cruiser0002/ResinShield/RS3C/BOM.xlsx

Item # | Ref Des | Description | Quantity | Manufacturer | Mfg Part # | Package | Type | Cost reduction
1 | U1 | IC REG MULT CONFIG INV | 1 | Linear | LT3579EFE#PBF | 20-TSSOP-EP | SMD
2 | U2 | IC REG LDO 5V 1A SOT223 | 1 | ON Semiconductor | NCP1117ST50T3G | SOT-223 | SMD | Compatible part
3 | U3 | Dual 12-Bit DAC | 1 | Linear | LTC2622CMS8#PBF | MS8 | SMD
4 | U4 | IC VREF SHUNT 4.096V | 1 | Texas Instruments | LM4040DIM3-4.1/NOPB | SOT-23 | SMD | Compatible part
5 | U5 | IC OPAMP JFET 4MHZ 14SO | 1 | STMicroelectronics | TL084CDT | 14-SOIC | SMD | Compatible part
6 | D1, D2 | DIODE SCHOTTKY 40V 2A SMB | 2 | Diodes Inc | B240-13-F | SMB | SMD | Compatible part
7 | D3 | DIODE ZENER 18V 200MW | 1 | ON Semiconductor | MM3Z18VST1G | SOD323 | SMD | Compatible part
8 | Q1 | MOSFET N-CH 20V 6.3A SOT-23 | 1 | Infineon | IRLML6244TRPBF | SOT23-3 | SMD | Compatible part
9 | R1, R4, R10, R29, R31, R32, R39, R40 | RES SMD 0.0OHM JUMPER 1/10W 0603 | 8 |  |  | 603 | SMD | Preserve case size, value, accuracy. Use cheapest source
10 | R3 | RES SMD 165K OHM 1% 1/10W 0603 | 1 |  |  | 603 | SMD | Preserve case size, value, accuracy. Use cheapest source
11 | R8, R11, R12, R17, R18, R19, R20, R21, R22, R23, R24, R25, R26, R27, R28, R34, R37 | RES SMD 100K OHM 1% 1/10W 0603 | 18 |  |  | 603 | SMD | Preserve case size, value, accuracy. Use cheapest source
12 | R7 | RES SMD 84.5K OHM 1% 1/10W 0603 | 1 |  |  | 603 | SMD | Preserve case size, value, accuracy. Use cheapest source
13 | R5, R9, R13, R42 | RES SMD 10K OHM 1% 1/10W 0603 | 3 |  |  | 603 | SMD | Preserve case size, value, accuracy. Use cheapest source
14 | R15, R35, R36 | RES SMD 25 OHM 1% 1/10W 0603 | 3 |  |  | 603 | SMD | Preserve case size, value, accuracy. Use cheapest source
15 | C2, C3, C4, C5, C12, C13, C18, C19, C23, C27, C28 | 22µF ±10% 25V X5R | 11 | Murata | GRM32ER61E226KE15L | 1210 | SMD | Preserve case size, value, accuracy. Use cheapest source
16 | C6 | 4700pF ±10% 50V X7R | 1 | Samsung | CL10B472KB8NNNC | 603 | SMD | Preserve case size, value, accuracy. Use cheapest source
17 | C7, C9, C10, C11, C14, C15, C22, C25, C26, C29 | 1µF -20%, +80% 50V Y5V | 10 | Samsung | CL21F105ZBFNNNE | 805 | SMD | Preserve case size, value, accuracy. Use cheapest source
18 | C8, C16, C17, C20, C21 | 47pF ±5% 50V C0G, NP0 Ceramic Capacitor | 5 | Samsung | CL10C470JB8NNNC | 603 | SMD | Preserve case size, value, accuracy. Use cheapest source
19 | T1, T2 | INDUCT ARRAY 2 COIL 10UH | 2 | Bourns | SRF0703-100M | Nonstandard | SMD
20 | J1 | 24 Positions Header, Unshrouded Connector 0.100" (2.54mm) Through Hole Gold | 1 | Wurth | 61302421121 | 12x2 MALE | Through-hole | Non-gold contacts.
21 | J2 | 10 Positions Header, Unshrouded Connector 0.100" (2.54mm) Through Hole Gold | 1 | Wurth | 61301011121 | 10x1 MALE | Through-hole | Non-gold contacts.
22 | J3-4 (optional) | CONN HEADER 3 POS 2.54 | 2 |  |  | 5x2 MALE | Through-hole
23 | J5 | 3 Positions Header, Unshrouded Connector 0.100" | 1 | MOLEX | 22272031 | 3x1 MALE | Through-hole | Non-gold contacts.
24 | J6-7 | 3 Position Receptacle Connector 0.098" (2.50mm) Through Hole Tin | 2 | JST | 03JQ-BT | 3x1 JST FEMALE | Through-hole
25 | J8 | 2 Positions Header, Shrouded Connector 0.098" (2.50mm) Through Hole Tin | 1 | JST | B2B-XH-A | 3x1 JST MALE | Through-hole
26 | J9 | 3 Positions Header, Unshrouded Connector 0.100" (2.54mm) Through Hole Gold | 1 | Wurth | 61300311121 | 3x1 MALE | Through-hole | Non-gold contacts.
27 | J10 | 4 Positions Header, Unshrouded Connector 0.100" (2.54mm) Through Hole Gold | 1 | Wurth | 61300411121 | 4x2 MALE | Through-hole | Non-gold contacts.
28 | J11-12 | Connector Receptacle 8 Position 0.100" (2.54mm) Tin Through Hole | 2 | Samtec Inc | SSW-108-03-T-S | 8x1 THROUGH HEADER | Through-hole | Non-gold contacts.
29 | J15 | 15 Positions Header, Unshrouded Connector 0.100" (2.54mm) Through Hole Gold | 1 | Wurth | 61301511121 | 15x1 MALE | Through-hole | Non-gold contacts.
