cruiser0002/ResinShield/documentation/BOM.xlsx

 |  |  |  |  |  |  |  |  | 11.02
Resin Shield
Item # | Ref Des | Description | Quantity | Manufacturer | Mfg Part # | Package | Type | Cost Reduction Method |  | Second source
1 | U1 | IC REG BOOST ADJ 2A 8MSOP | 1 | Semtech | SC4501MSETRT | 8-MSOP-EP | SMD | Cost Reduce | 1.73
2 | U2 | IC REG MULT CONFIG INV ADJ 8MSOP | 1 | Linear | LT3580EMS8E#TRPBF | 8-MSOP-EP | SMD | Cost Reduce | 4.22
3 | U3 | IC REG LDO ADJ 1A SOT223 | 1 | ON Semi | NCP1117STAT3G | SOT-223 | SMD | Part Substitution | 0.49
4 | U4 | IC DAC 12BIT DUAL R-R VOUT 8MSOP | 1 | Linear | LTC2622CMS8#PBF | 8-MSOP | SMD | Cost Reduce | 3.34
5 | U5 | IC VREF SHUNT 5V SOT23-3 | 1 | Texas Instruments | LM4040D50IDBZR | SOT-23-3 | SMD | Part Substitution | 0.72 | LM4040DYM3-5.0 TR
6 | U6 | IC OPAMP JFET 1MHZ 14SOIC | 1 | Texas Instruments | TL064CDR | SOT-23-3 | SMD | Part Substitution | 0.52
7 | D1, D2 | DIODE SCHOTTKY 40V 1A SMB | 1 | Diodes Inc | B140B-13-F | SMB | SMD | Part Substitution
8 | Q1 | MOSFET N-CH 20V 6.3A SOT-23 | 1 | International Rectifier | IRLML6244TRPBF | SOT23-3 | SMD | Part Substitution
 |  | MOSFET P-CH 20V 3.7A SOT-23 | 1 | International Rectifier | IRLML6402TRPBF | SOT23-3 | SMD | Part Substitution
 | R1, 4, 20, 24 | RES SMD 8.87K OHM 1% 1/10W 0603 | 4 | Yageo | RC0805FR-078K87L | 0603 | SMD | Part Substitution
 | R2, 5-19, 21-23, 25-27 | RES SMD 100K OHM 1% 1/10W 0603 | 22 | Yageo | RC0805FR-07100KL | 0603 | SMD | Part Substitution
 | R3 | RES SMD 182K OHM 1% 1/8W 0805 | 1 | Yageo | RC0805FR-07182KL | 0603 | SMD | Part Substitution
 | C26-29, 31 | CAP CER 47PF 50V 5% NPO 0805 | 5 | Yageo | CC0805JRNPO9BN470 | 0603 | SMD | Part Substitution
 | C3, 9, 10 | CAP CER 4700PF 50V 10% X7R 0805 | 3 | Yageo | CC0805KRX7R9BB472 | 0603 | SMD | Part Substitution
 | C5 | CAP CER 1UF 50V Y5V 0805 | 1 | Taiyo Yuden | UMK212F105ZG-T | 0805 | SMD | Part Substitution
 | C1, 2, 4, 7, 8, 11, 13, 20, 22 | CAP CER 10UF 50V 20% X5R 1210 | 9 | Taiyo Yuden | UMK325BJ106MM-T | 1210 | SMD | Part Substitution
 | L1 | FIXED IND 5.6UH 3.6A 48 MOHM SMD | 1 | Wurth | 74437346056 | 7.30mm x 6.60mm | SMD | Part Substitution
 | L2 | FIXED IND 10UH 3A 85 MOHM SMD | 1 | Wurth | 74437346100 | 7.30mm x 6.60mm | SMD | Part Substitution
 | L3 | FIXED IND 22UH 1.9A 190 MOHM SMD | 1 | Wurth | 74437346220 | 7.30mm x 6.60mm | SMD | Part Substitution
 | JP3-9, 13 | CONN HEADER 3 POS 2.54 | 8 | Wurth | 61300311121 | 3x1 HEADER | Through-hole | Part Substitution
 | JP1 | CONN HEADER VERT DUAL 6POS 2.54 | 1 | Wurth | 61300621121 | 3x2 HEADER | Through-hole | Part Substitution
 | JP2, 10, 14 | CONN HEADER 4 POS 2.54 | 3 | Wurth | 61300411121 | 4x1 HEADER | Through-hole | Part Substitution
 | Arduino Mega | CONN HEADER 6 POS 2.54 | 1 | Wurth | 61300611121 | 6x1 HEADER | Through-hole | Part Substitution
 | Arduino Mega | CONN HEADER 8 POS 2.54 | 4 | Wurth | 61300811121 | 8x1 HEADER | Through-hole | Part Substitution
 | A4988 Carrier | Connector Header 8 Position 0.100" (2.54mm) Tin Through Hole | 2 | Sullins Connector Solutions | PPTC081LFBN-RC | 8x1 HEADER | Through-hole | Part Substitution
 | LCD HEADERS |  |  |  |  | 10x2 HEADER
 | Arduino Mega | CONN HEADER VERT DUAL 36POS 2.54 | 1 | Wurth | 61303621121 | 18x2 HEADER | Through-hole | Part Substitution
 | JP1 | JUMPER W/TEST PNT 1X2PINS 2.54MM | 3 | Wurth | 60900213421 | 1x2 JUMPER |  | Part Substitution
 | Plugs into headers | A4988 Stepper Motor Driver | 1 | SainSmart | 20-011-964 | Complete board |  | Part Substitution
 | Plugs into headers | Arduino Mega 2560 | 1 | SainSmart | 20-011-910 | Complete board |  | Part Substitution
