cruiser0002/ResinShield/RevF/BOM.xlsx

 | RefDes | Name | Value | Description | Quantity | Pattern | Manufacturer | MPN
Fitted | C101, C102, C104, C108, C110, C113, C117, C118, C208, C209 | CAP_0805 | 10u | CAP CER 10UF 25V X5R 0805 | 10 | CAP_0805 |  | GRM21BR61E106KA73K | 99
Fitted | C103, C105, C112, C114, C115, C116, C202, C206, C207, C210, C301, C401 | CAP_0805 | 1u | CAP CER 1UF 35V X5R 0805 | 12 | CAP_0805 |  | GRM219R7YA105MA12D | 18
Fitted | C106, C109, C201, C203, C204, C205, C403 | CAP_0603 | 100p | CAP CER 100PF 50V C0G/NP0 0603 | 7 | CAP_0603 |  | C0805C101J5GACTU
Fitted | C107, C111 | CAP_0603 | 6.8n | CAP CER 6800PF 50V C0G/NP0 0603 | 2 | CAP_0603 |  | CL21B682KBANNNC
Fitted | C302, C303 | CAP_1210 | 22u | CAP CER 22UF 16V X5R 1210 | 2 | CAP_1210 |  | CL32A226MOJNNNE
Not-fitted | C402, C502 | CAP_0805 | opt |  | 2 | CAP_0805
Not-fitted | C501 | CAP_1210 | opt |  | 1 | CAP_1210
Fitted | D101, D104 | PMEG4020ETP |  |  | 2 | SOD-128 | Nexperia | PMEG4020ETP,115
Fitted | D102, D103, D401 | APL3015SRCPRV-F01 |  |  | 3 | APL3015 | Kingbright | APL3015SRCPRV-F01
Not-fitted | D501, D502 | PMEG4020ETP | opt |  | 2 | SOD-128
Fitted | FB101, FB102, FB201, FB301 | BLM18KG221SN1D | 220 @ 100MHz |  | 4 | RES_0603 | Murata | BLM18KG221SN1D
Not-fitted | FD1, FD2, FD3 | Fiducial |  |  | 3 | Fiducial
Fitted | J1, J2, J4, J5, J7, J8 | 644456-8 |  |  | 6 | HDR-1x8T/2.54/20x2 | TE Connectivity | 3-644456-8
Fitted | J3 | 90131-0138 |  |  | 1 | HDR-2x18T/2.54x2.54/46x5 | Molex | 90131-0138
Not-fitted | J6, J9 | 90131-0125 | opt |  | 2 | HDR-2x5T/2.54x2.54/13x5 | Molex | 90131-0125
Not-fitted | J10, J203 | 644456-4 | opt |  | 2 | HDR-1x4T/2.54/10x2 | TE Connectivity | 61300411121
Fitted | J11, J12, J13, J301 | 644456-4 |  |  | 4 | HDR-1x4T/2.54/10x2
Fitted | J101 | 22272031 |  |  | 1 | Molex 3pin | Molex | 0022272031
Fitted | J201, J202 | B3B-XH-A |  |  | 2 | JST B3B-XH-A | JST | B3B-XH-A(LF)(SN)
Fitted | J302, J303 | PPTC081LFBN-RC |  |  | 2 | HDR-1x8T/2.54/20x2 | Sullins | PPTC081LFBN-RC
Fitted | J401, J402 | B2B-XH-A |  |  | 2 | JST B2B-XH-A | JST | B2B-XH-A(LF)(SN)
Not-fitted | J501 | OSTVN04A150 | opt |  | 1 | TB-1x4/2.54/11x7/Sc_H | On Shore | OSTVN04A150
Not-fitted | J502 | 644456-2 | opt |  | 1 | HDR-1x2T/2.54/5x2 | TE Connectivity | 3-644456-2
Fitted | Q401, Q402, Q403 | 2N7002 |  |  | 3 | SOT23 | Diodes | 2N7002-7-F
Not-fitted | Q501, Q502 | IRLZ44N | opt |  | 2 | TO-220 | Infineon | IRLZ44NPBF
Not-fitted | R1, R302, R304, R305, R306, R307, R406, R501, R502, R503, R504, R505 | RES_0603 | opt |  | 12 | RES_0603
Fitted | R101, R115 | RES_1210 | 0 | RES SMD 0 OHM JUMPER 1/2W 1210 | 2 | RES_1210 |  | CRCW12100000Z0EA
Fitted | R102, R103, R108, R205, R210 | RES_0603 | 49k9 | RES SMD 49.9K OHM 1% 1/10W 0603 | 5 | RES_0603 |  | ERJ-3EKF4992V
Fitted | R104, R106, R112, R113, R202, R203, R204, R206, R207, R208, R209, R211, R401, R403, R404 | RES_0603 | 100k | RES SMD 100K OHM 1% 1/10W 0603 | 15 | RES_0603 |  | AT0603FRE07100KL
Fitted | R105, R114 | RES_0603 | 464k | RES SMD 464K OHM 1% 1/10W 0603 | 2 | RES_0603 |  | RC0603FR-07464KL
Fitted | R107, R111, R402 | RES_0603 | 24k9 | RES SMD 24.9K OHM 1% 1/10W 0603 | 3 | RES_0603 |  | ERJ-3EKF2492V
Fitted | R109, R405 | RES_0603 | 6k04 | RES SMD 6.04K OHM 1% 1/10W 0603 | 2 | RES_0603 |  | ERJ-3EKF6041V
Fitted | R110 | RES_0603 | 53k6 | RES SMD 53.6K OHM 1% 1/10W 0603 | 1 | RES_0603 |  | RC0603FR-0753K6L
Fitted | R201 | RES_0603 | 1k | RES SMD 1K OHM 1% 1/10W 0603 | 1 | RES_0603 |  | ERJ-3EKF1001V
Fitted | R212, R213 | RES_0603 | 24r9 | RES SMD 24.9 OHM 1% 1/10W 0603 | 2 | RES_0603 |  | ERJ-3EKF24R9V
Fitted | R301, R303 | RES_0603 | 0 | RES SMD 0 OHM JUMPER 1/10W 0603 | 2 | RES_0603 |  | ERJ-3GEY0R00V
Fitted | R407 | RES_0603 | 18r2 | RES SMD 18.2 OHM 1% 1/10W 0603 | 1 | RES_0603 |  | ERJ-3EKF18R2V
Fitted | T101, T102 | SRF1260-150M | 15uH |  | 2 | SRF1260 | Bourns | SRF1260-150M
Not-fitted | TP101, TP102, TP103, TP201, TP202, TP203, TP204, TP205, TP206, TP207, TP208, TP501, TP502, TP503 | TESTPOINT |  |  | 14 | Round
Fitted | U101 | LT8582 |  |  | 1 | 4x7DFN | Linear Technology | LT8582EDKD#PBF
Fitted | U102 | NCP1117ST50T3G |  |  | 1 | SOT223-4 | ON Semi | NCP1117ST50T3G
Fitted | U201 | LM4040DIM3-4.1 |  |  | 1 | SOT23 | Texas Instruments | LM4040DIM3-4.1/NOPB
Fitted | U202 | TL084D |  |  | 1 | SOIC-14/150mil | Texas Instruments | TL084CDR
Fitted | U203 | LTC2602CMS8 |  |  | 1 | MSOP-8 | Linear Technology | LTC2622CMS8#PBF
Fitted | U401 | LM321MF |  |  | 1 | SOT23-5 | Texas Instruments | LM321MF/NOPB
Not-fitted | X1 | Arduino Mega |  |  | 1
Not-fitted | X301 | A4988 Carrier |  |  | 1
