cruiser0002/ResinShield/fab notes/Projection symbols.dxf

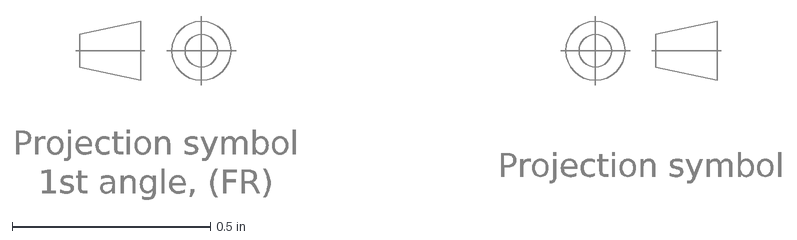
[picture p1: CAD file, 2016-10-16]
fab notes/Projection symbols.dxf
Projection symbol 1st angle, (FR)
Projection symbol\p3rd angle, (US)
