cruiser0002/ResinShield/RS3C/fabnotes.dxf

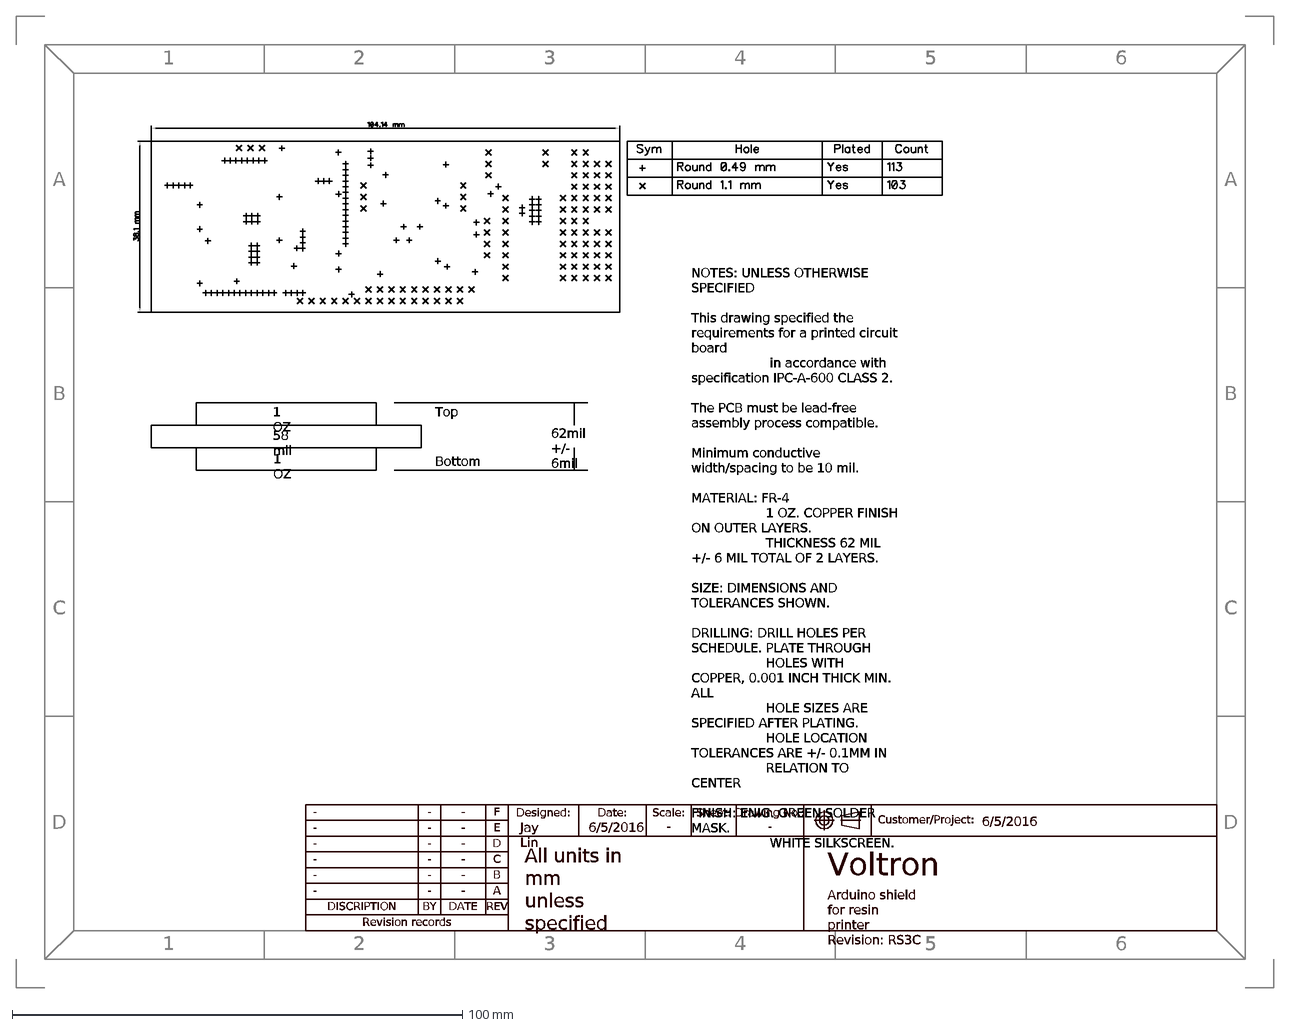
[picture p2: CAD file, 2016-10-16]
RS3C/fabnotes.dxf
1
A
2
3
4
5
6
B
C
D
-
Revision records
DISCRIPTION
BY
DATE
REV
E
F
Customer/Project:
Drawing No.:
Designed:
Date:
Scale:
Sheet:
All units in mm unless specified
Voltron Arduino shield for resin printer Revision: RS3C
6/5/2016
Jay Lin
Bottom
58 mil
62mil +/- 6mil
Top
1 OZ
NOTES: UNLESS OTHERWISE SPECIFIED This drawing specified the requirements for a printed circuit board in accordance with specification IPC-A-600 CLASS 2. The PC
