cruiser0002/ResinShield/fab notes/ANSI A Landscape.dxf

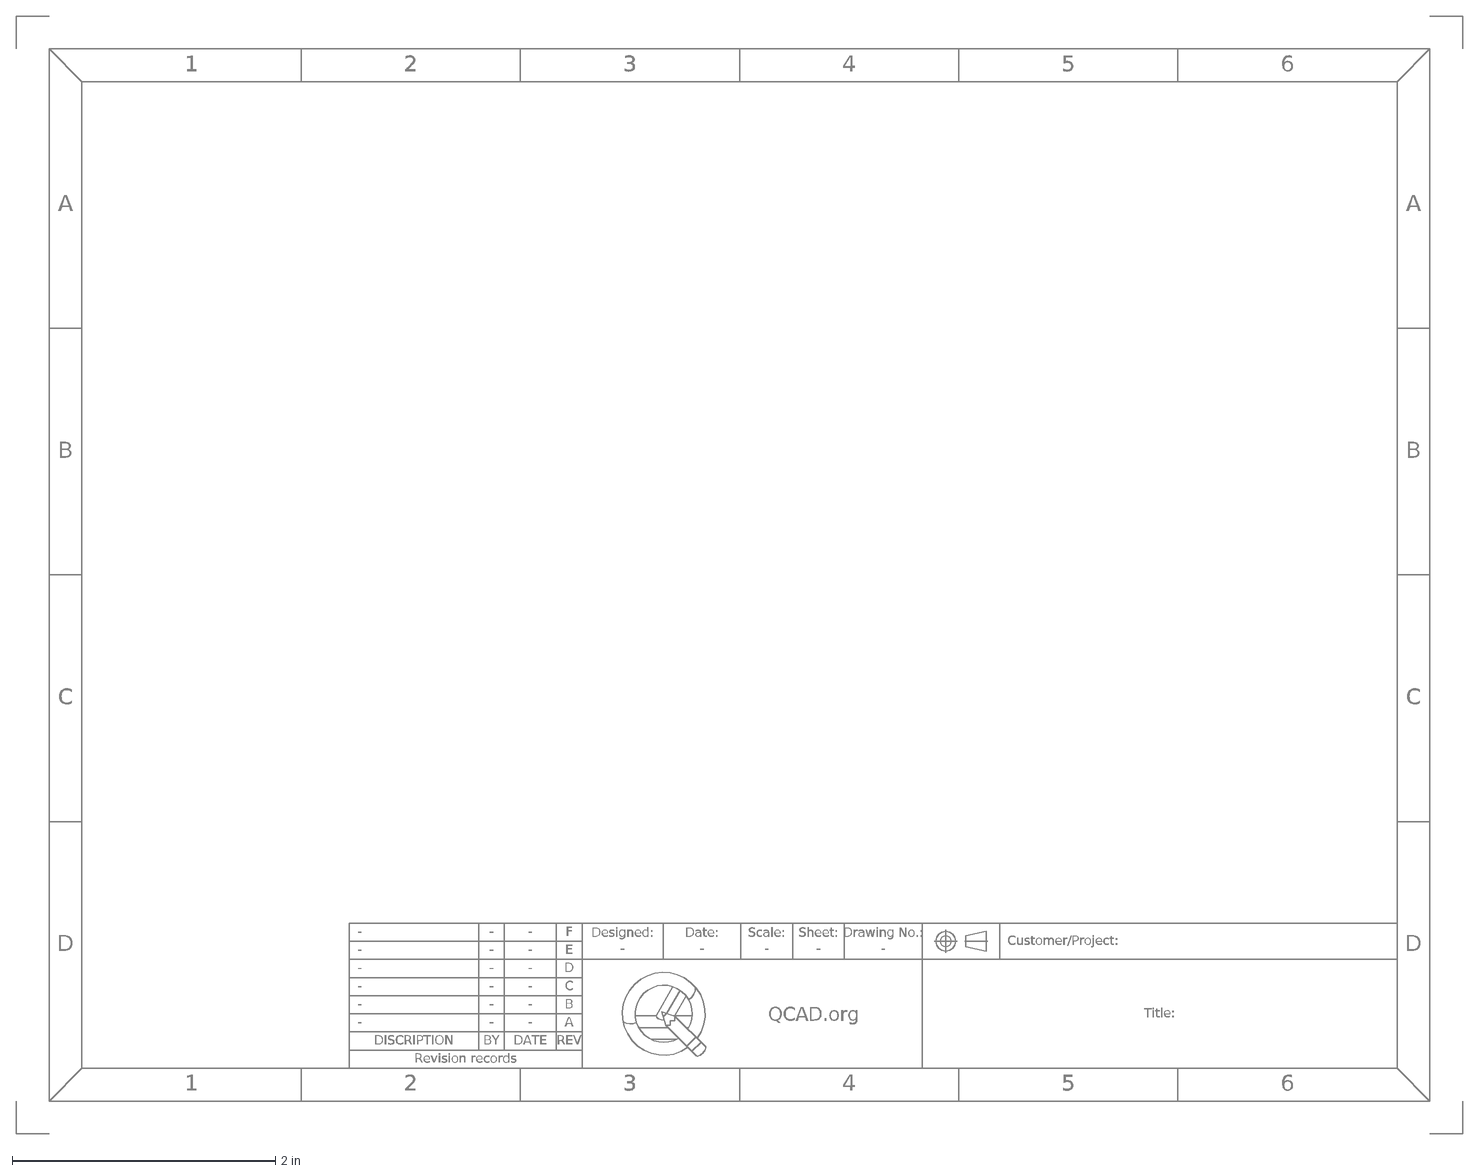
[picture p3: CAD file, 2016-10-16]
fab notes/ANSI A Landscape.dxf
1
A
2
3
4
5
6
B
C
D
-
Revision records
DISCRIPTION
BY
DATE
REV
E
F
Title:
Customer/Project:
Drawing No.:
Designed:
Date:
Scale:
Sheet:
QCAD.org\pOpen source CAD
