cruiser0002/ResinShield/fab notes/ANSI B Landscape.dxf

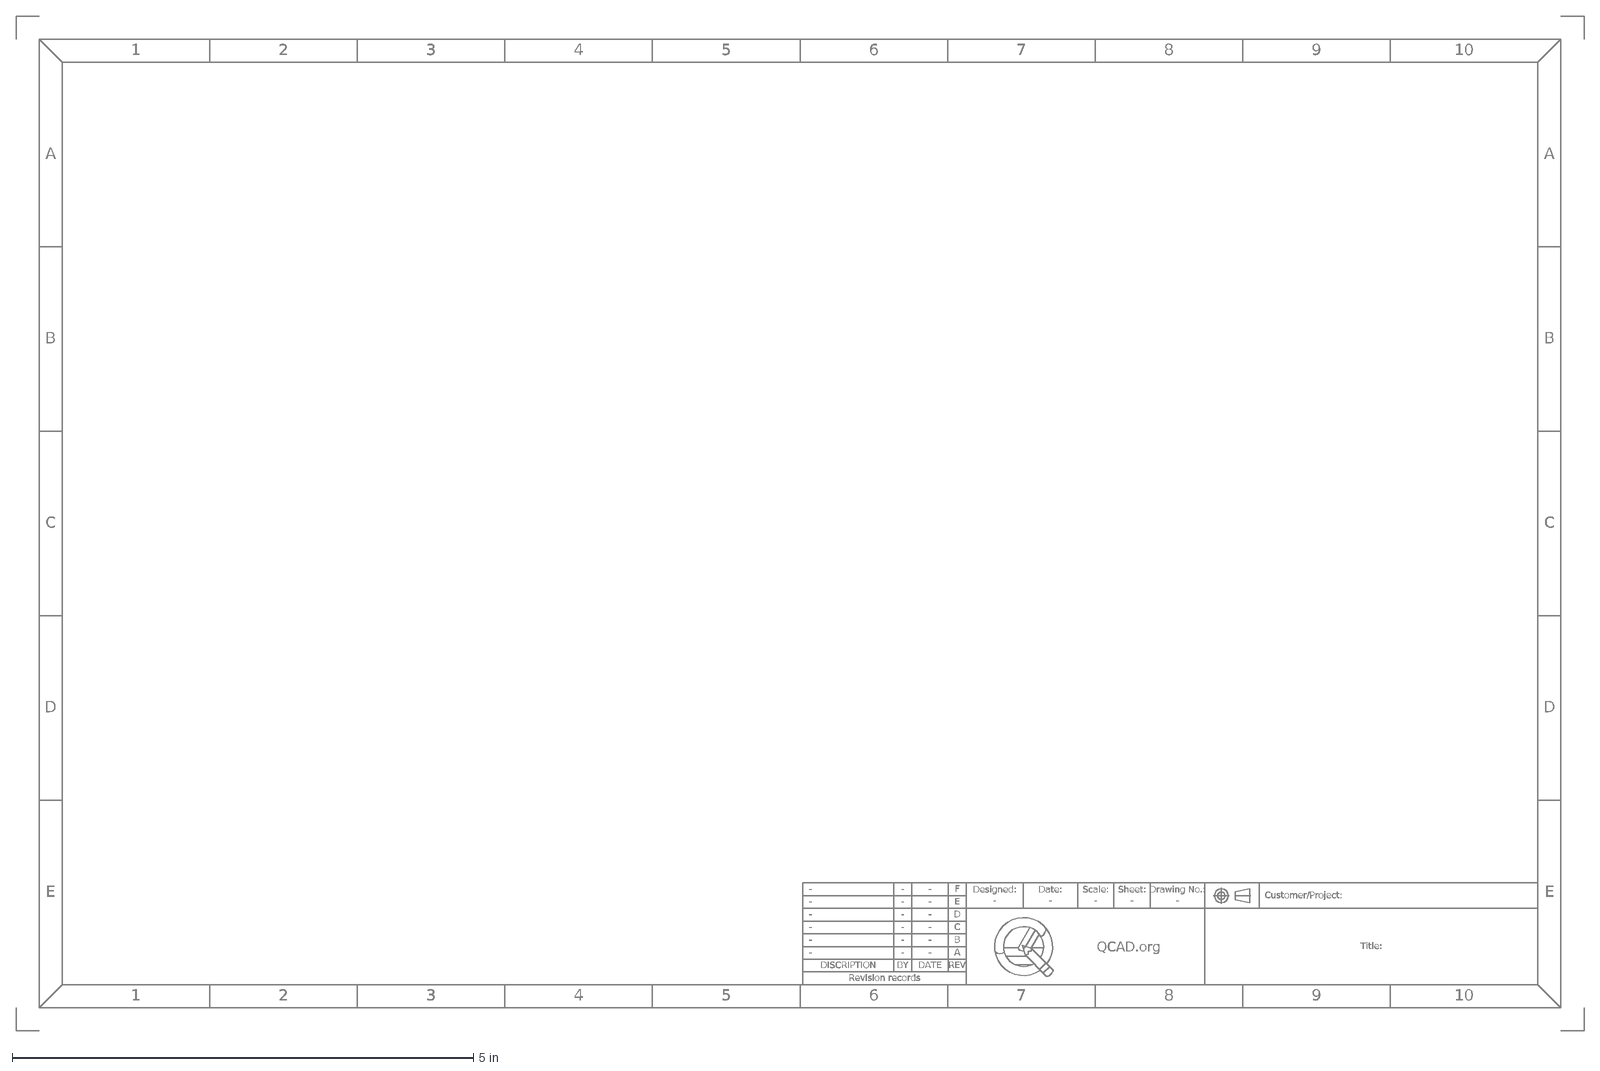
[picture p4: CAD file, 2016-10-16]
fab notes/ANSI B Landscape.dxf
E
1
D
C
B
A
2
3
4
5
6
7
8
9
10
-
Revision records
DISCRIPTION
BY
DATE
REV
F
Title:
Customer/Project:
Drawing No.:
Designed:
Date:
Scale:
Sheet:
QCAD.org\pOpen source CAD
