cruiser0002/ResinShield/fab notes/ANSI A Portrait.dxf

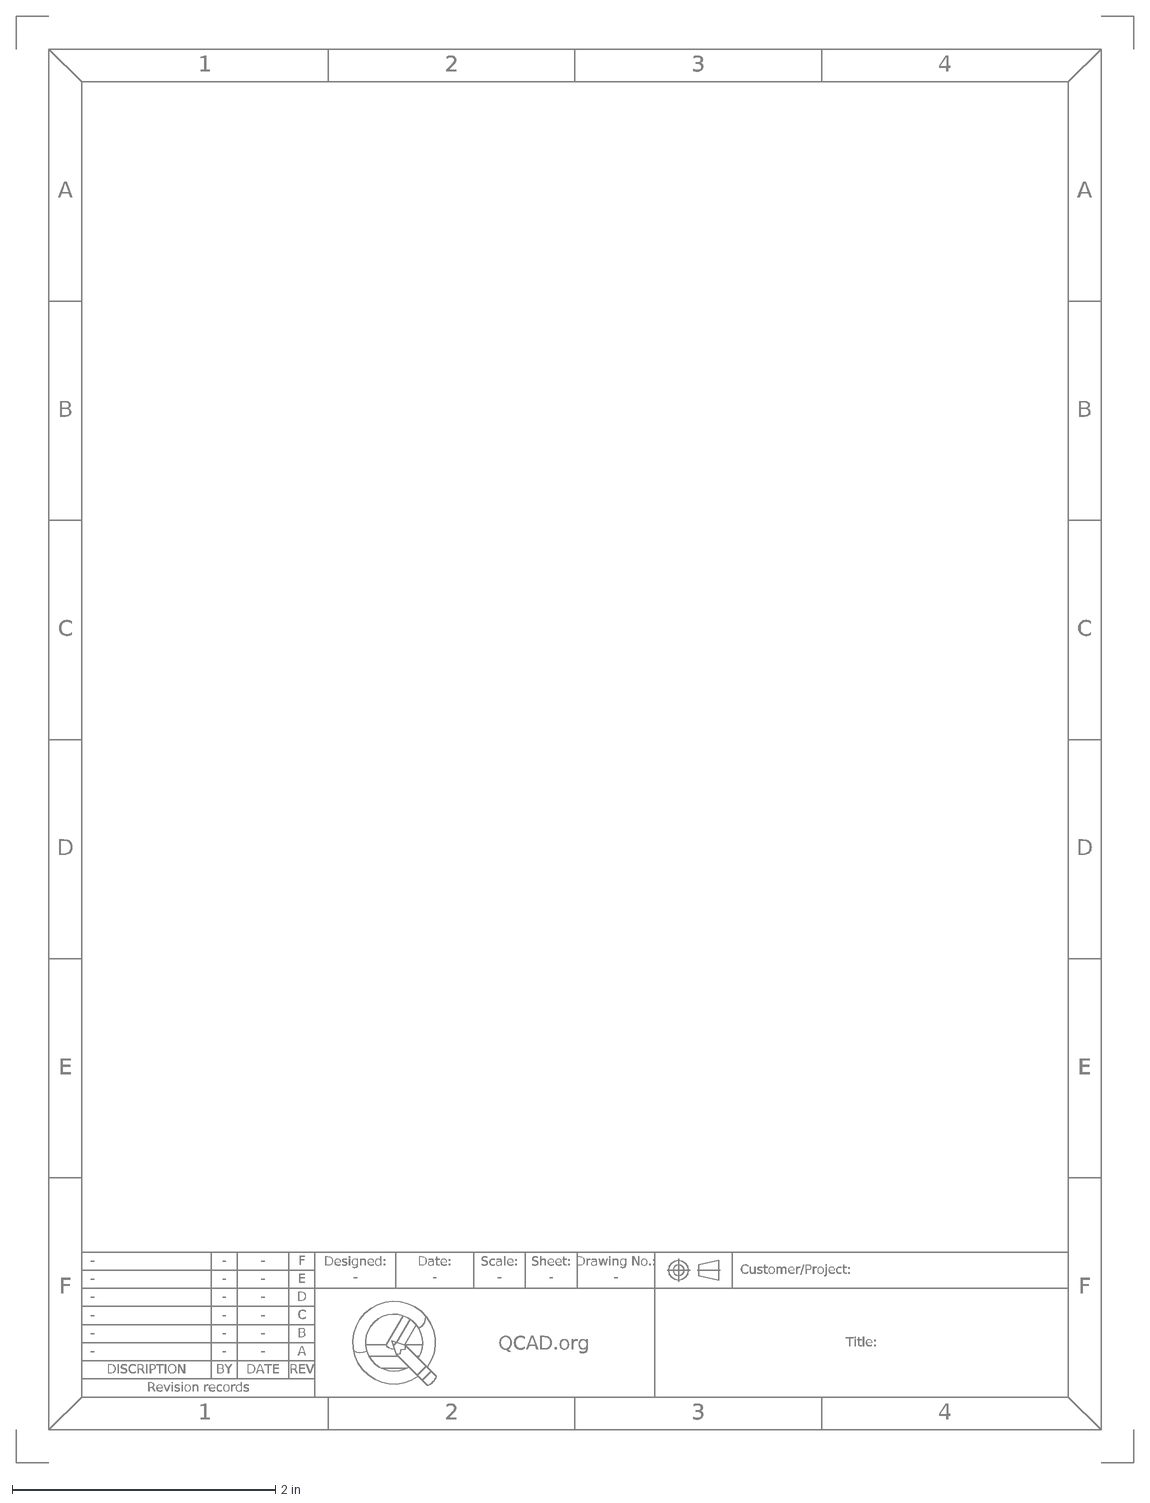
[picture p5: CAD file, 2016-10-16]
fab notes/ANSI A Portrait.dxf
A
1
2
3
4
B
C
D
E
F
-
Revision records
DISCRIPTION
BY
DATE
REV
Title:
Customer/Project:
Drawing No.:
Designed:
Date:
Scale:
Sheet:
QCAD.org\pOpen source CAD
