cruiser0002/ResinShield/(list of files, cad)

Other CAD files:
documentation/dimensioni Mega.dxf
fab notes/ANSI C Landscape.dxf
fab notes/ANSI E Landscape.dxf
fab notes/ANSI D Landscape.dxf
