cruiser0002/ResinShield/documentation/RRD_FULL_GRAPHIC_SMART_CONTROLER_SCHEMATIC.pdf

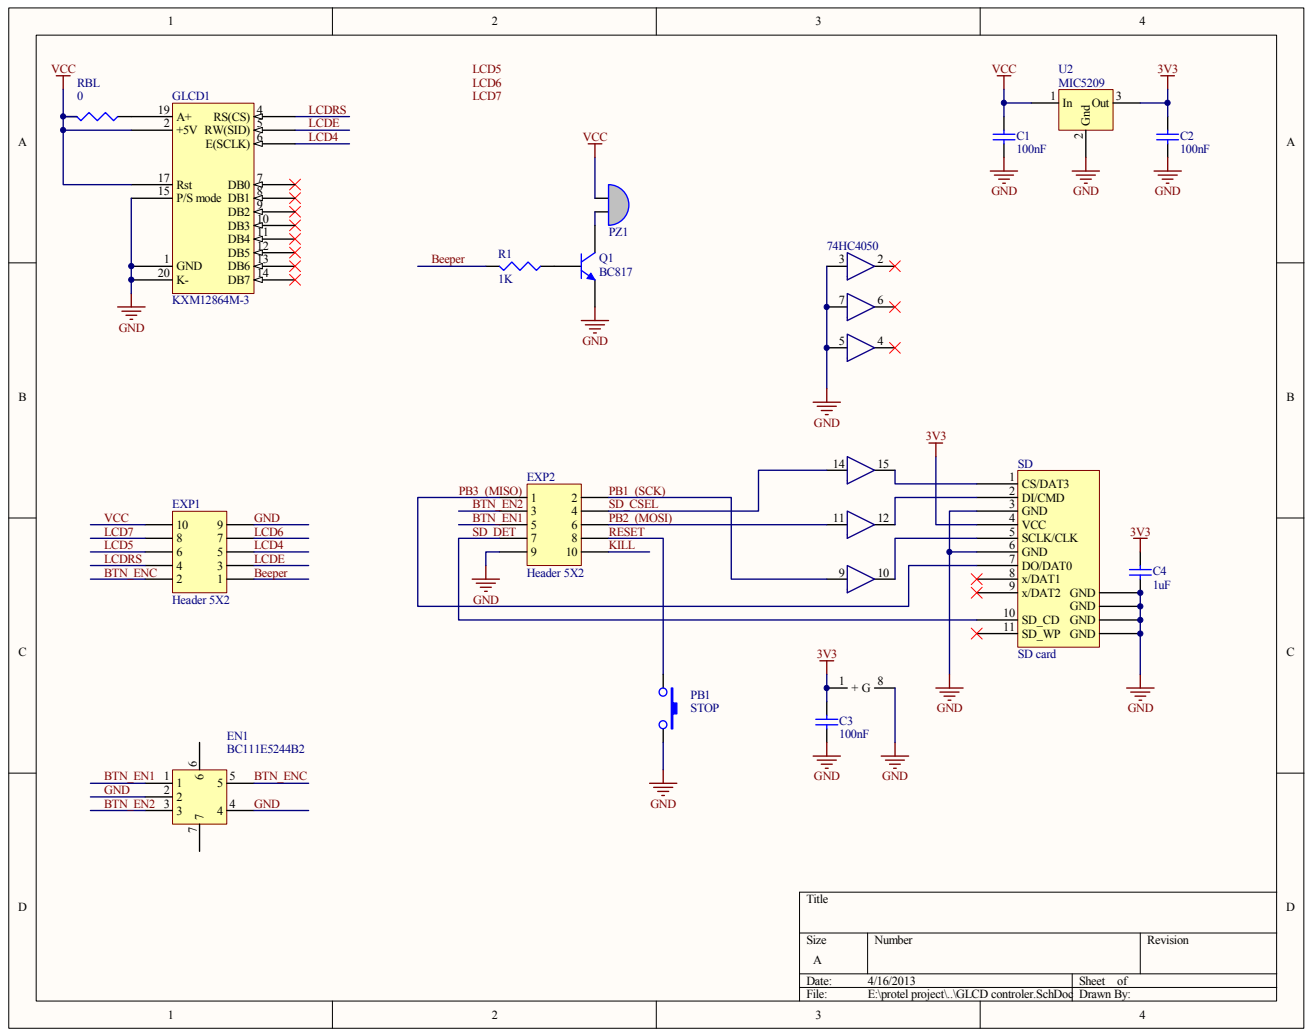
[picture p6: page 1]
Title; Size; Number; Revision; Date:; Sheet of; File:; E:\protel project\..\GLCD controler.SchDoc; Drawn By:; EXP1; Header 5X2; VCC LCD7 LCD5 LCDRS; GND LCD6 LCD4 LCDE Beeper; LCD4; LCD5 LCD6 LCD7; LCDE; LCDRS; GND; VCC; BTN_ENC; EXP2; BTN_EN2 BTN_EN1 SD_DET; SD_CSEL; PB3_(MISO); PB1_(SCK); PB2_(MOSI) RESET KILL; CS/DAT3 1 DI/CMD 2 GND 3 VCC 4 SCLK/CLK 5 GND 6 DO/DAT0 7 x/DAT1 8 x/DAT2 9; GND GND GND GND; SD card; Gnd; Out 3; U2 MIC5209; PB1 STOP; BTN_EN1; BTN_EN2; RS(CS) 4 RW(SID) 5 E(SCLK) 6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
