cruiser0002/ResinShield/RevF/DipTrace Schematic - resinshield.pdf

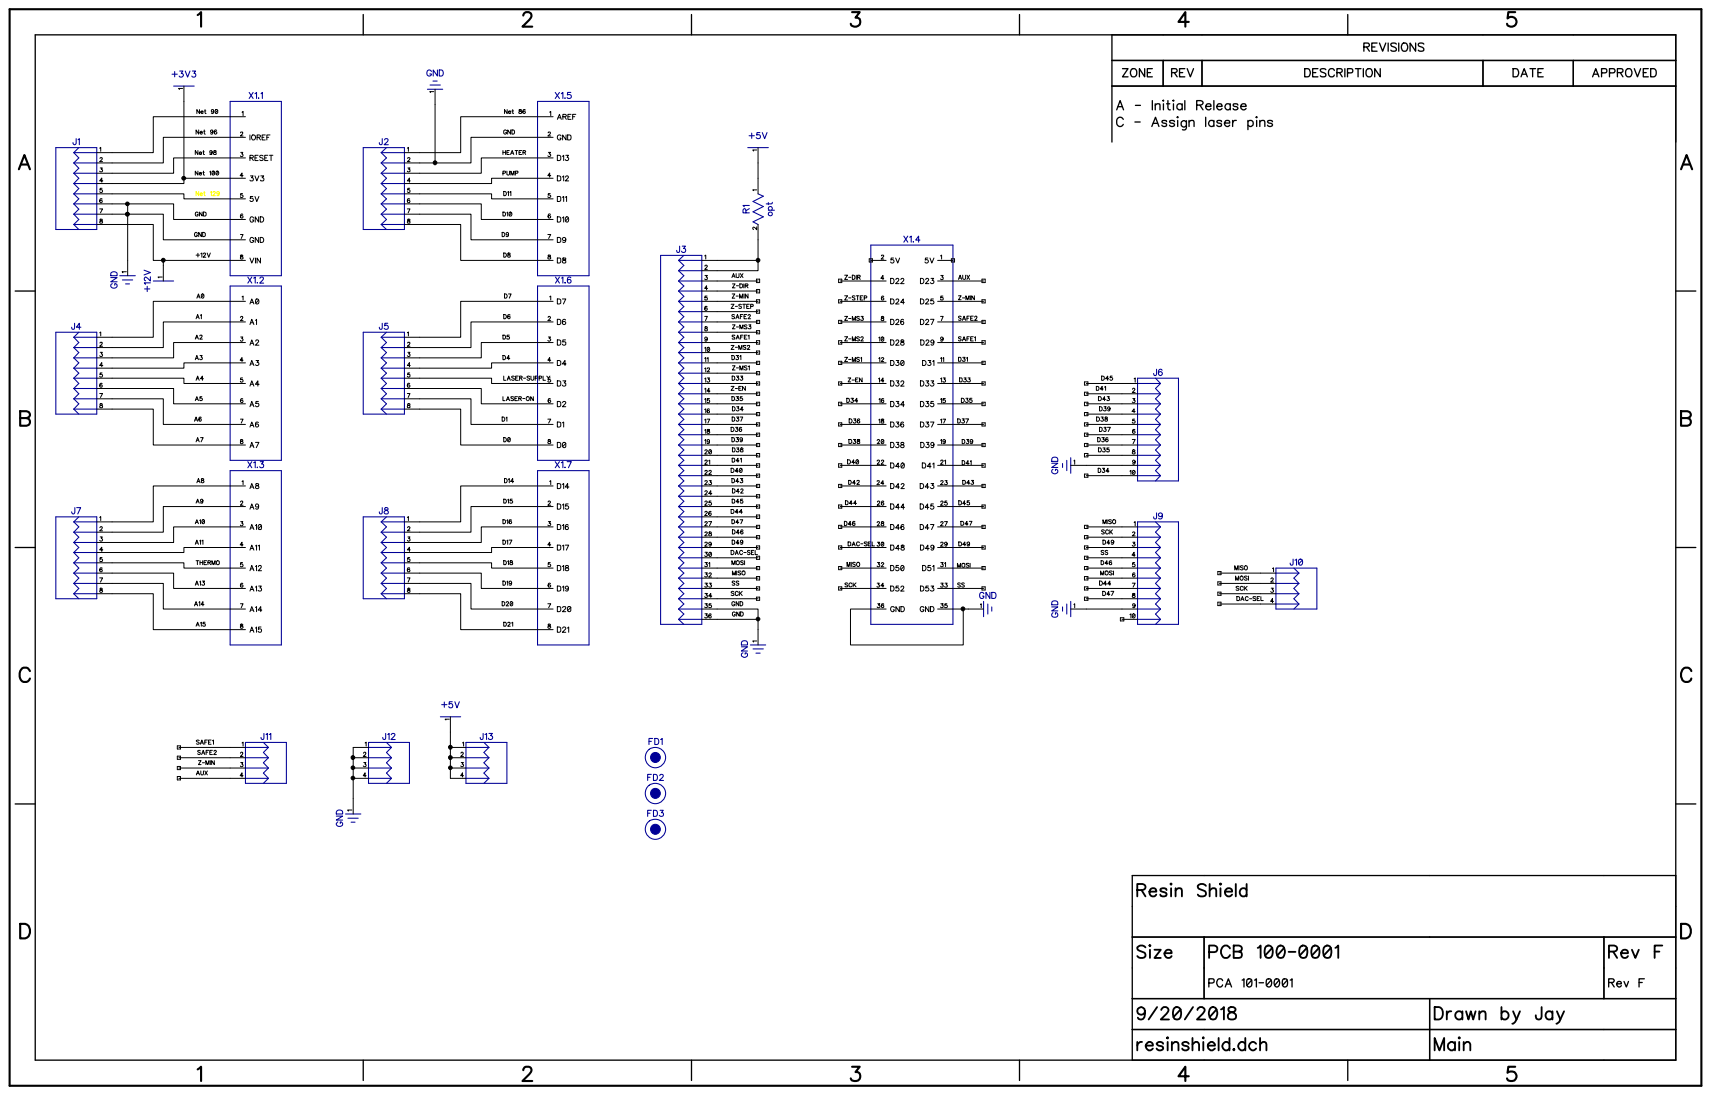
[picture p8: page 1]

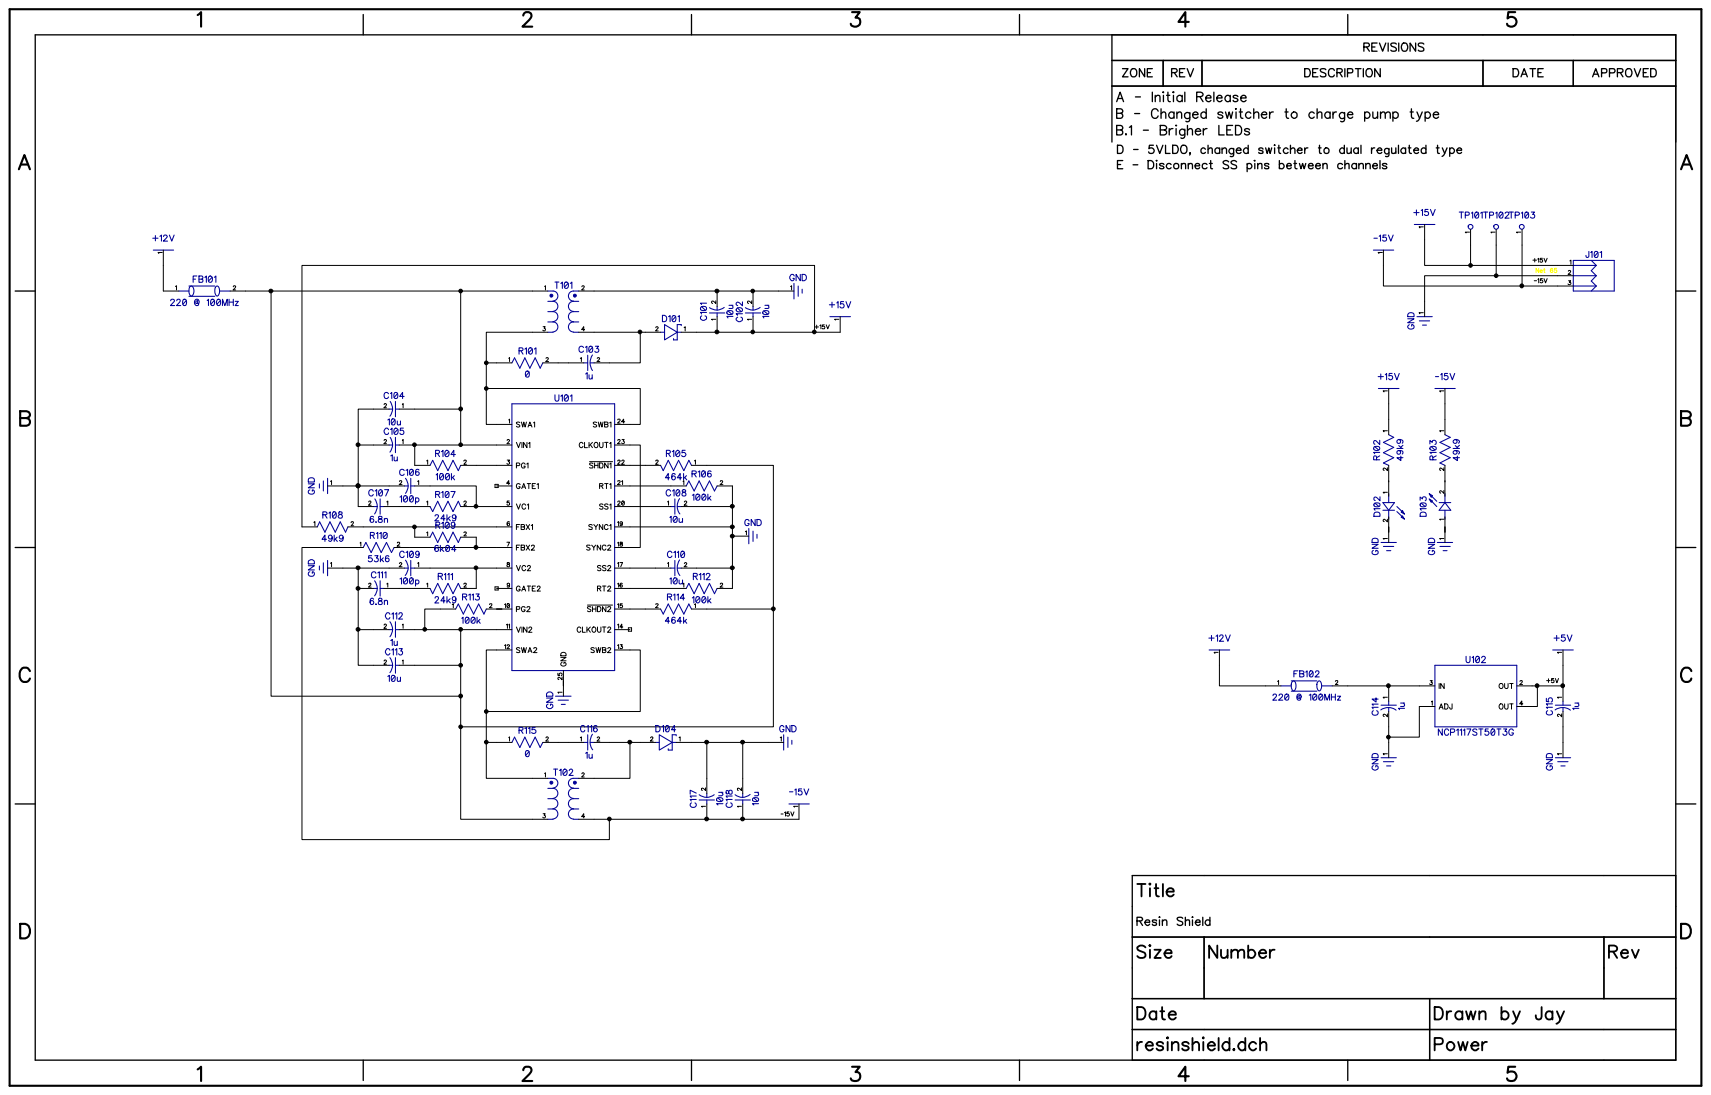
[picture p9: page 2]

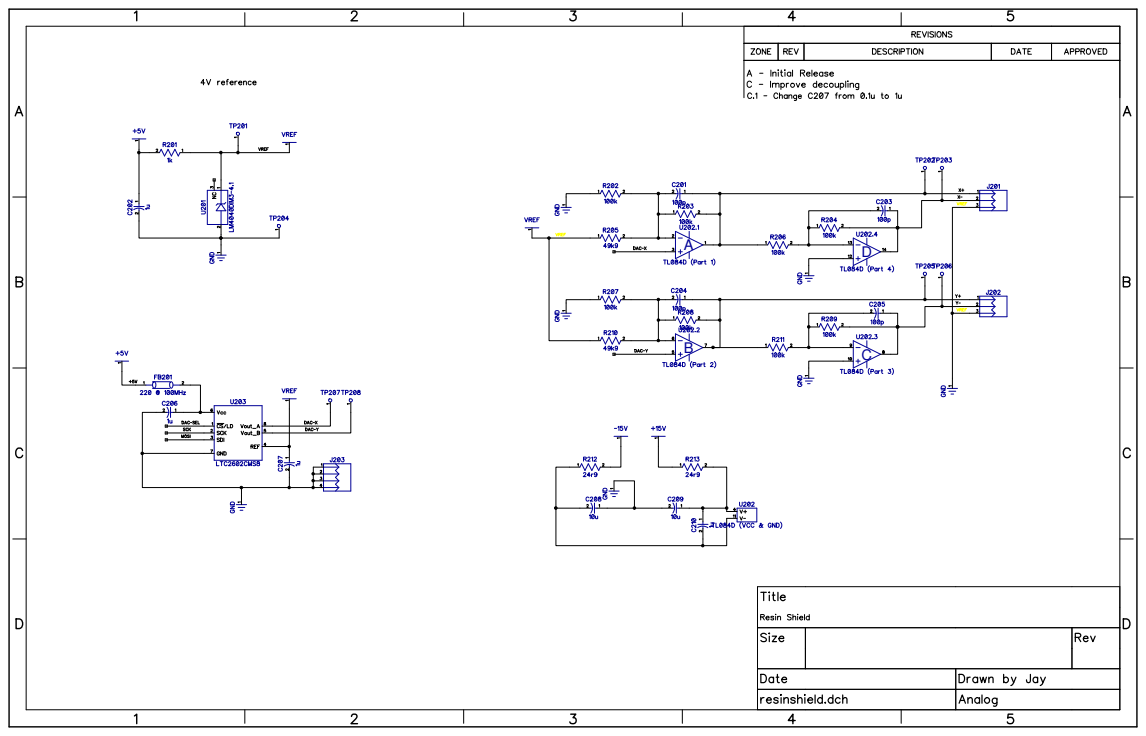
[picture p10: page 3]

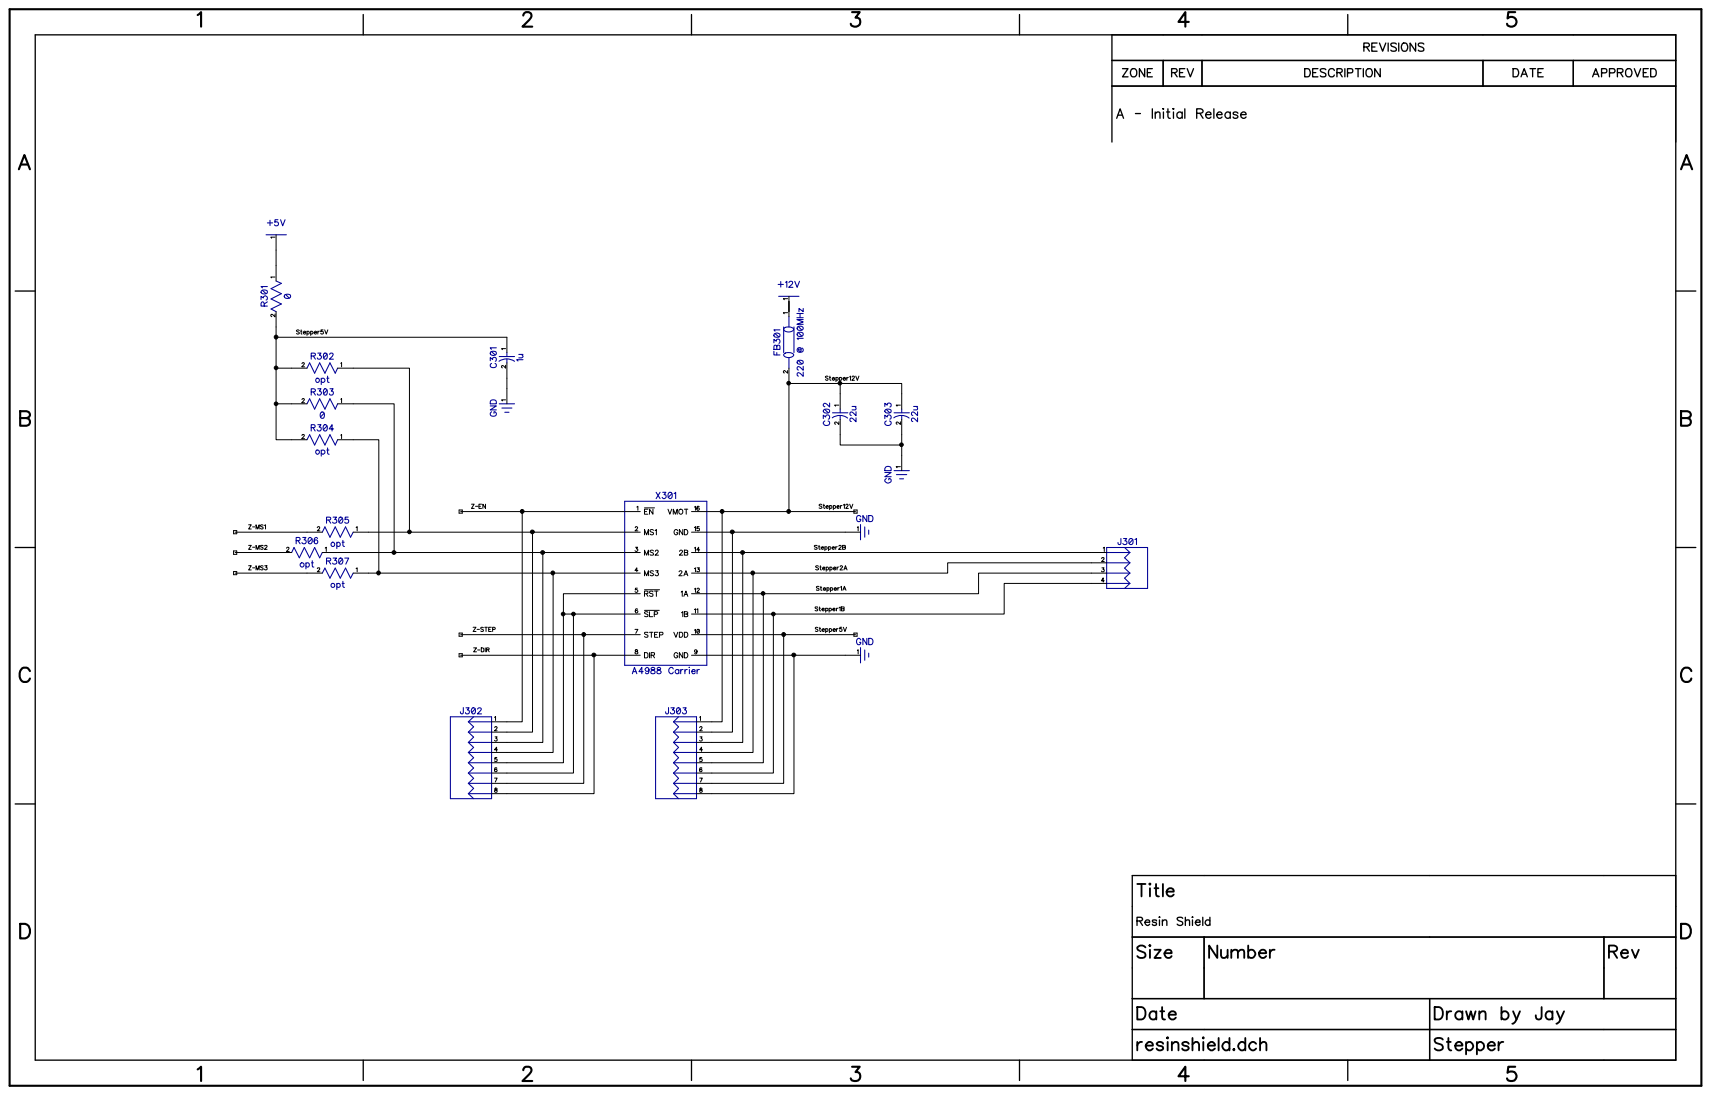
[picture p11: page 4]

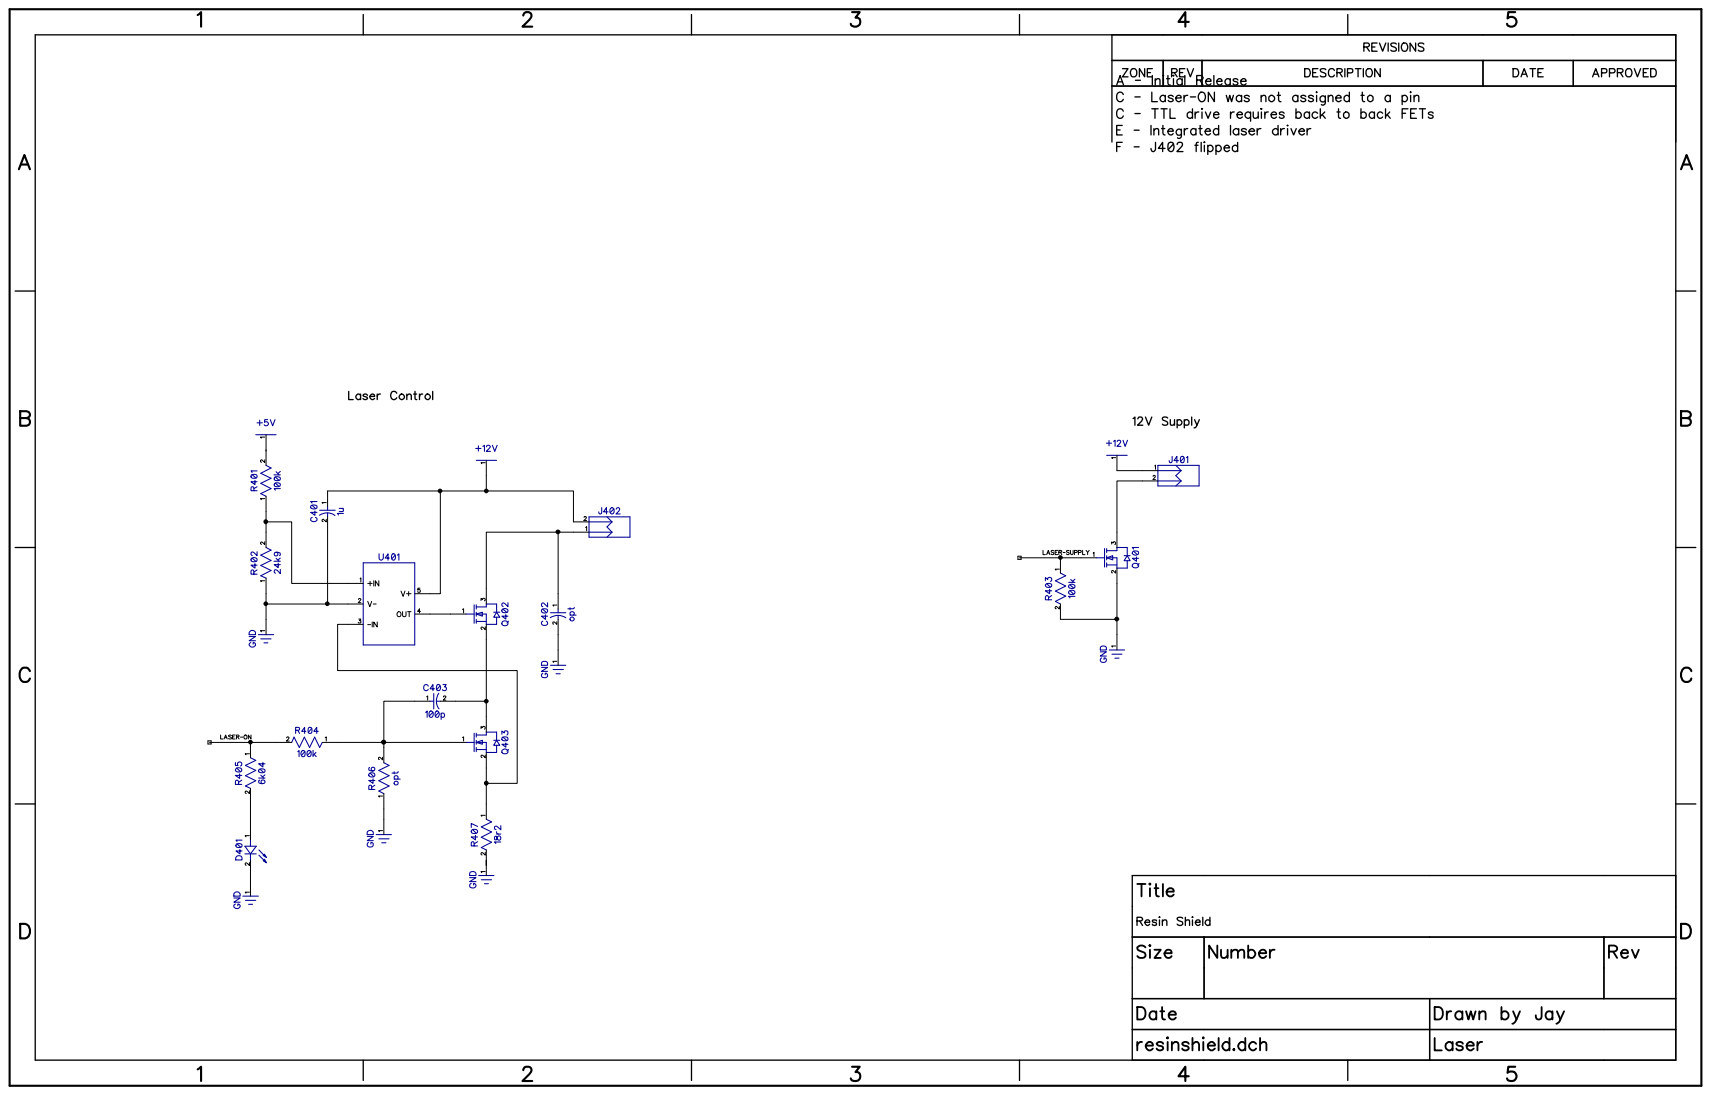
[picture p12: page 5]

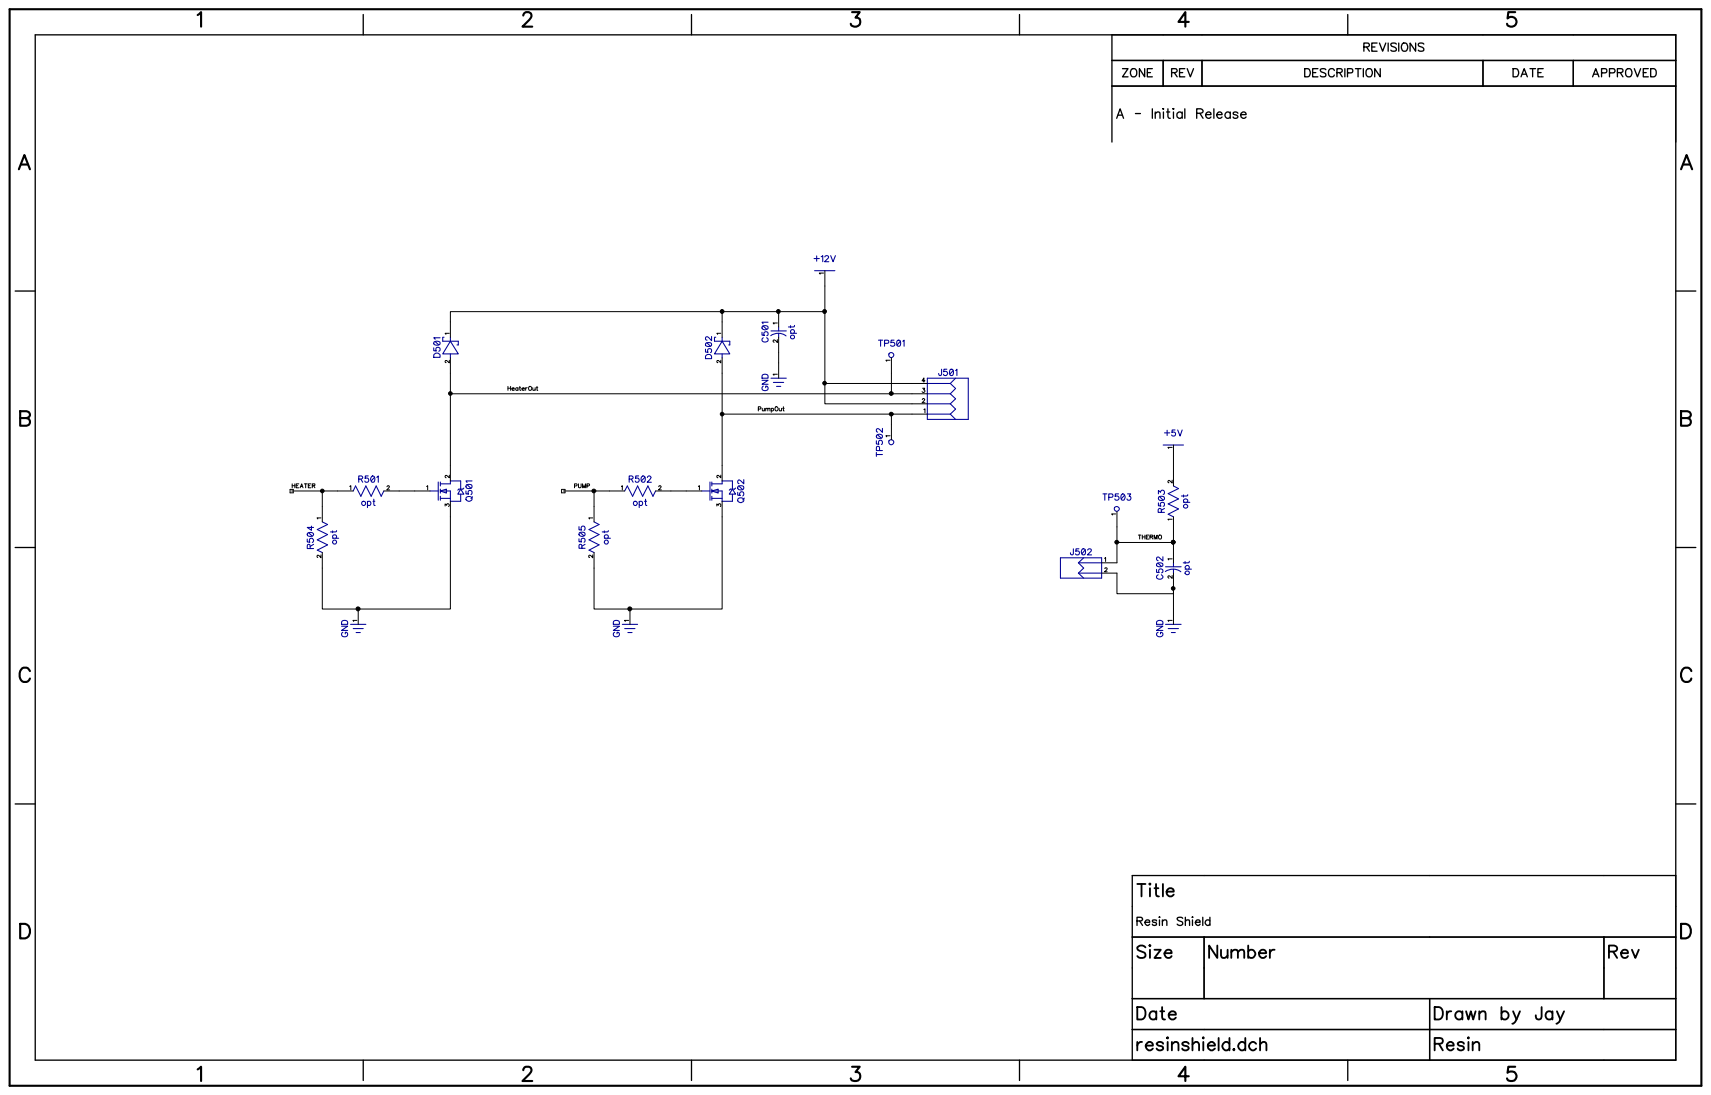
[picture p13: page 6]

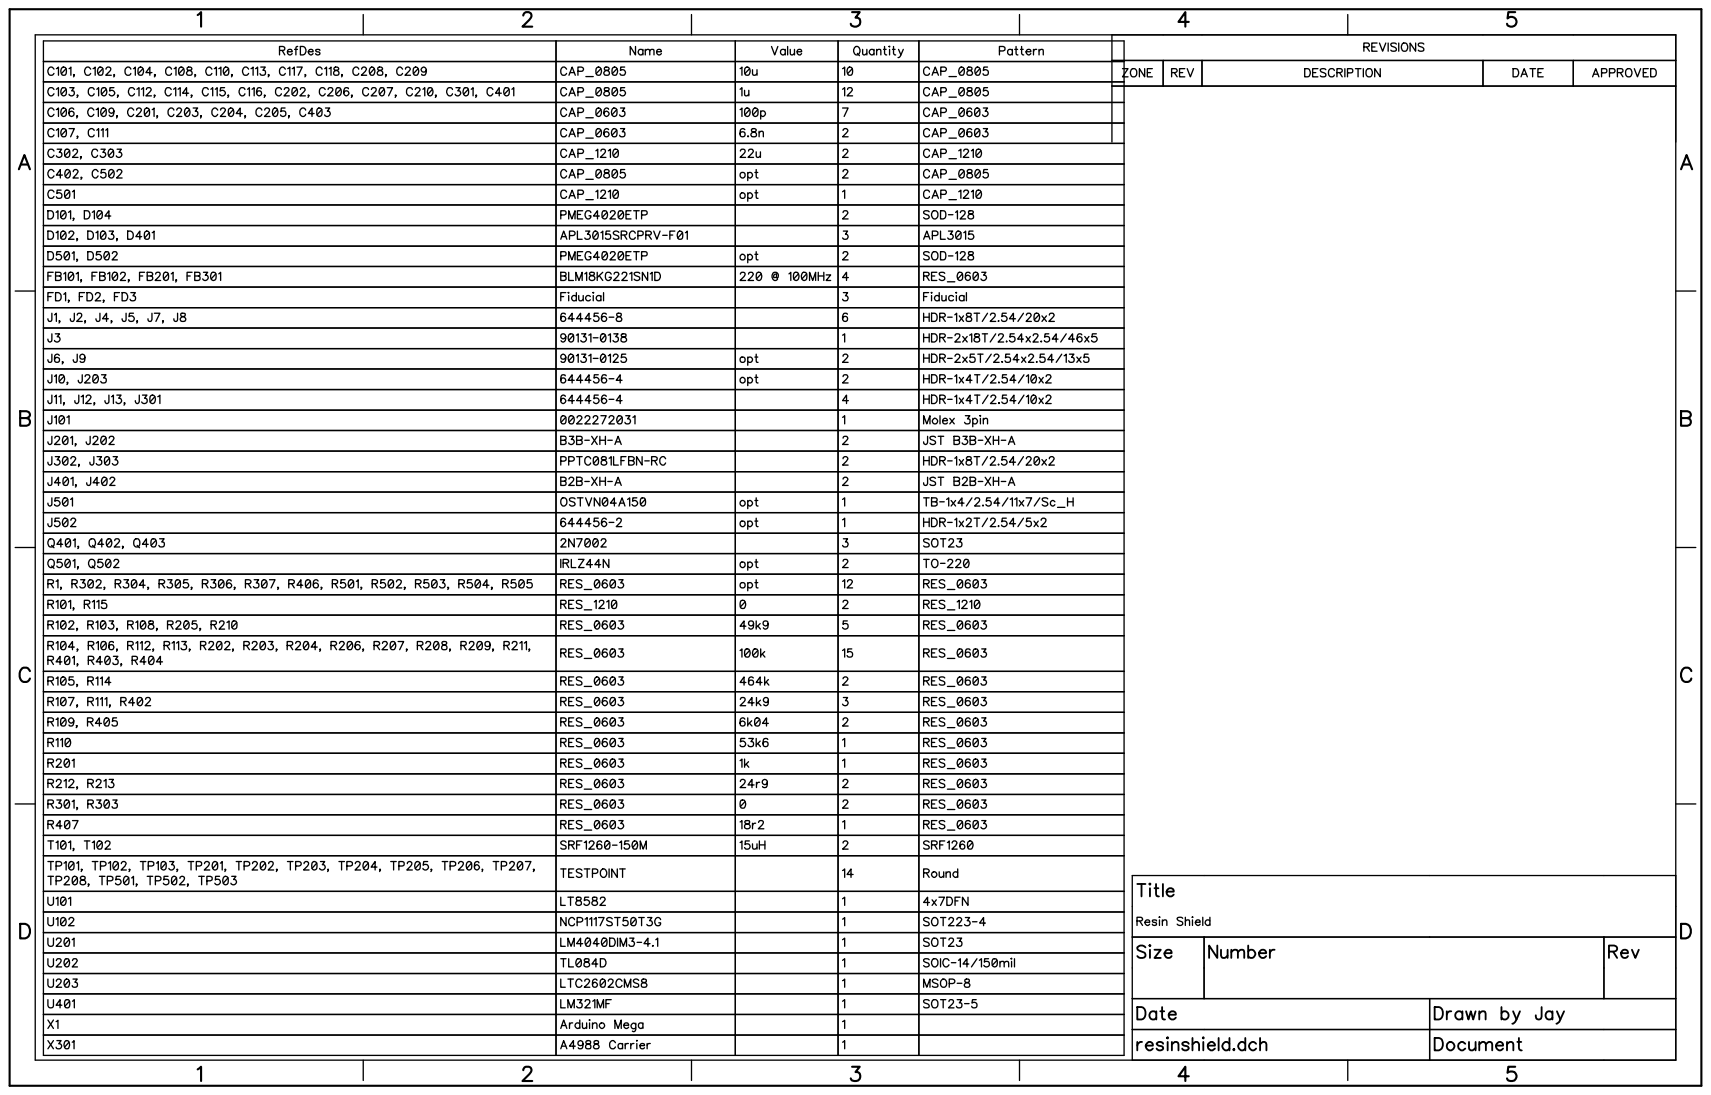
[picture p14: page 7]
