cruiser0002/ResinShield/RS3C/schematic.pdf

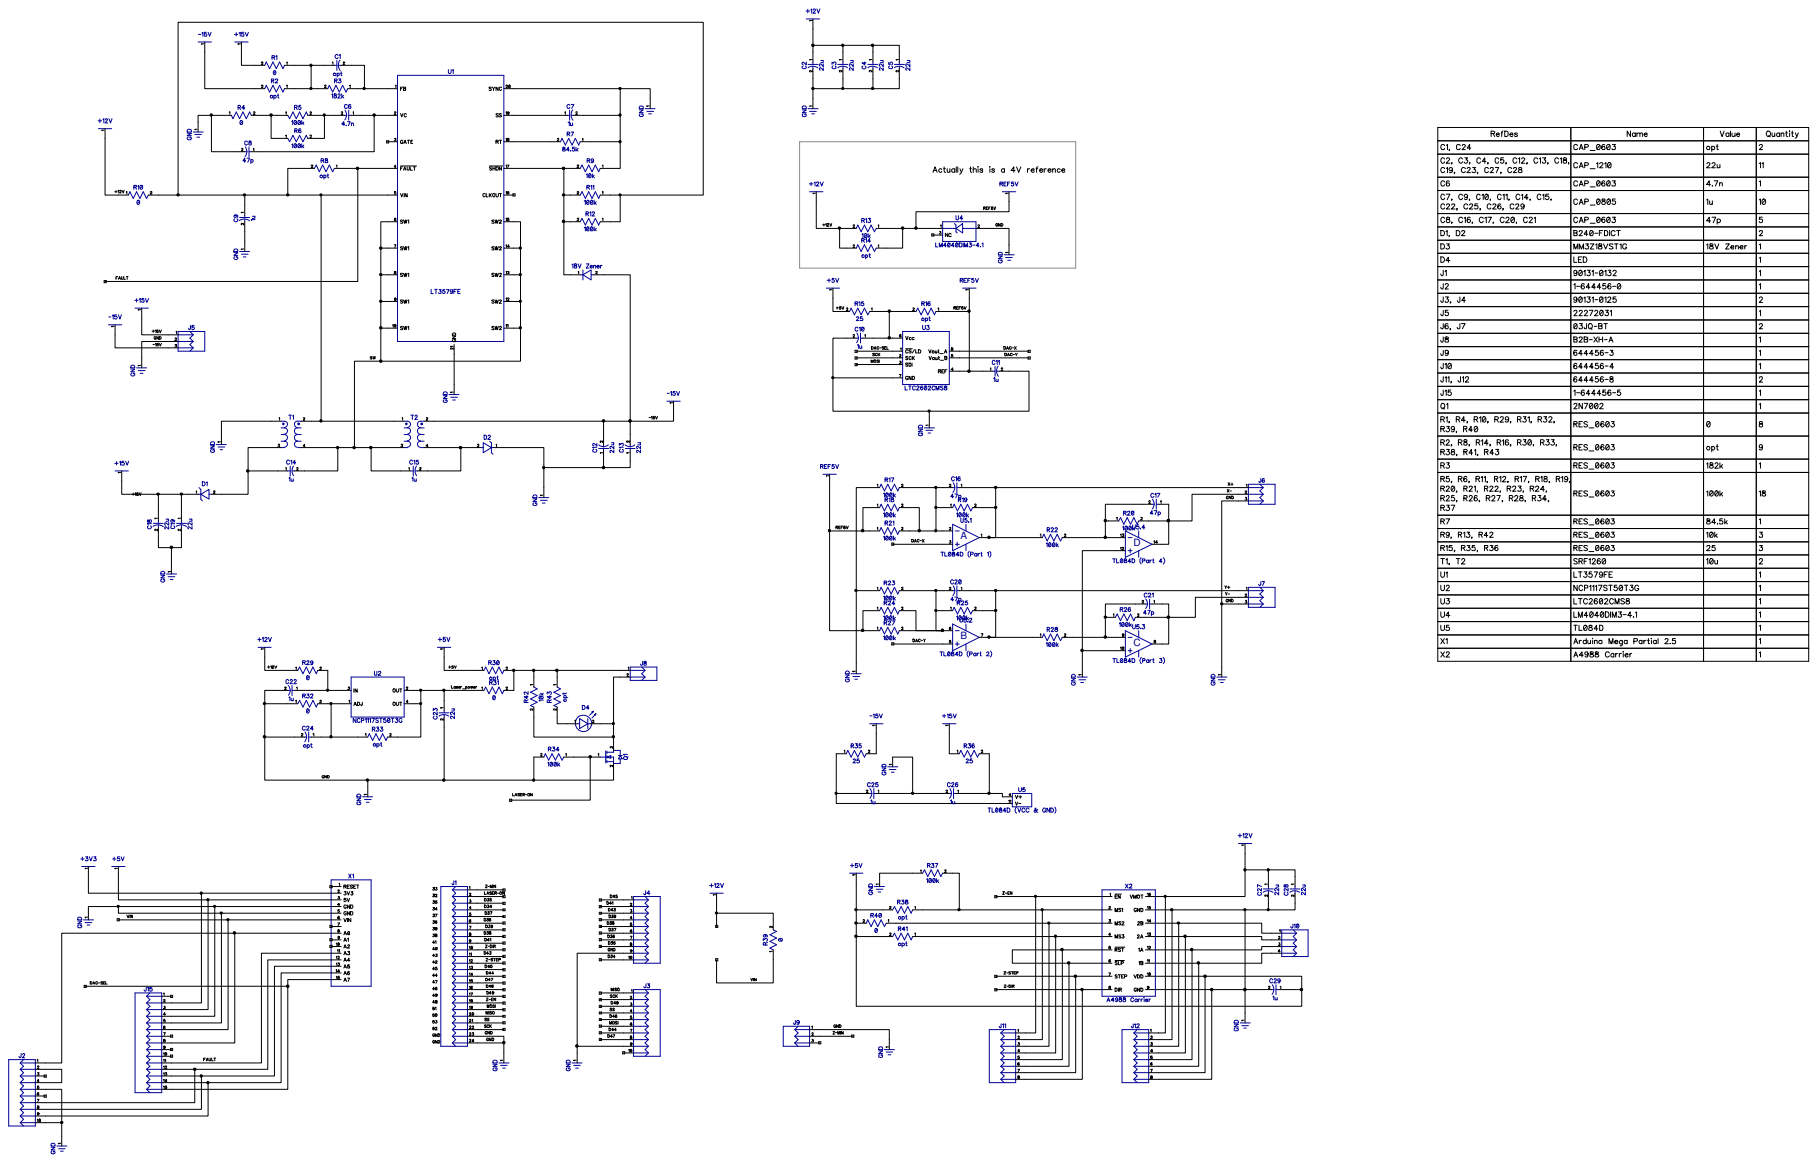
[picture p15: page 1]
