cruiser0002/ResinShield/RevF/DipTrace PCB - resinshield bot.pdf

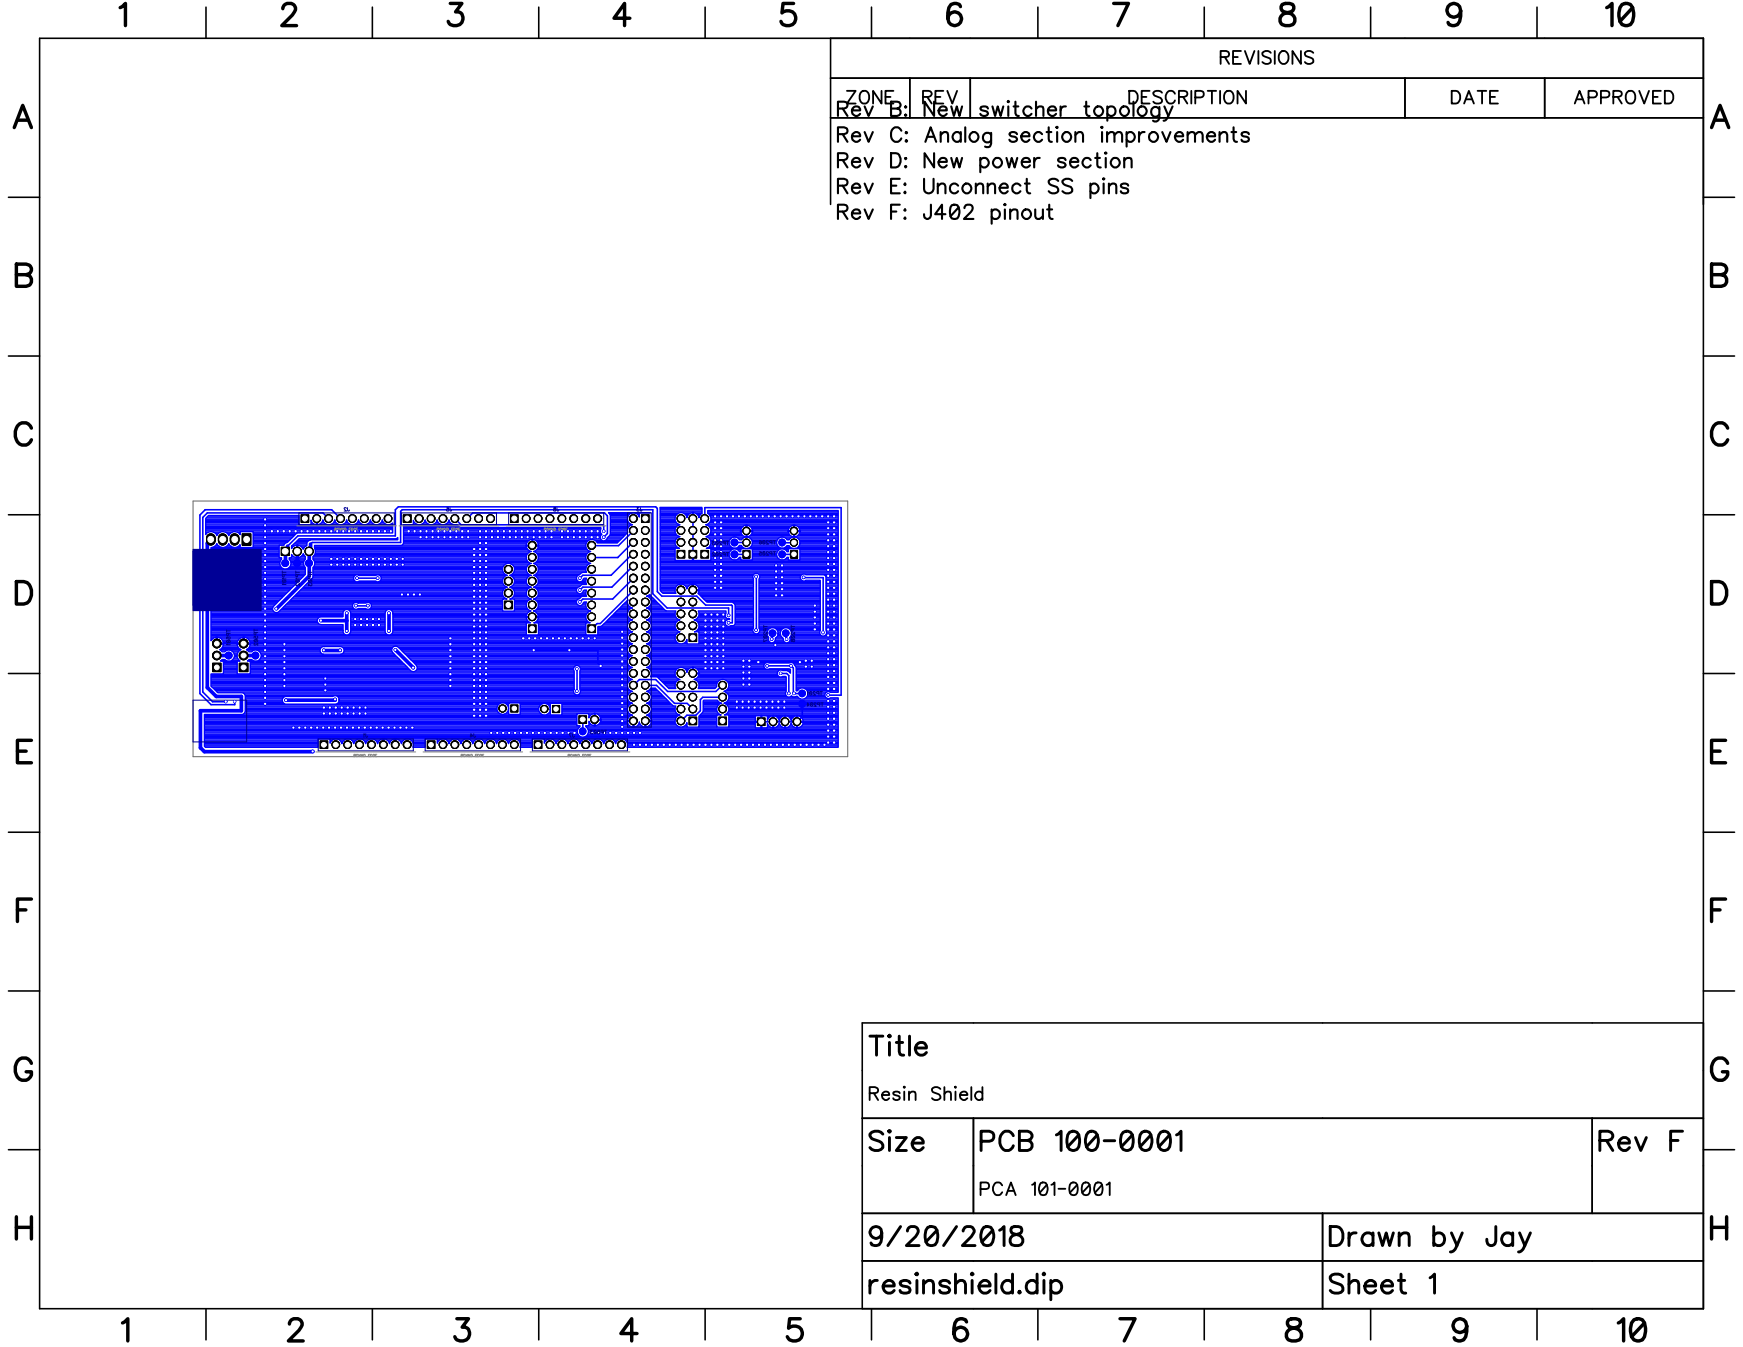
[picture p16: page 1]
