cruiser0002/ResinShield/RevF/DipTrace PCB - resinshield top.pdf

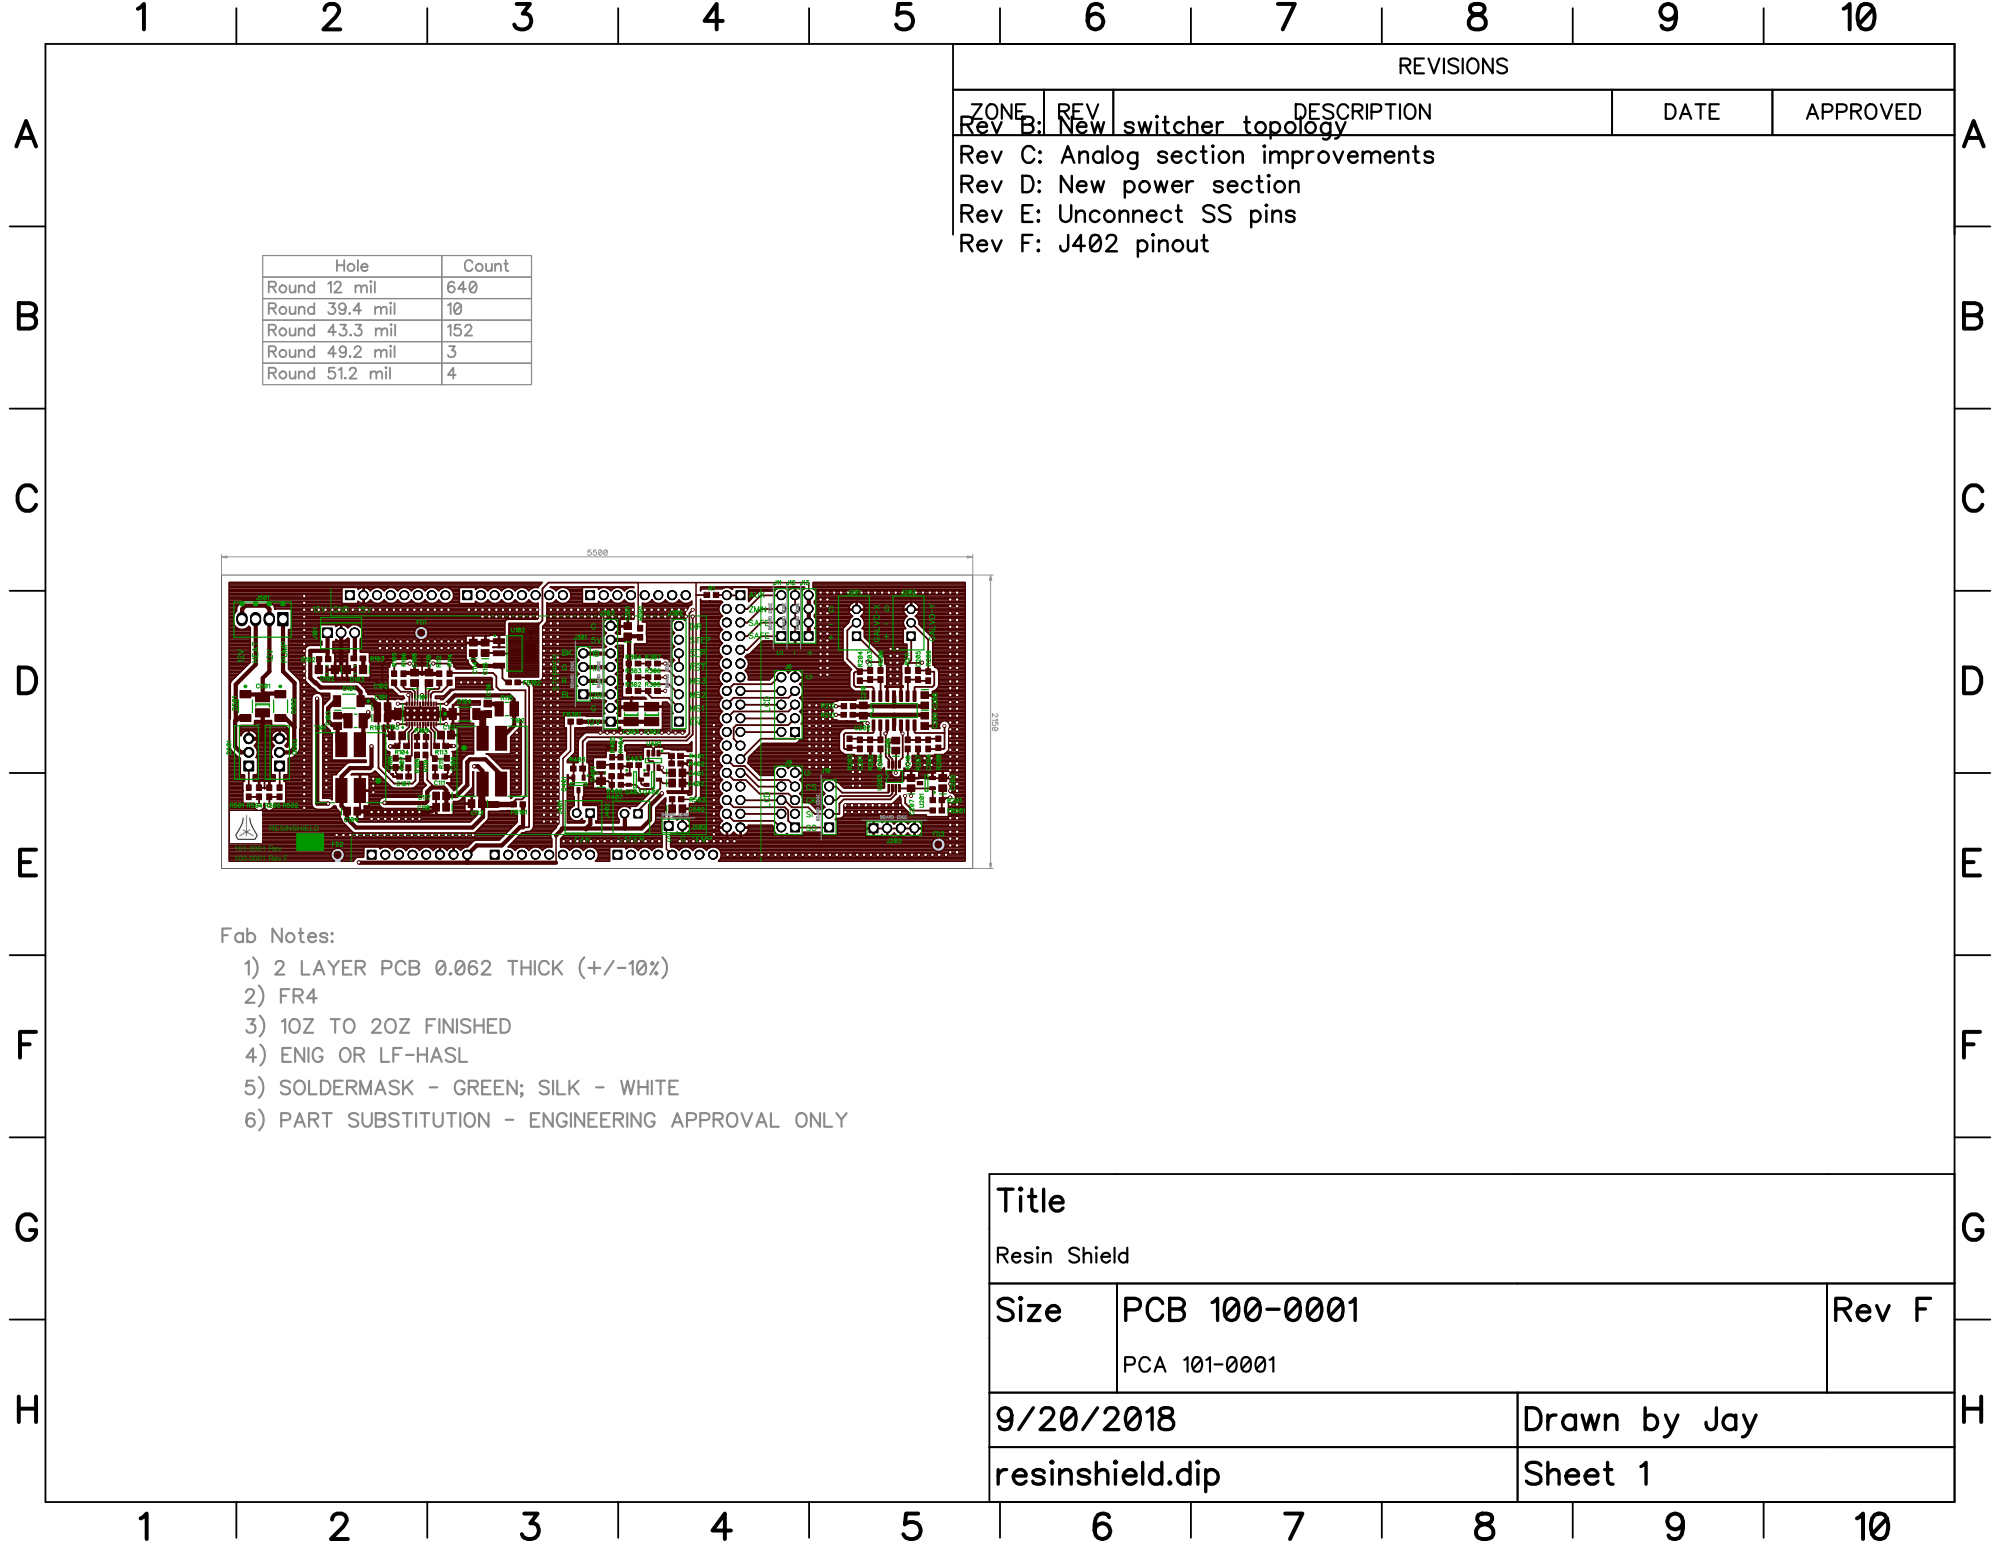
[picture p17: page 1]
100-0001 Rev F; 101-0001 Rev; RESINSHIELD
