cruiser0002/ResinShield/RS3E/RS3E-bot.pdf

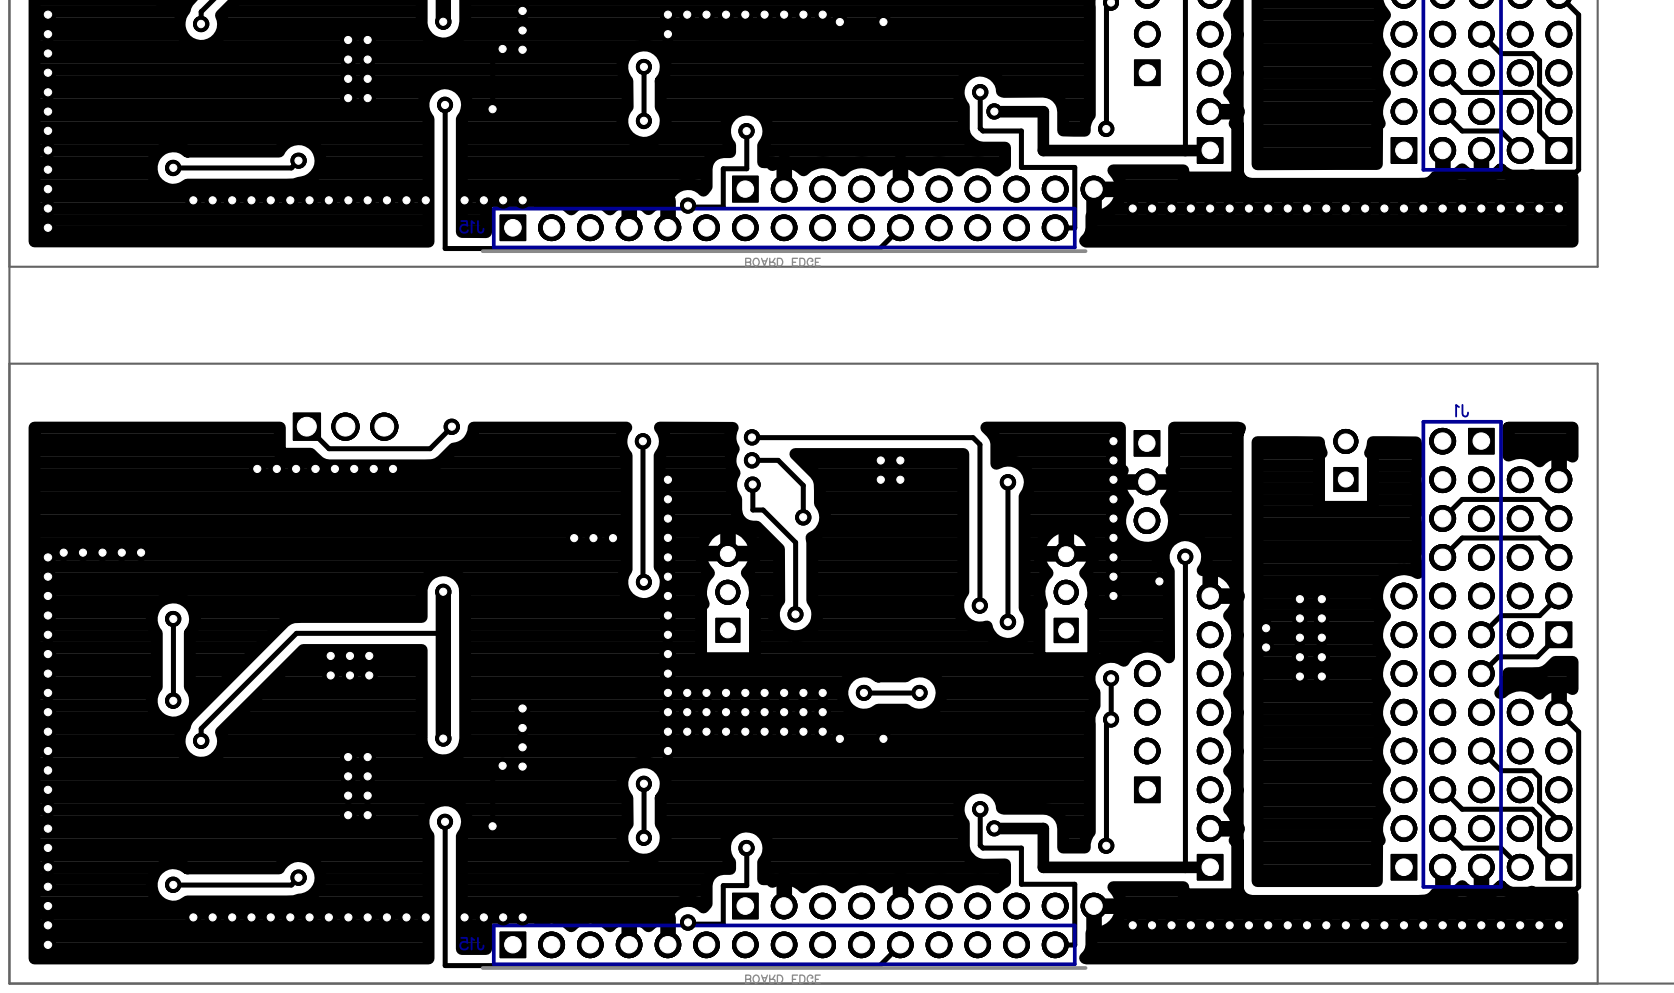
[picture p21: page 1]
