cruiser0002/ResinShield/RS3E/RS3E-sch.pdf

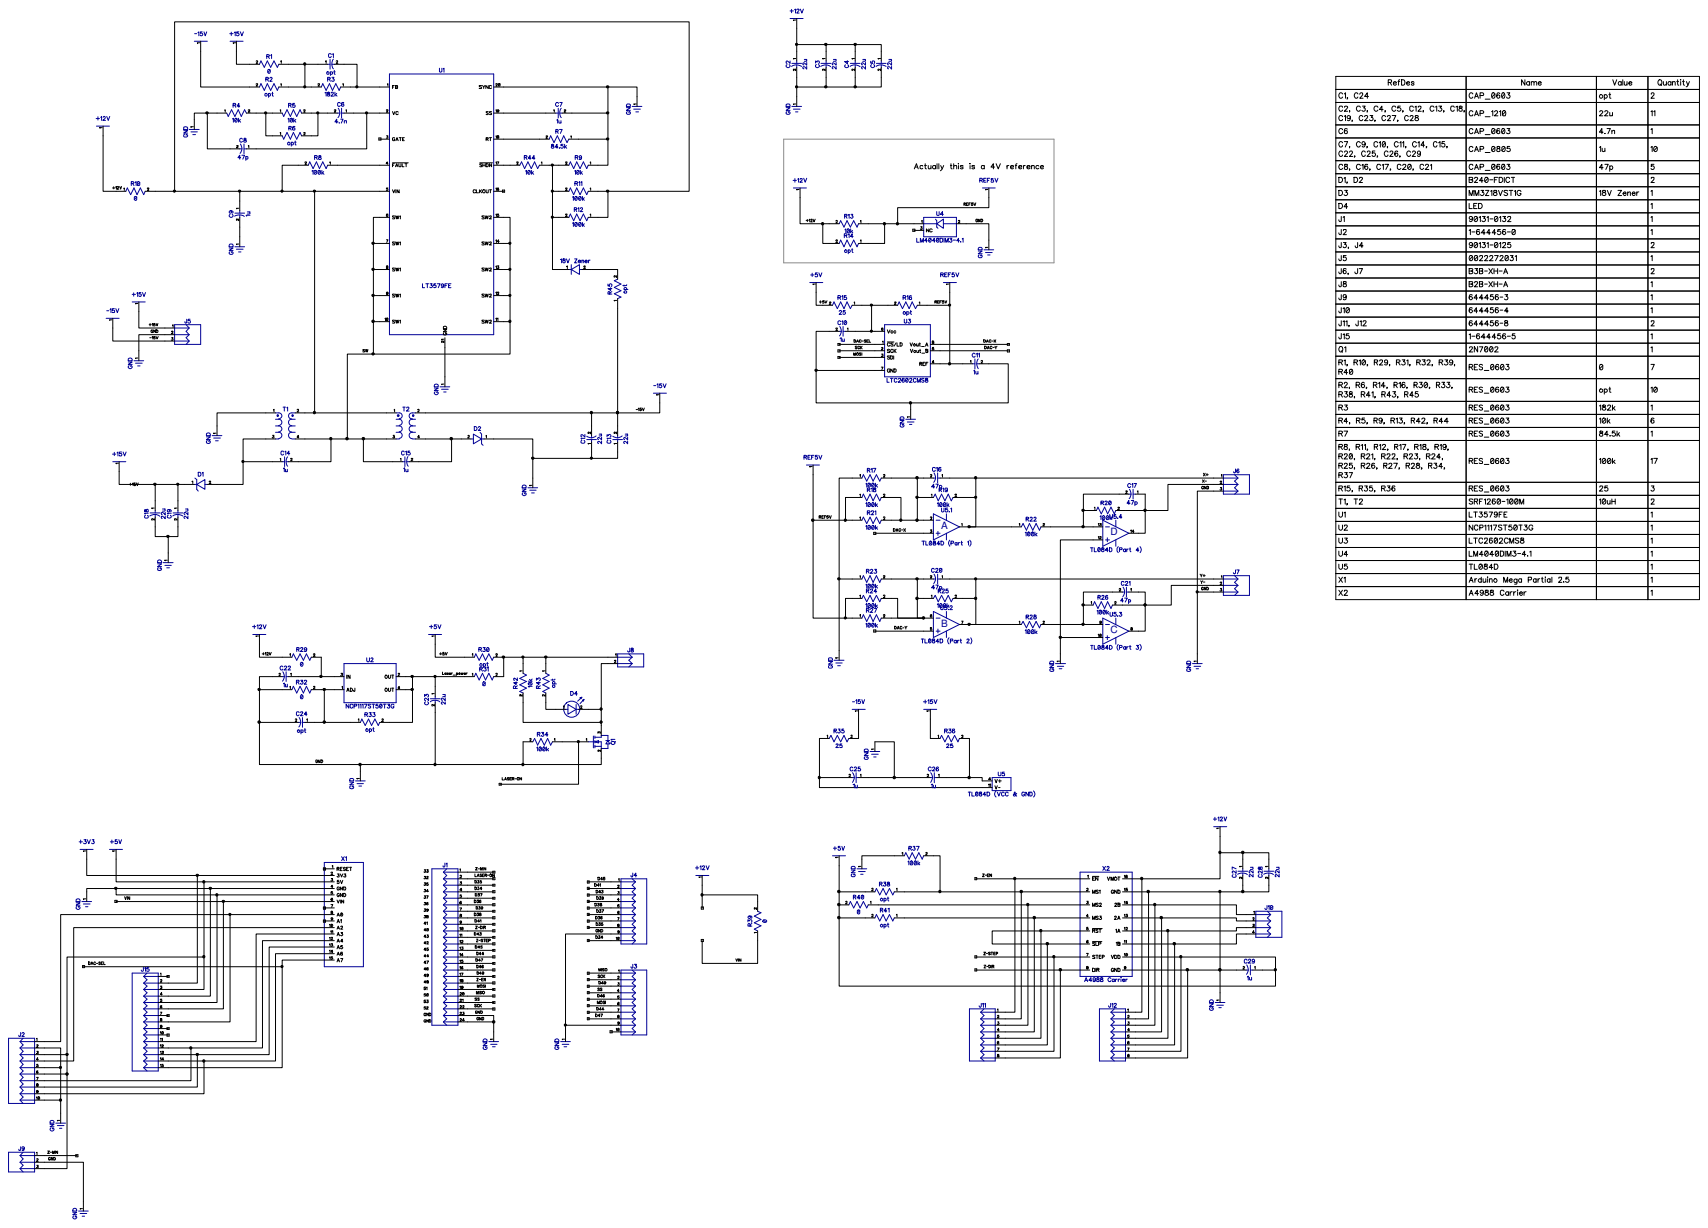
[picture p22: page 1]
