cruiser0002/ResinShield/RS3E/RS3E-top.pdf

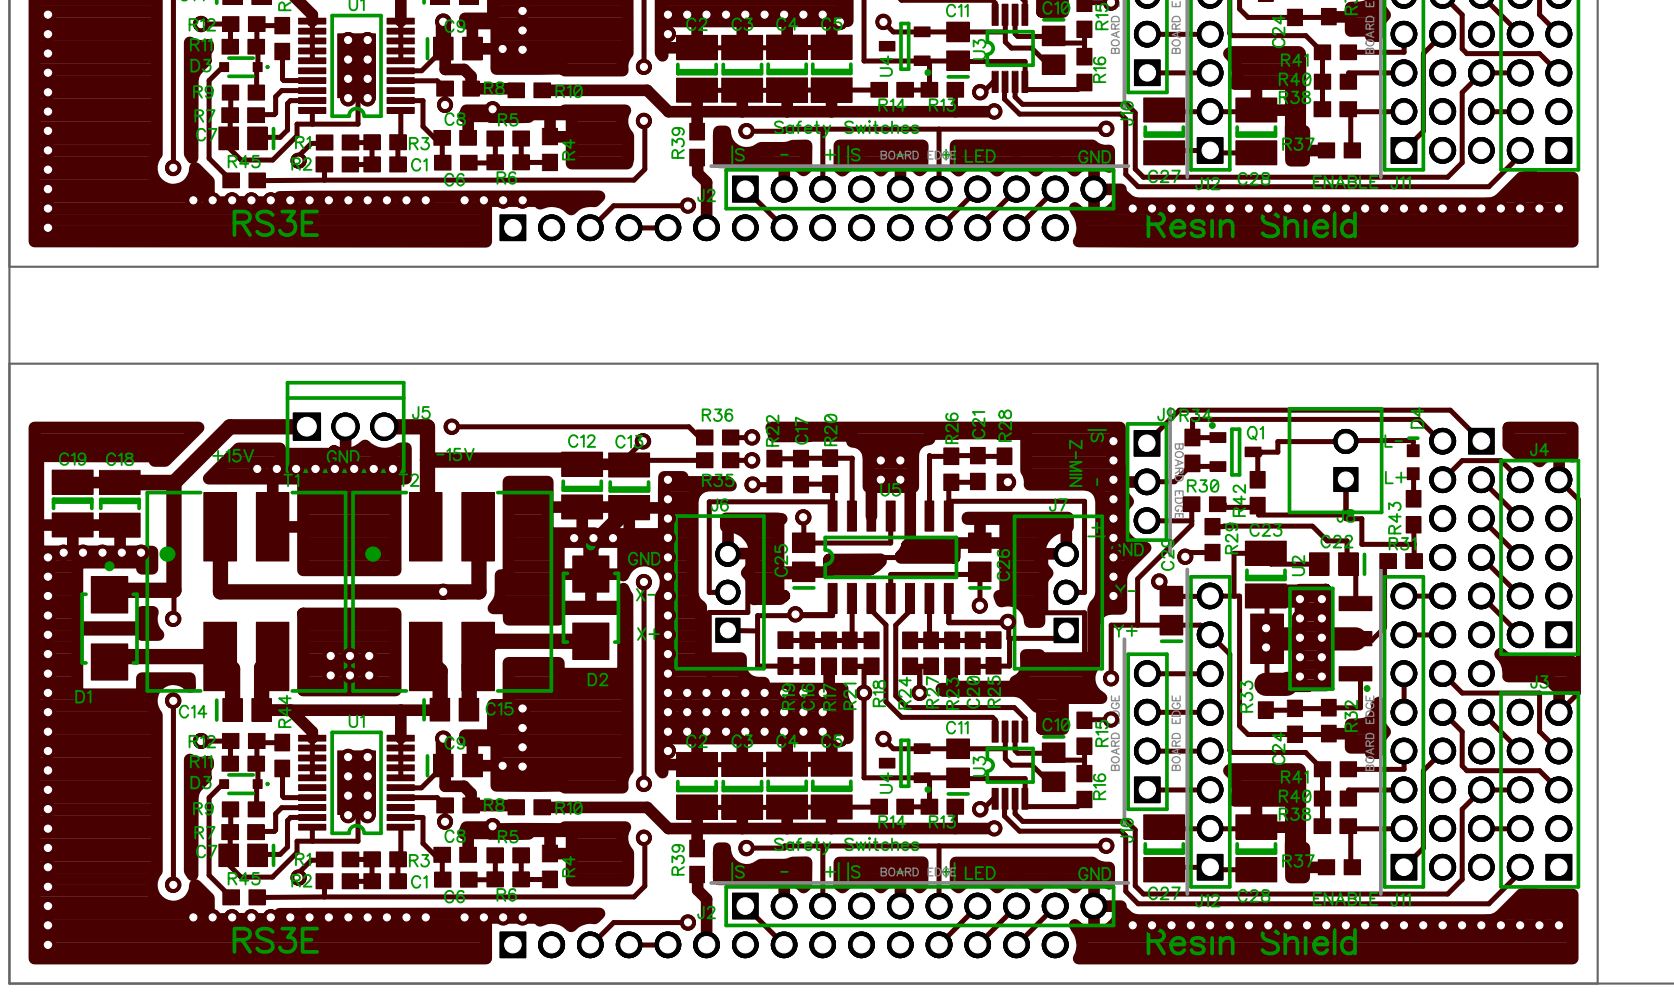
[picture p23: page 1]
