cruiser0002/ResinShield/RS3D/RS3D_bot.pdf

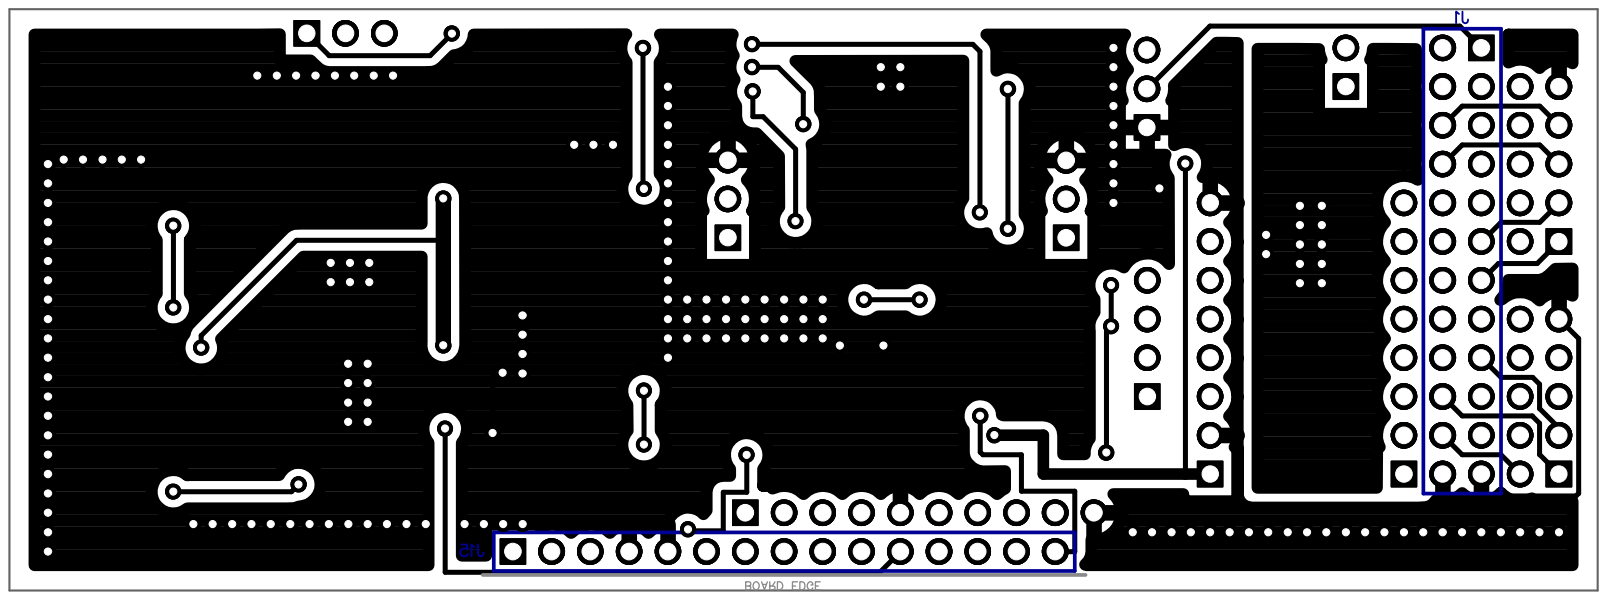
[picture p24: page 1]
