cruiser0002/ResinShield/RS3D/RS3D_sch.pdf

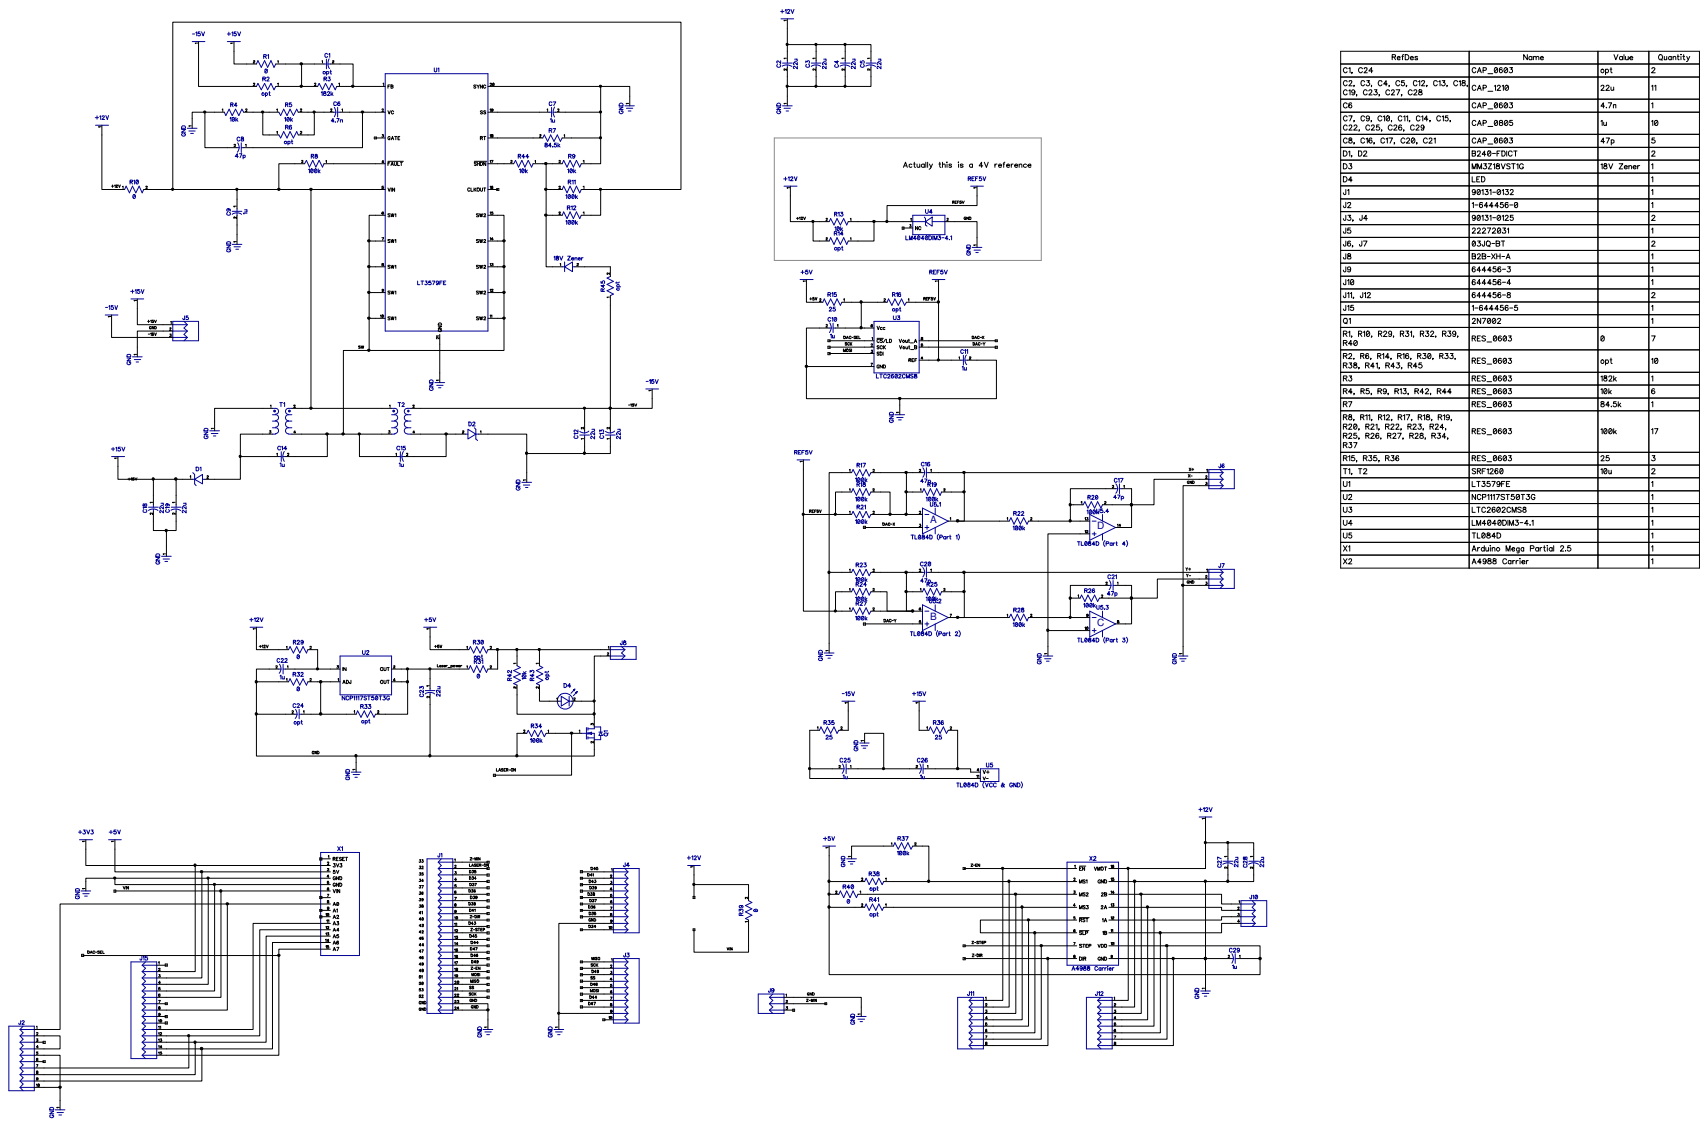
[picture p25: page 1]
