cruiser0002/ResinShield/RS3D/RS3D_top.pdf

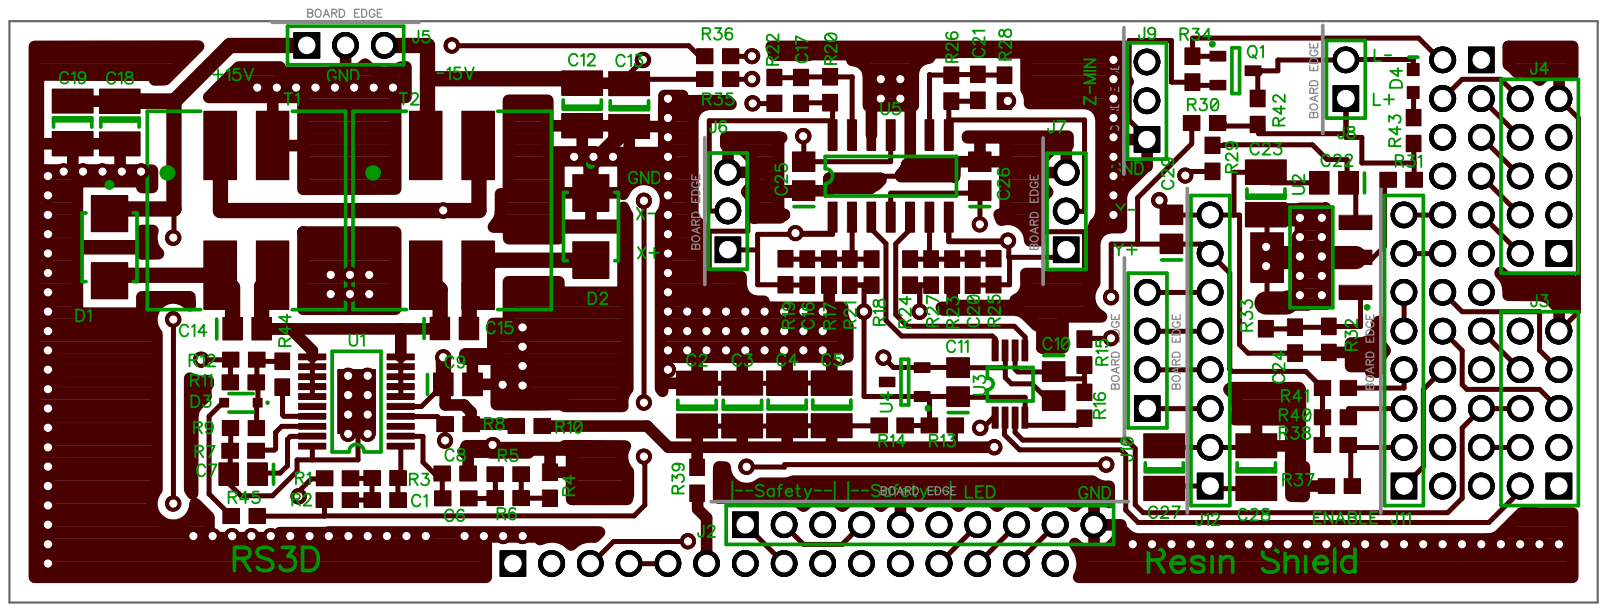
[picture p26: page 1]
