cruiser0002/ResinShield/RS3C/bot.pdf

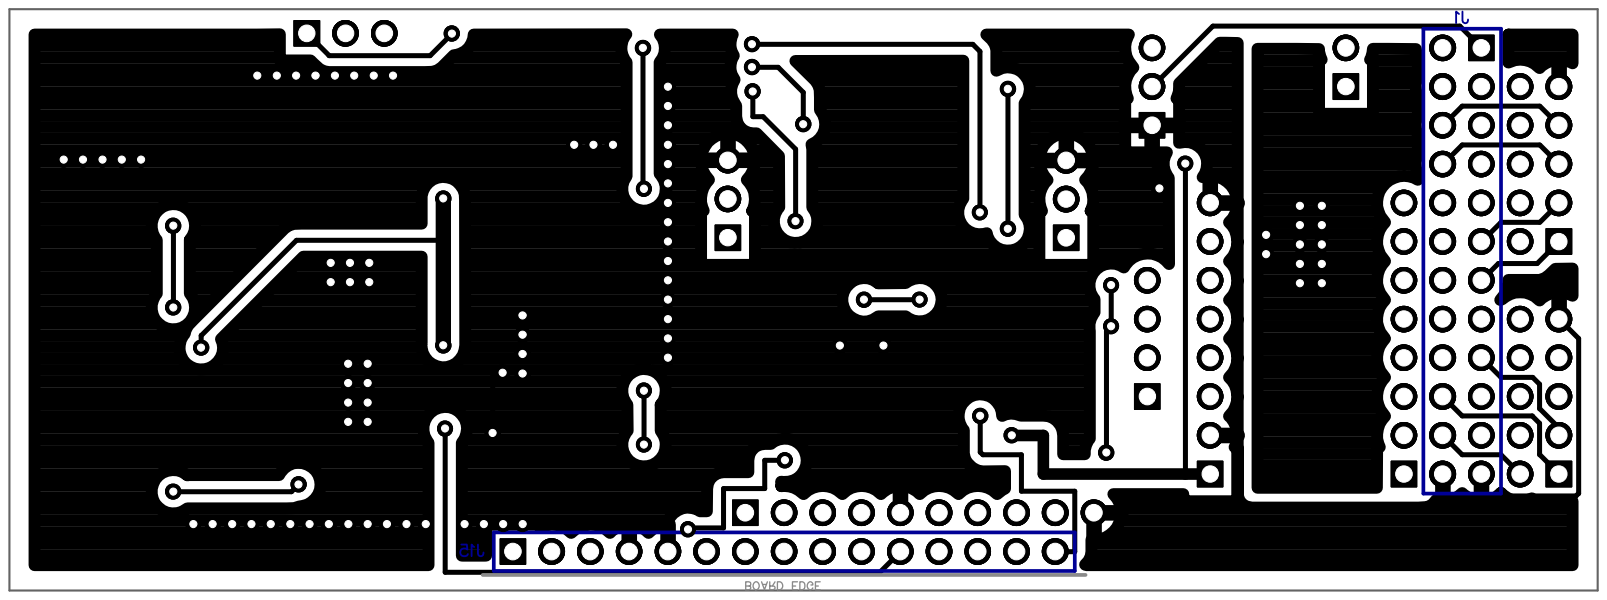
[picture p27: page 1]
