cruiser0002/ResinShield/RS3C/top.pdf

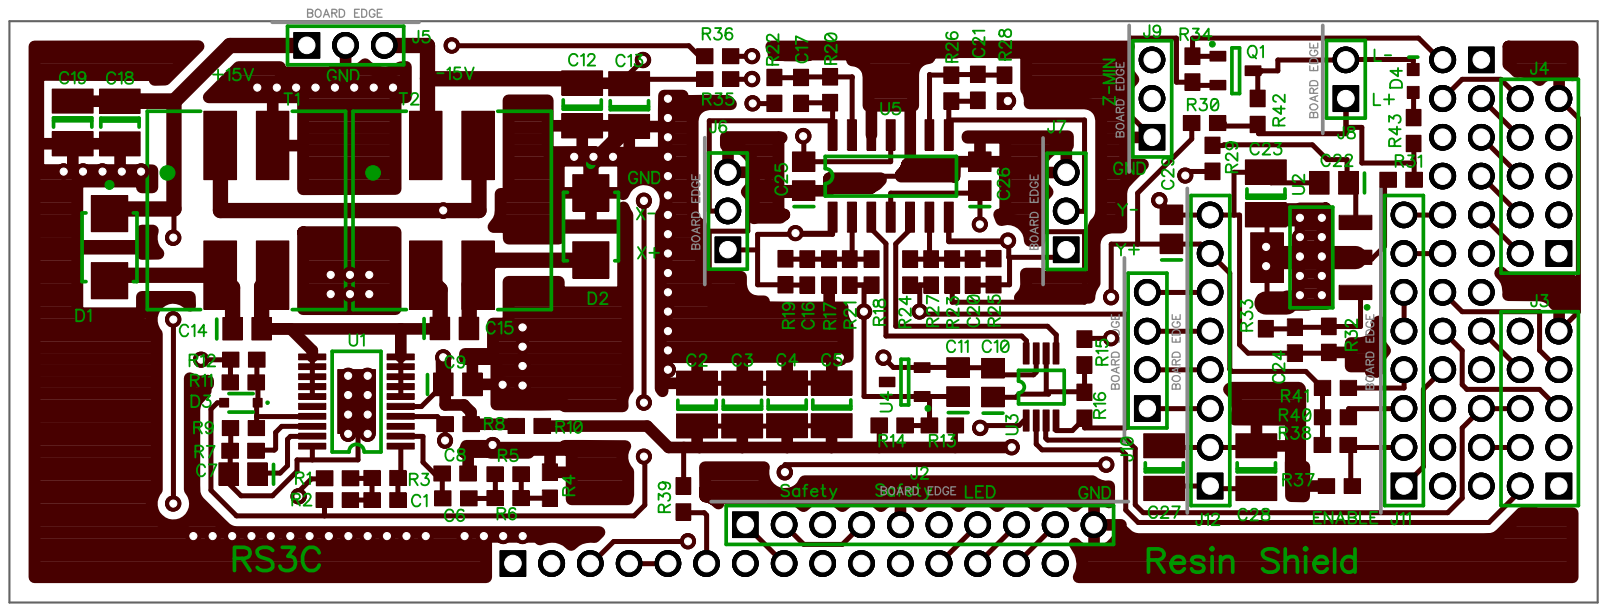
[picture p28: page 1]
