cruiser0002/ResinShield/RS3B/RS3B_sch.pdf

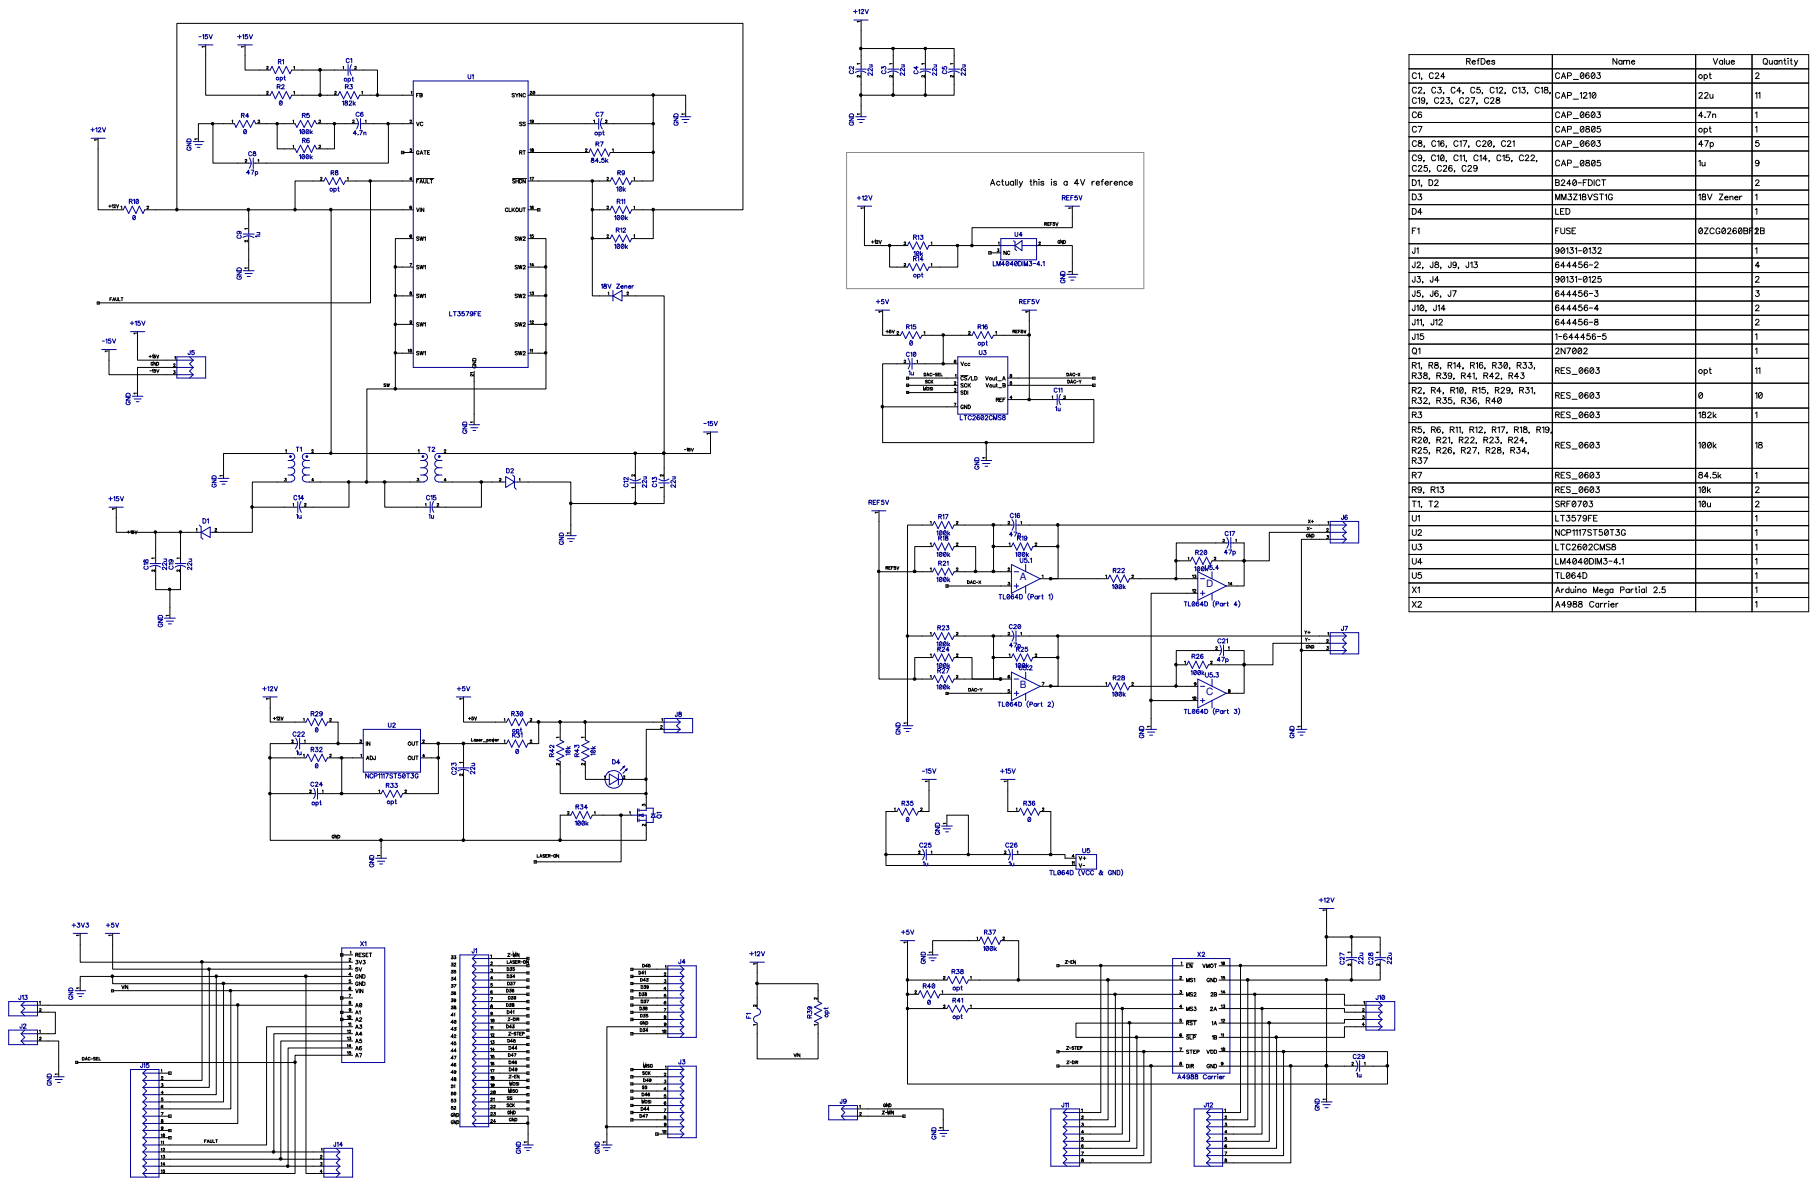
[picture p29: page 1]
