cruiser0002/ResinShield/RS2A/RS2A_bot.pdf

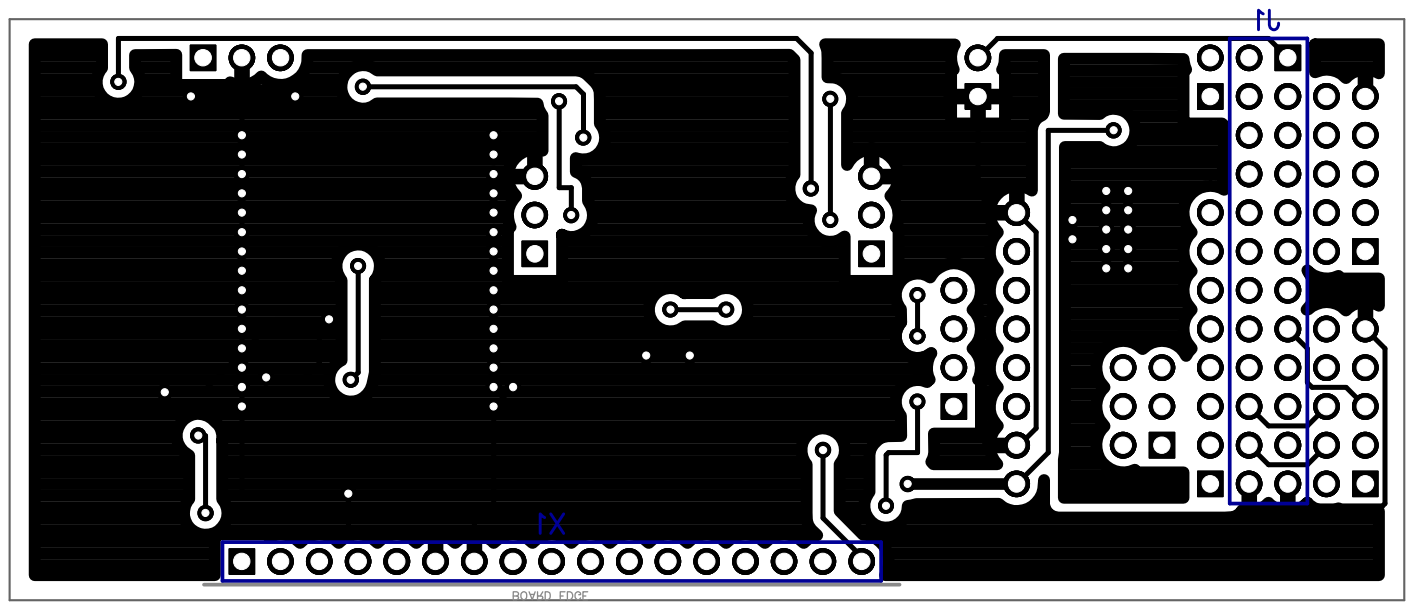
[picture p30: page 1]
