cruiser0002/ResinShield/RS2A/RS2A_sch.pdf

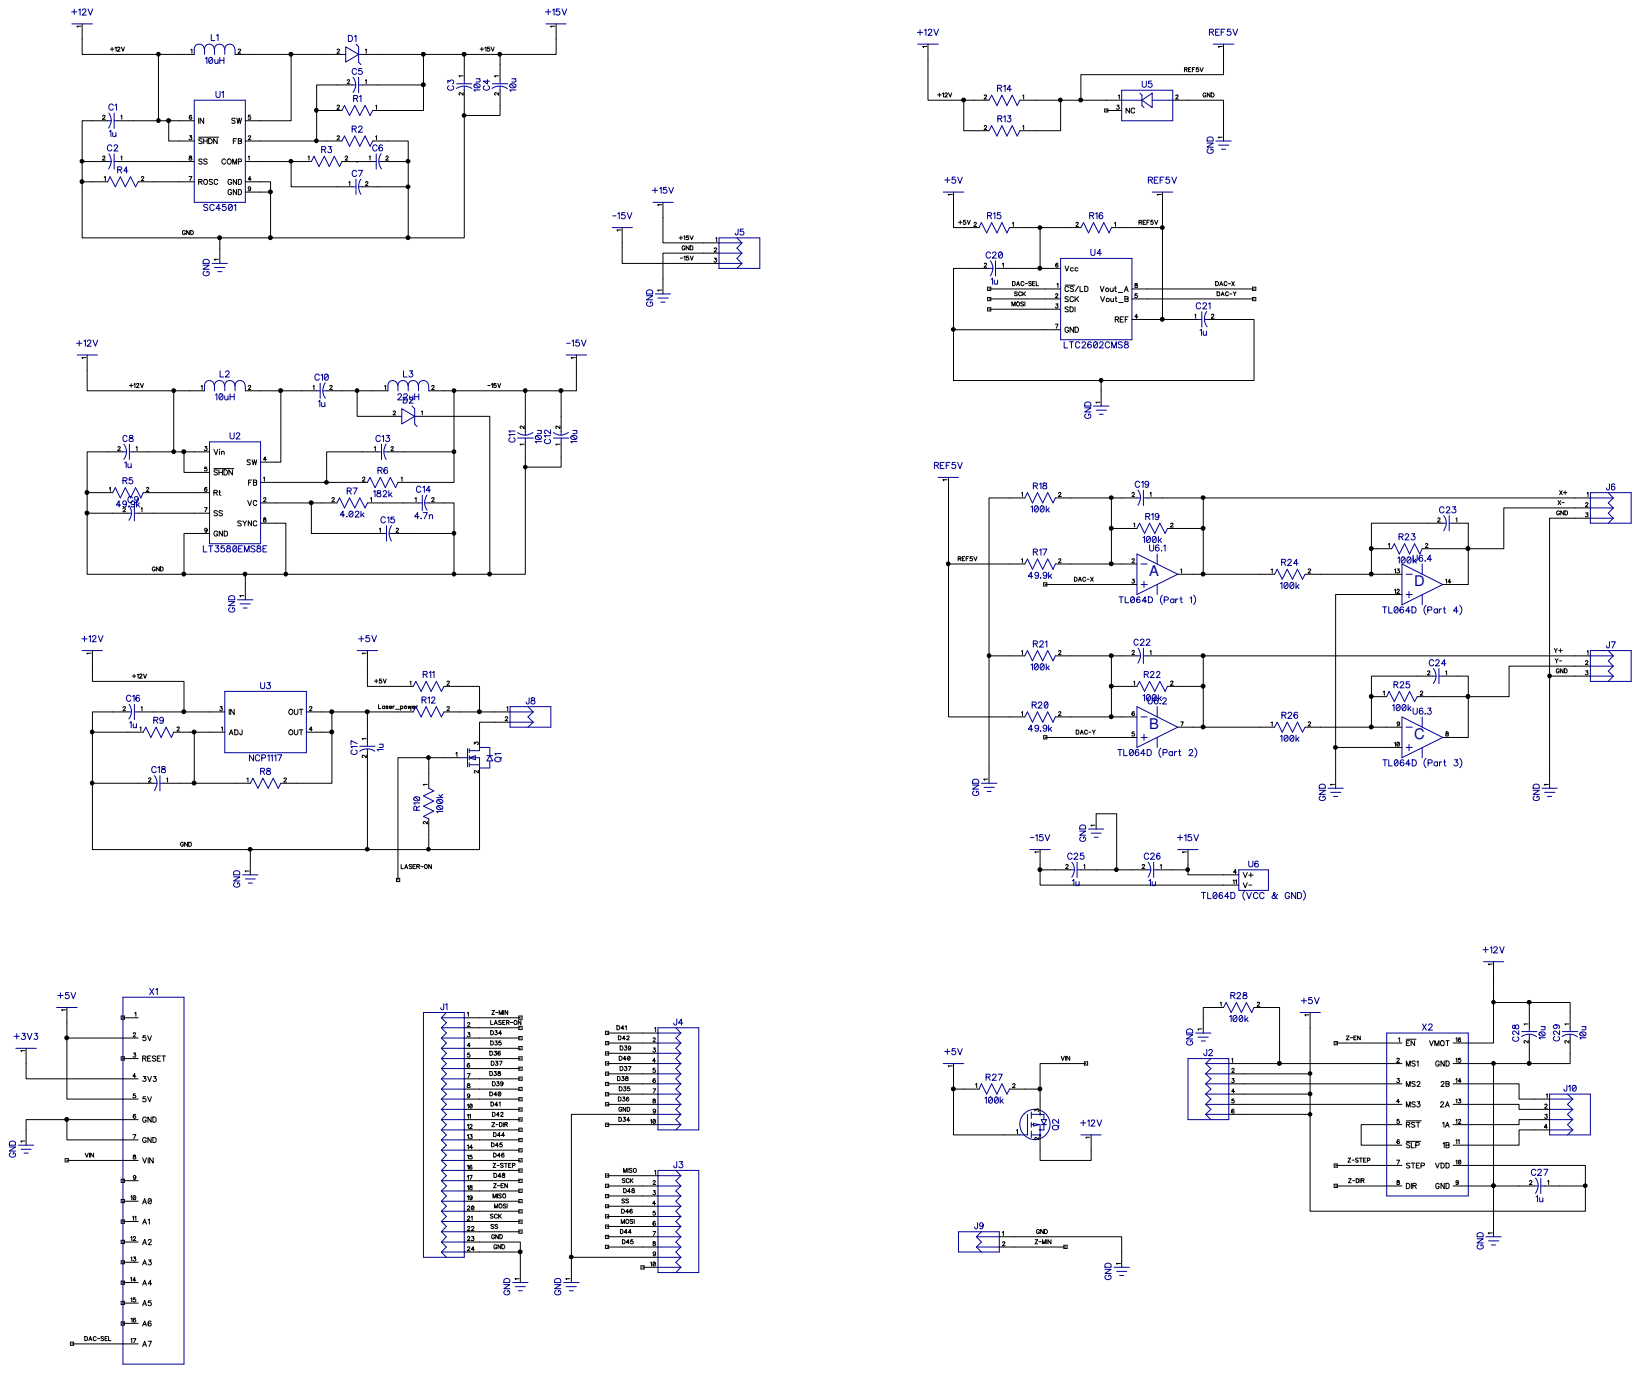
[picture p31: page 1]
