cruiser0002/ResinShield/RS2A/RS2A_top.pdf

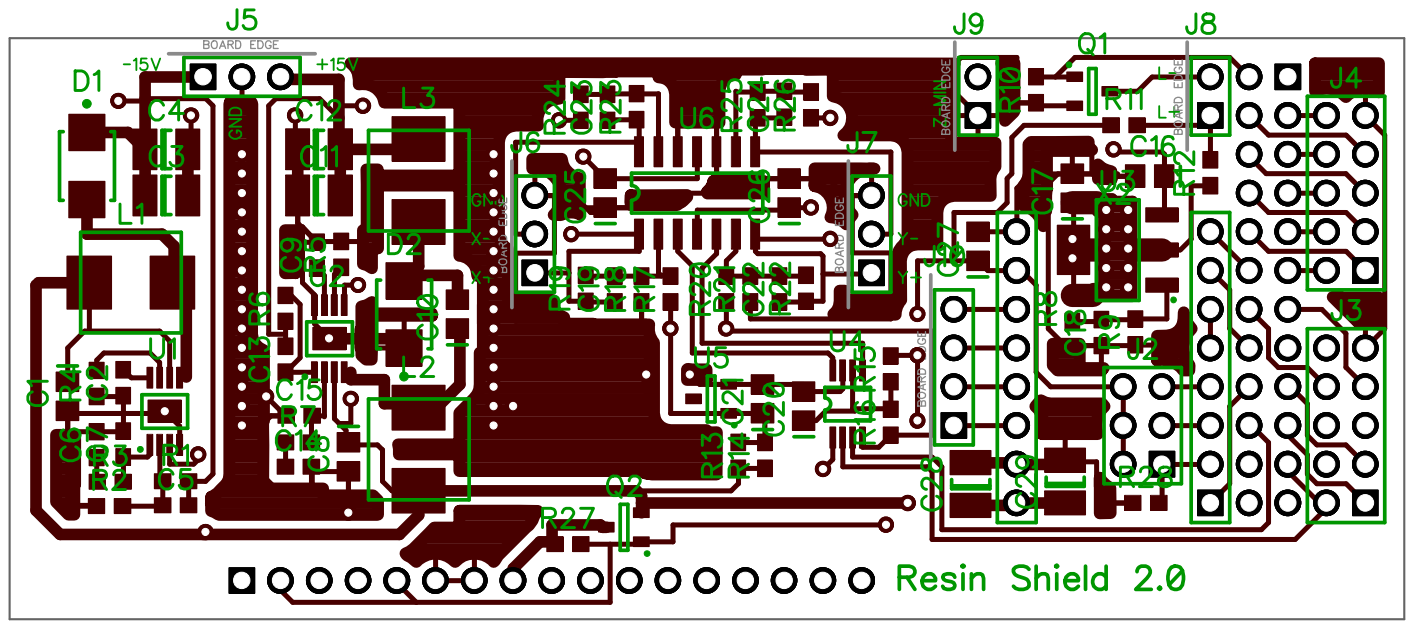
[picture p32: page 1]
