cruiser0002/ResinShield/RS2C/RS2C_bot.pdf

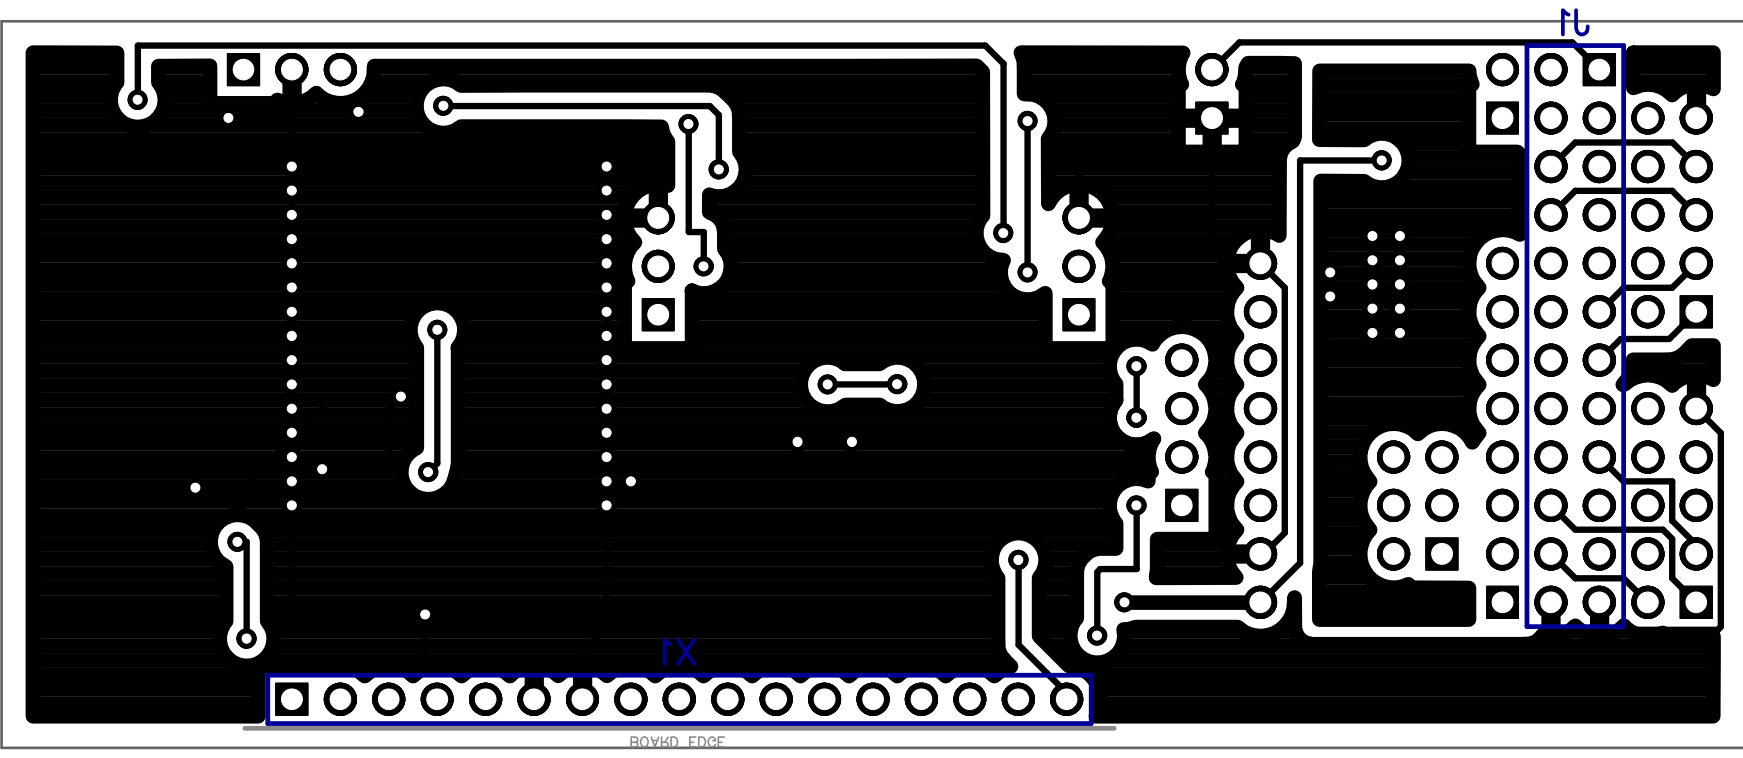
[picture p33: page 1]
