cruiser0002/ResinShield/RS2C/RS2C_sch.pdf

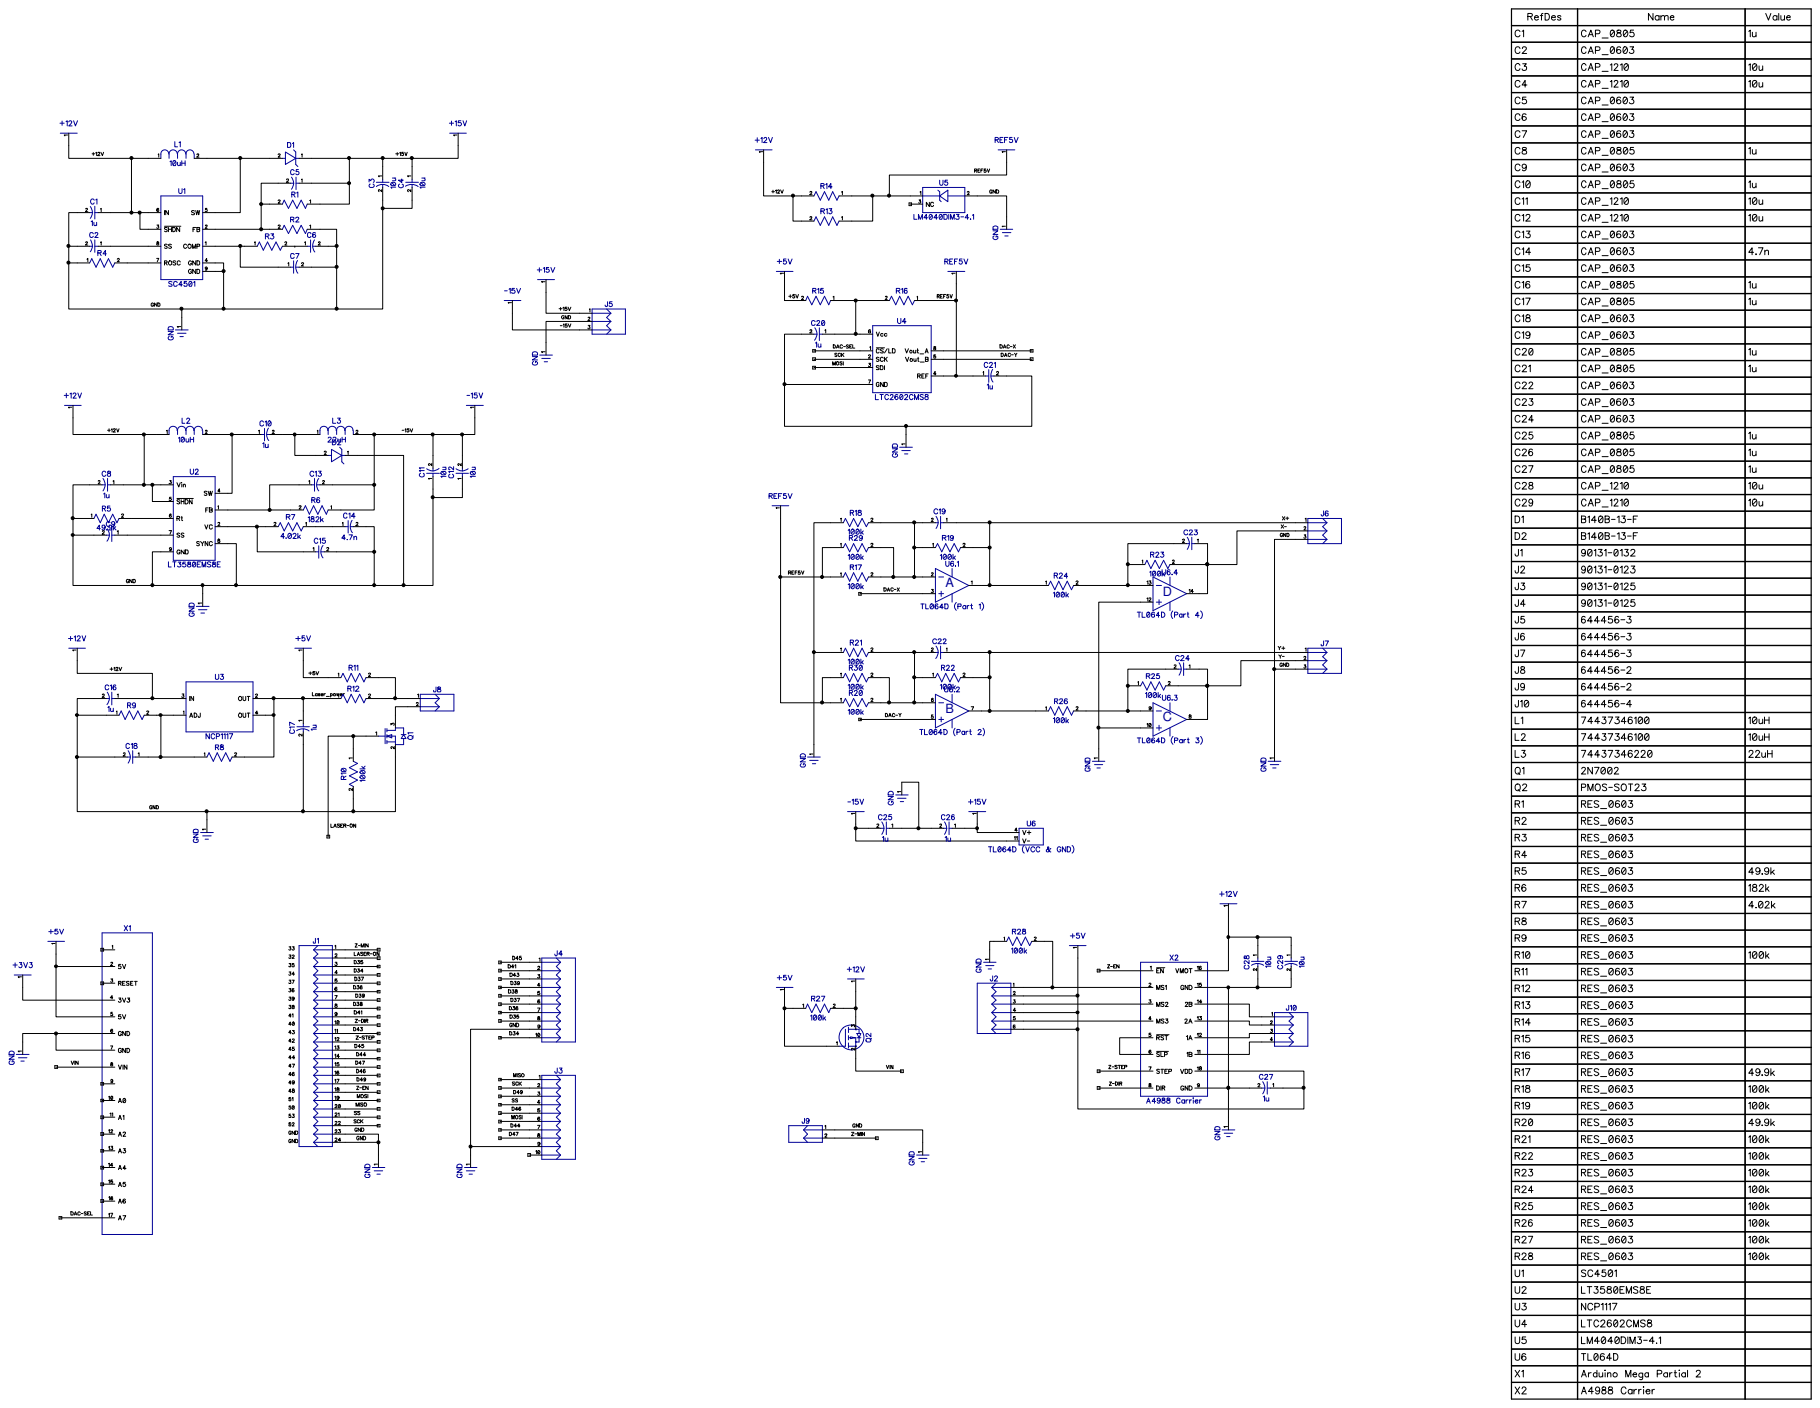
[picture p34: page 1]
