cruiser0002/ResinShield/RS2C/RS2C_top.pdf

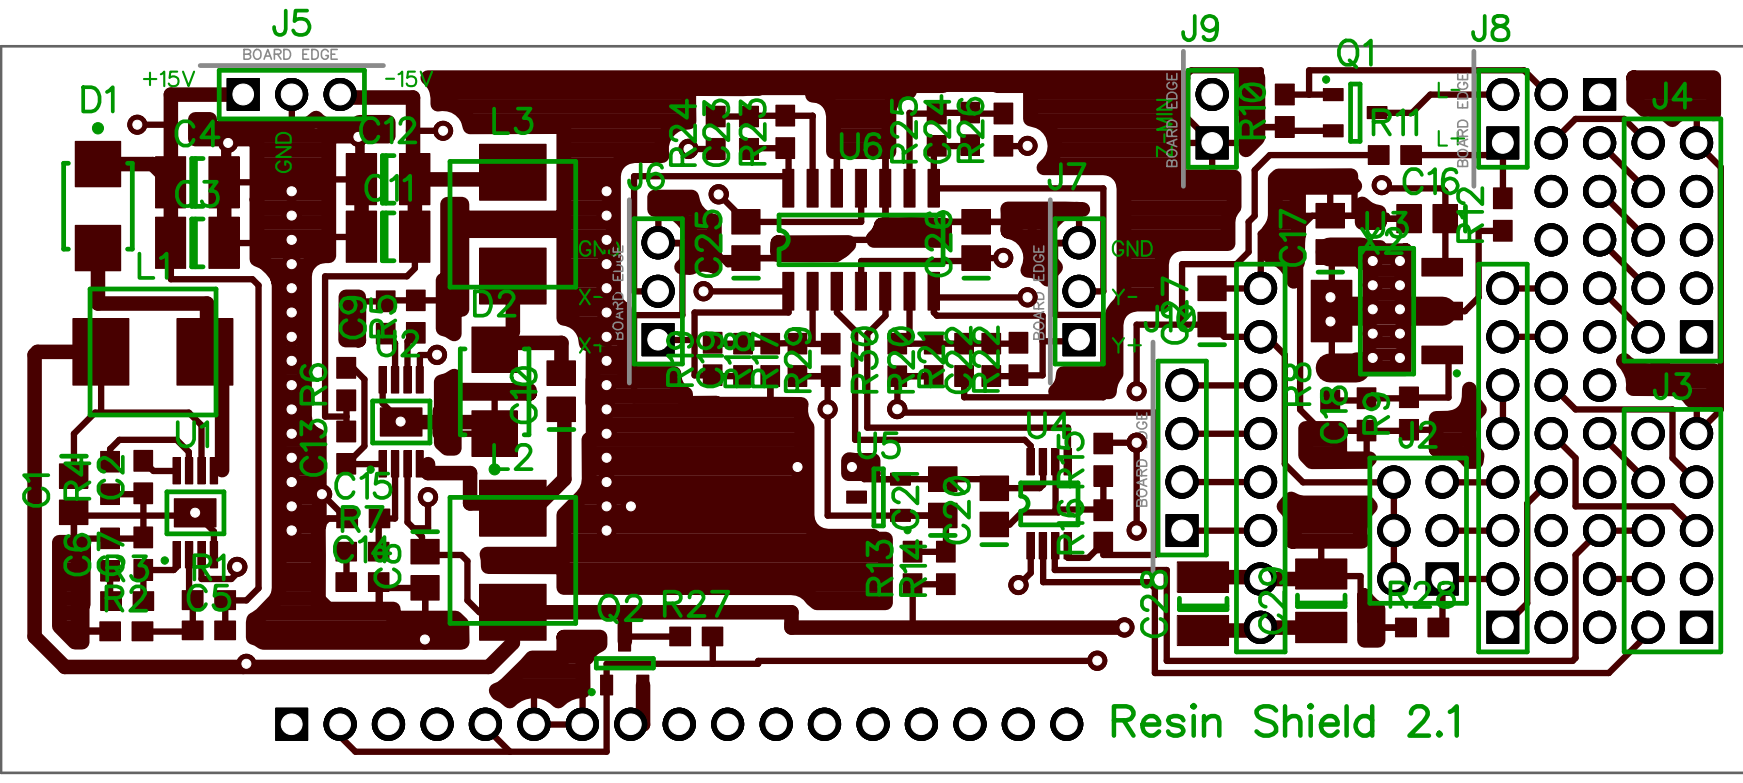
[picture p35: page 1]
