cruiser0002/ResinShield/RS2D/RS2D_bot.pdf

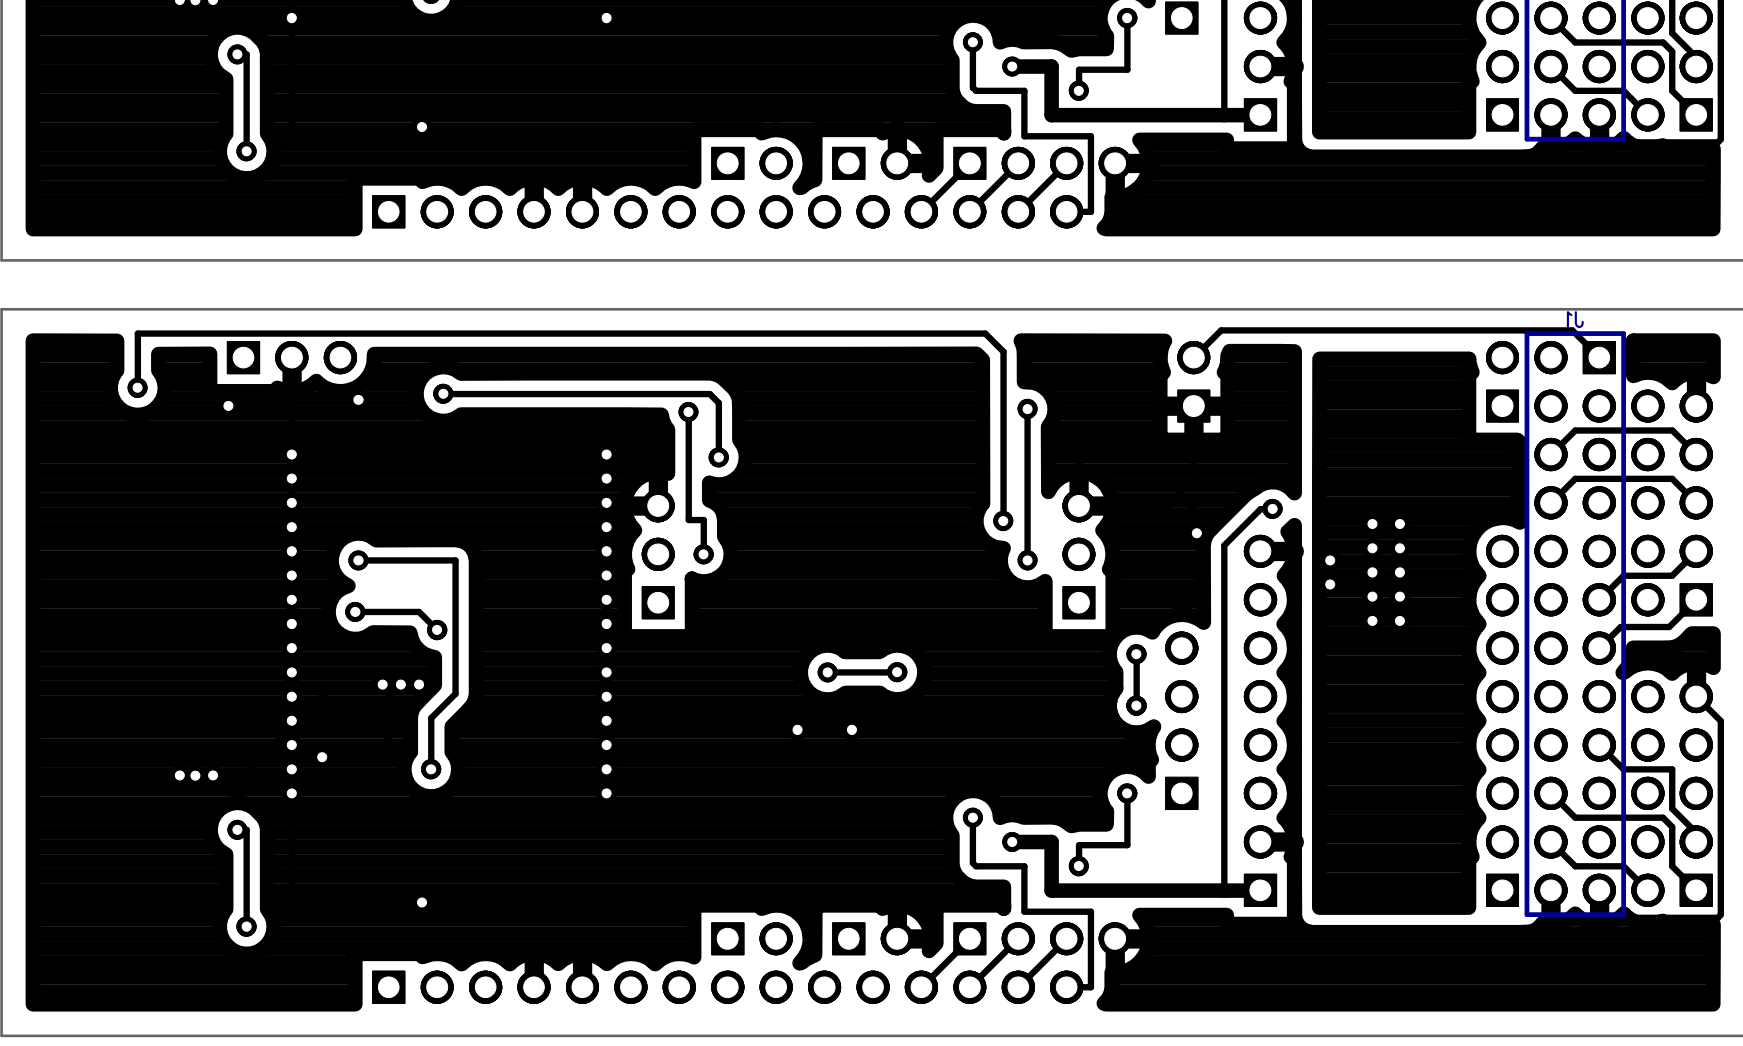
[picture p36: page 1]
