cruiser0002/ResinShield/RS2D/RS2D_sch.pdf

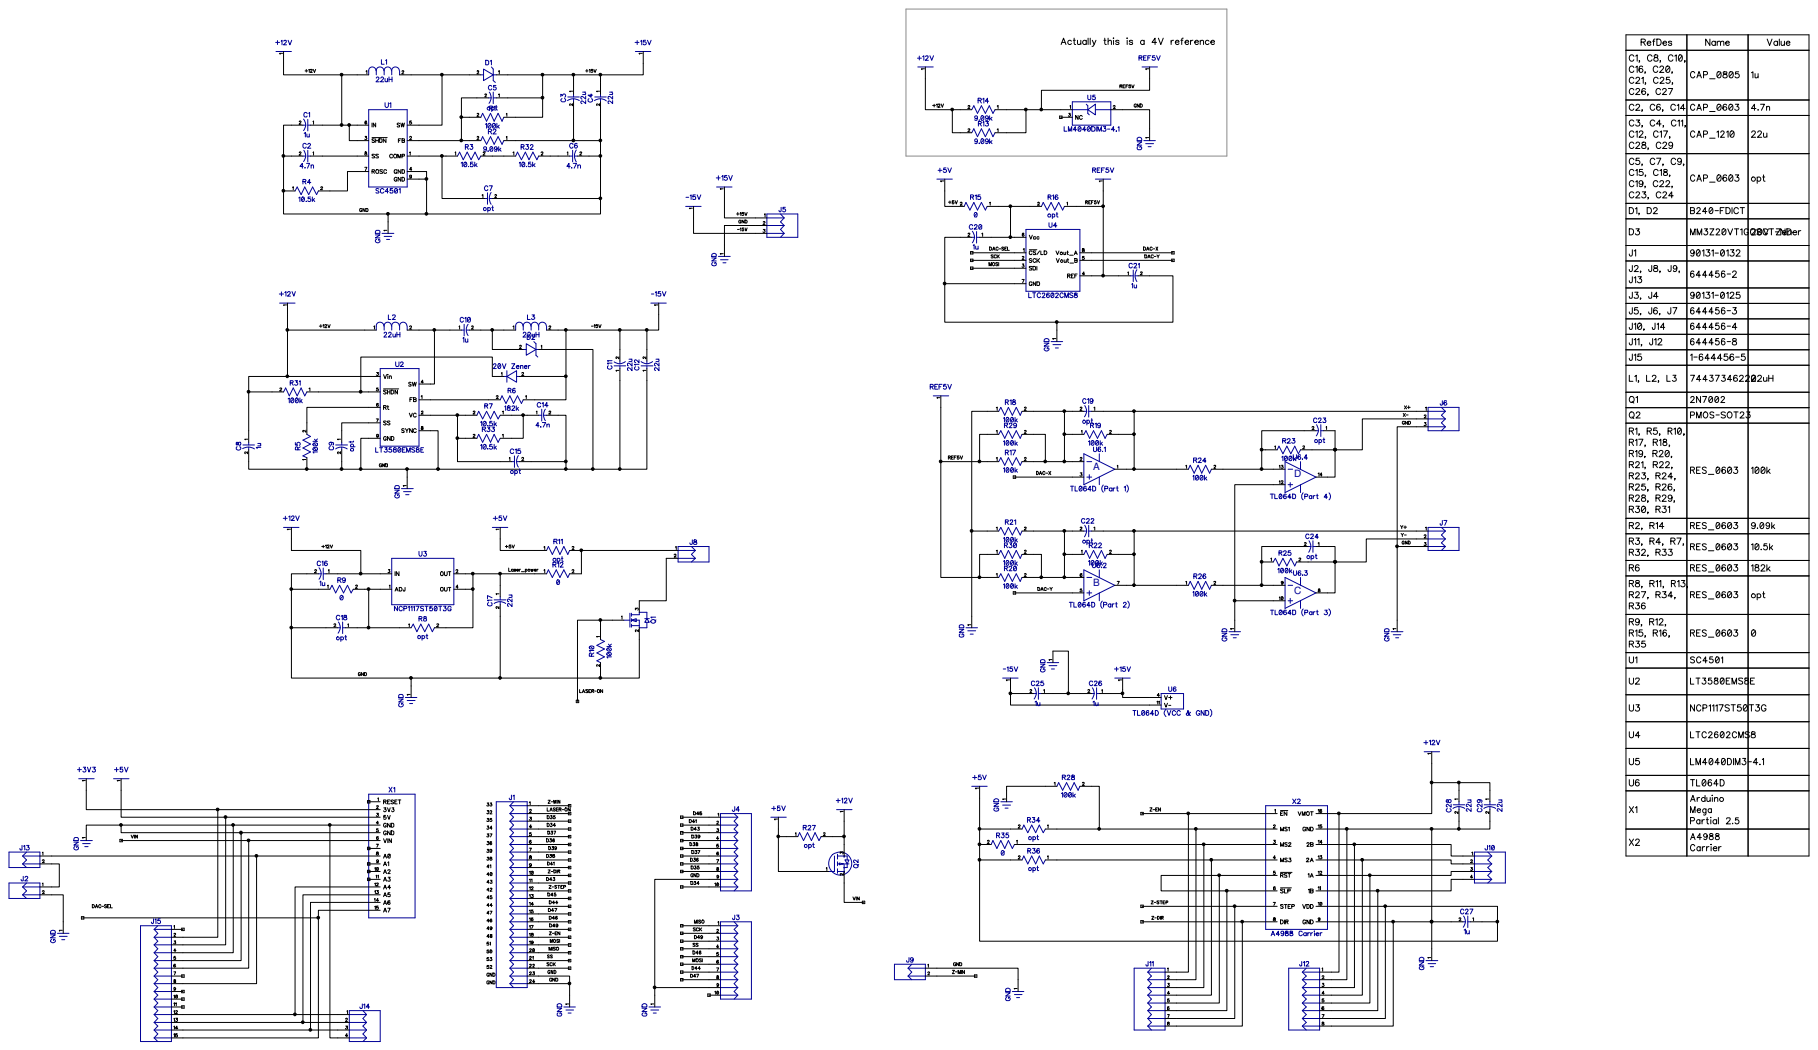
[picture p37: page 1]
