cruiser0002/ResinShield/RS2D/RS2D_top.pdf

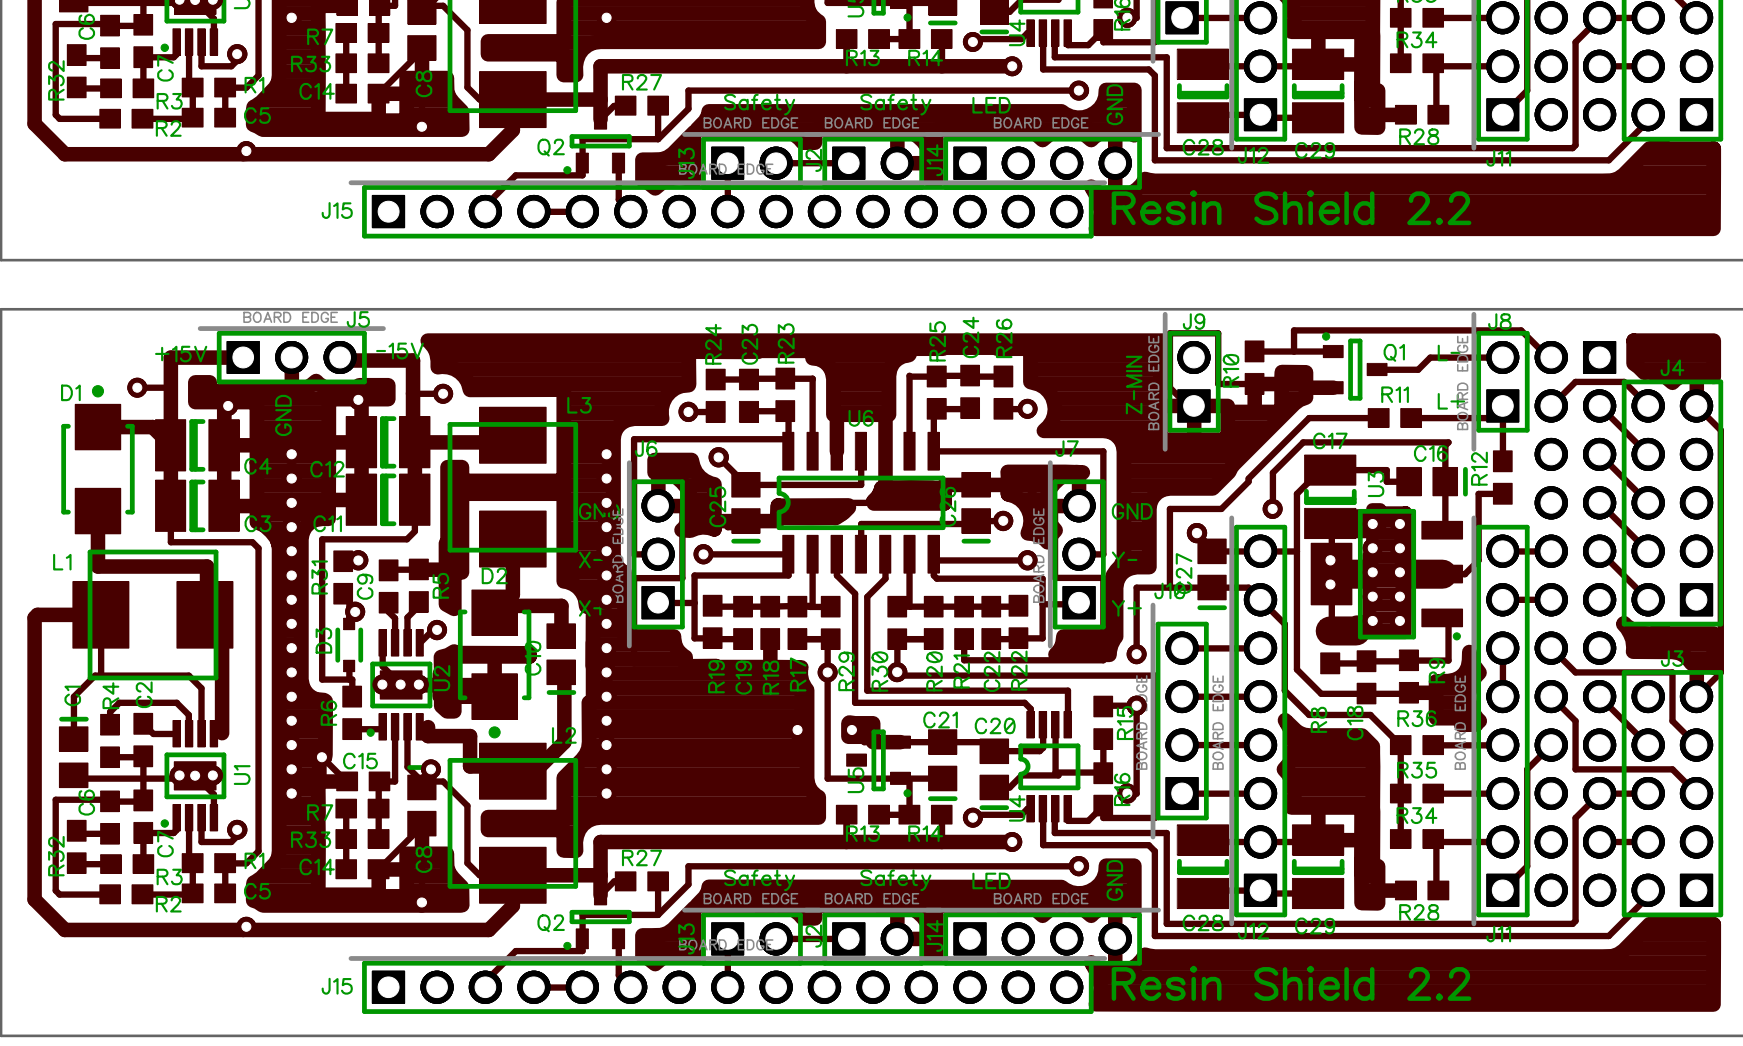
[picture p38: page 1]
