cruiser0002/ResinShield/RS2E/RS2E_bot.pdf

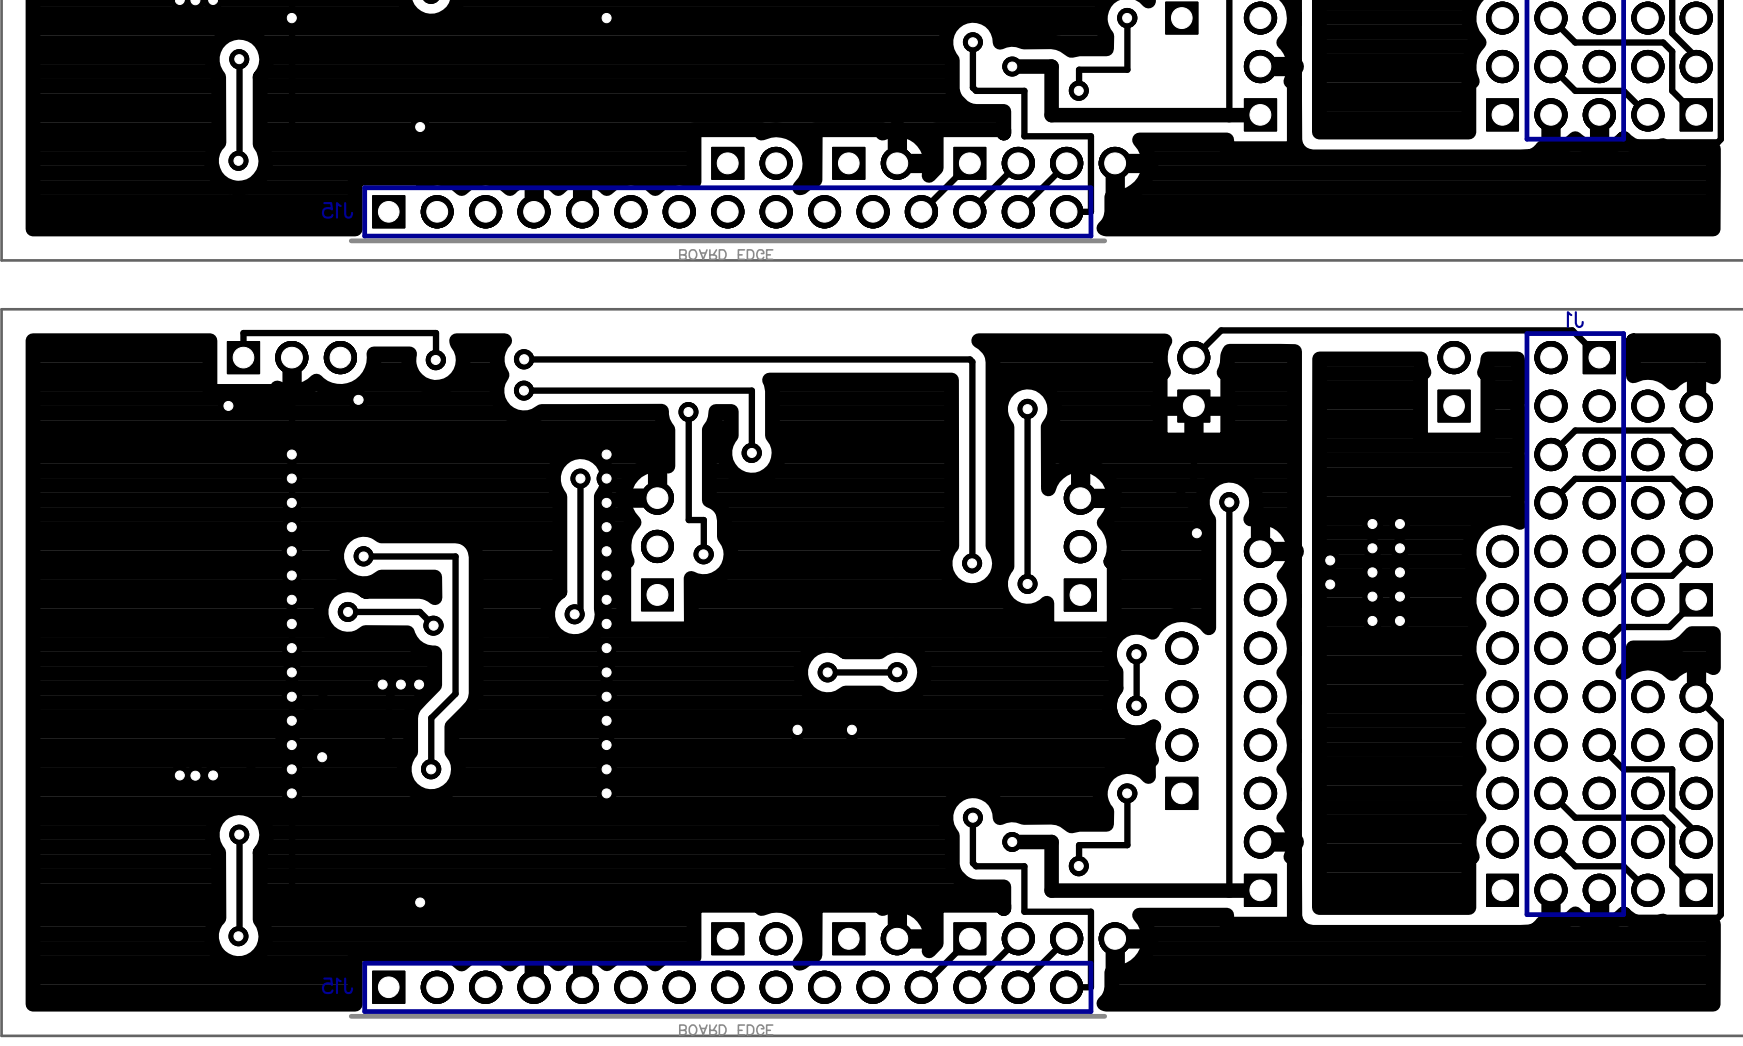
[picture p39: page 1]
