cruiser0002/ResinShield/RS2E/RS2E_sch.pdf

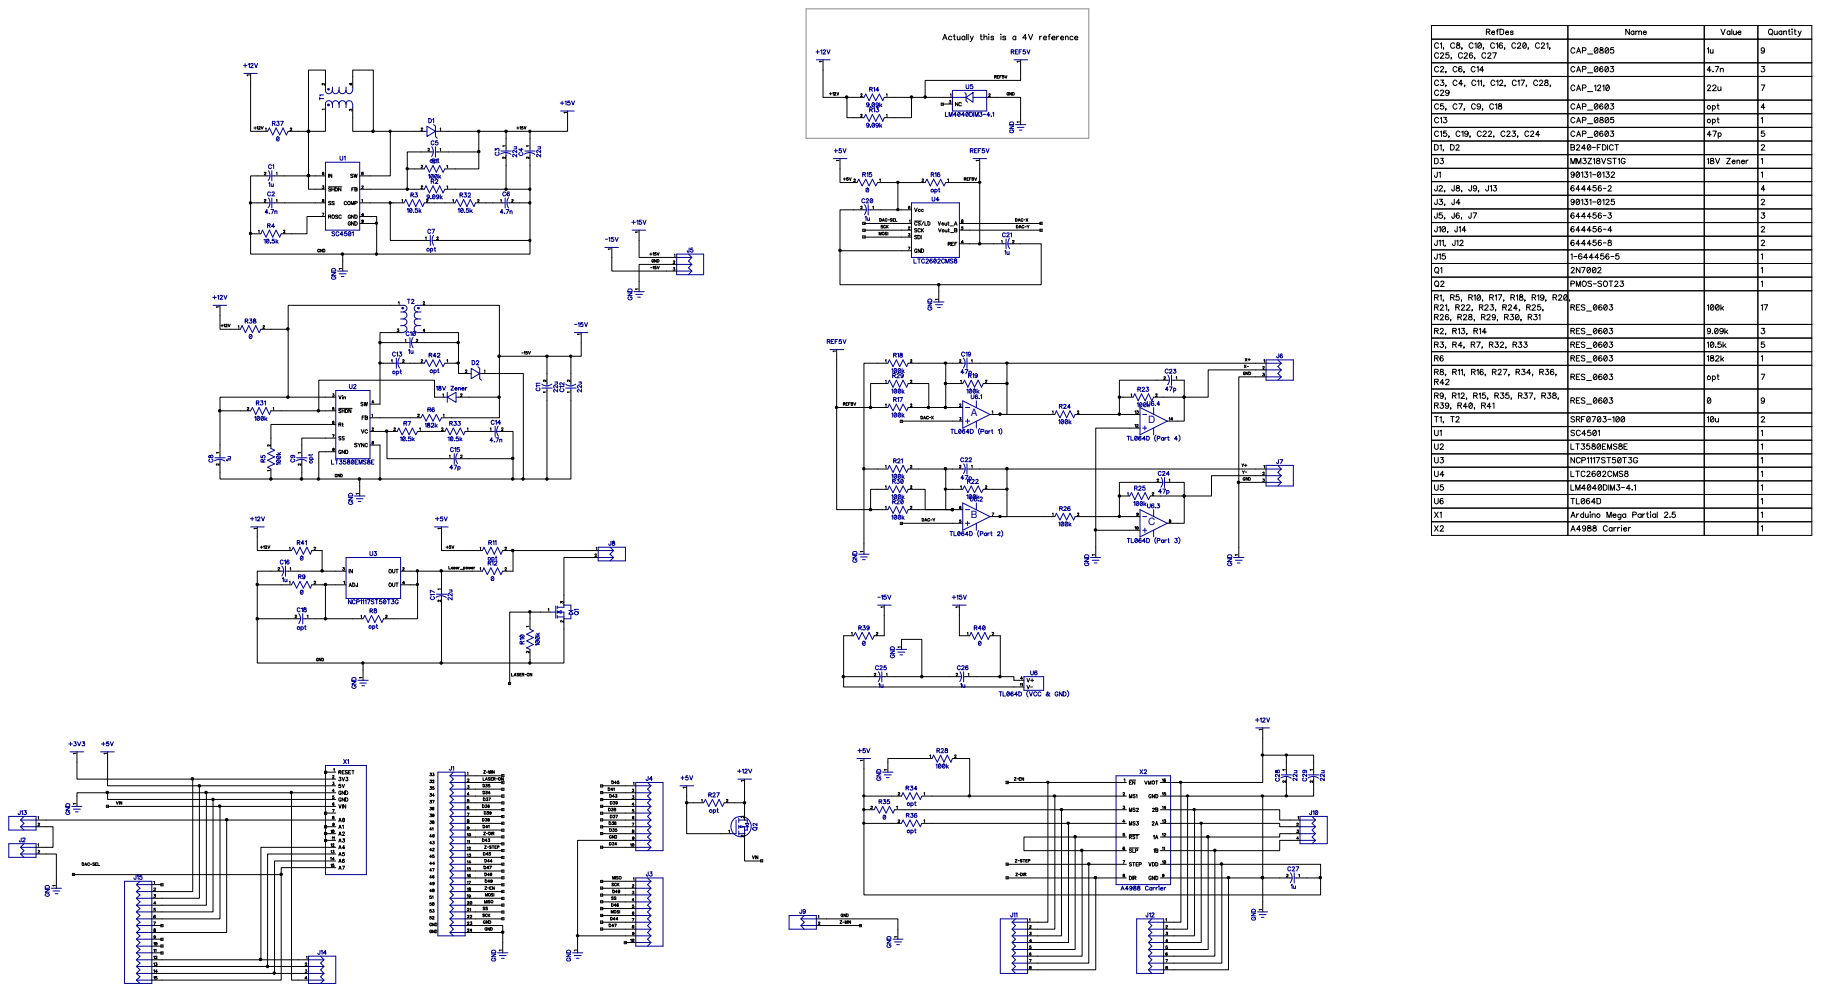
[picture p40: page 1]
