cruiser0002/ResinShield/RS2E/RS2E_top.pdf

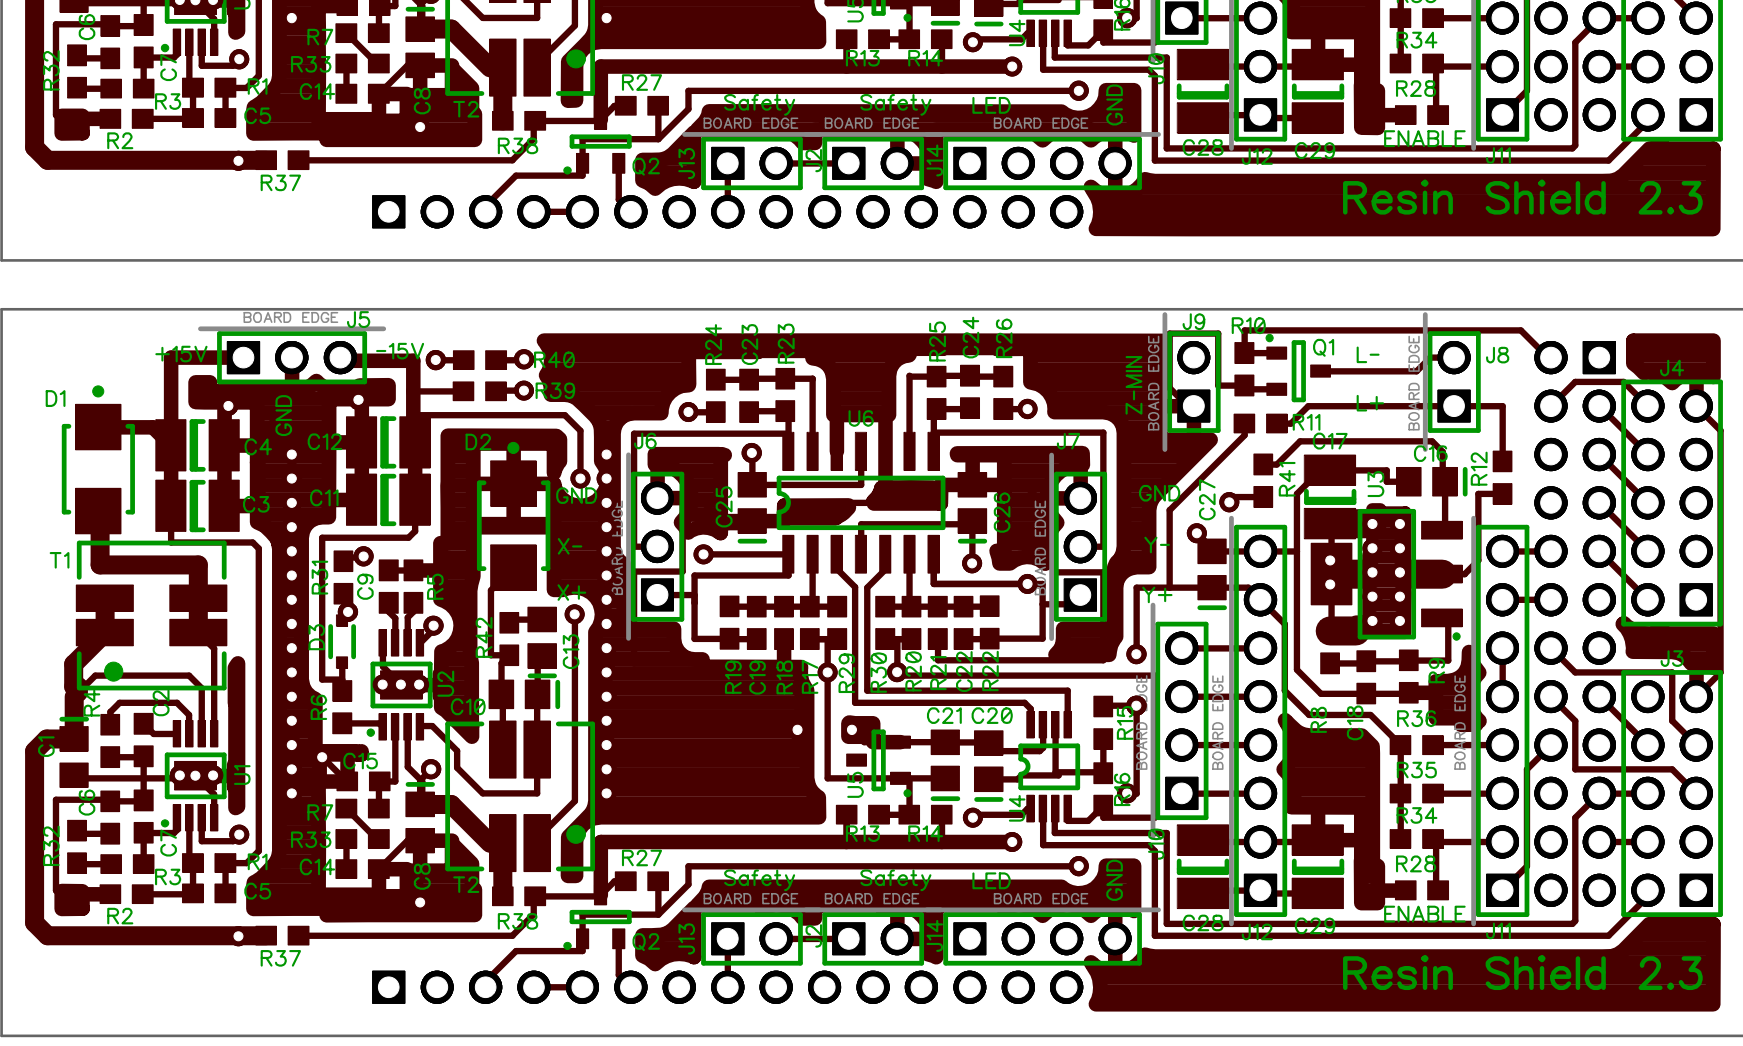
[picture p41: page 1]
