cruiser0002/ResinShield/RS3A/RS3A_bot.pdf

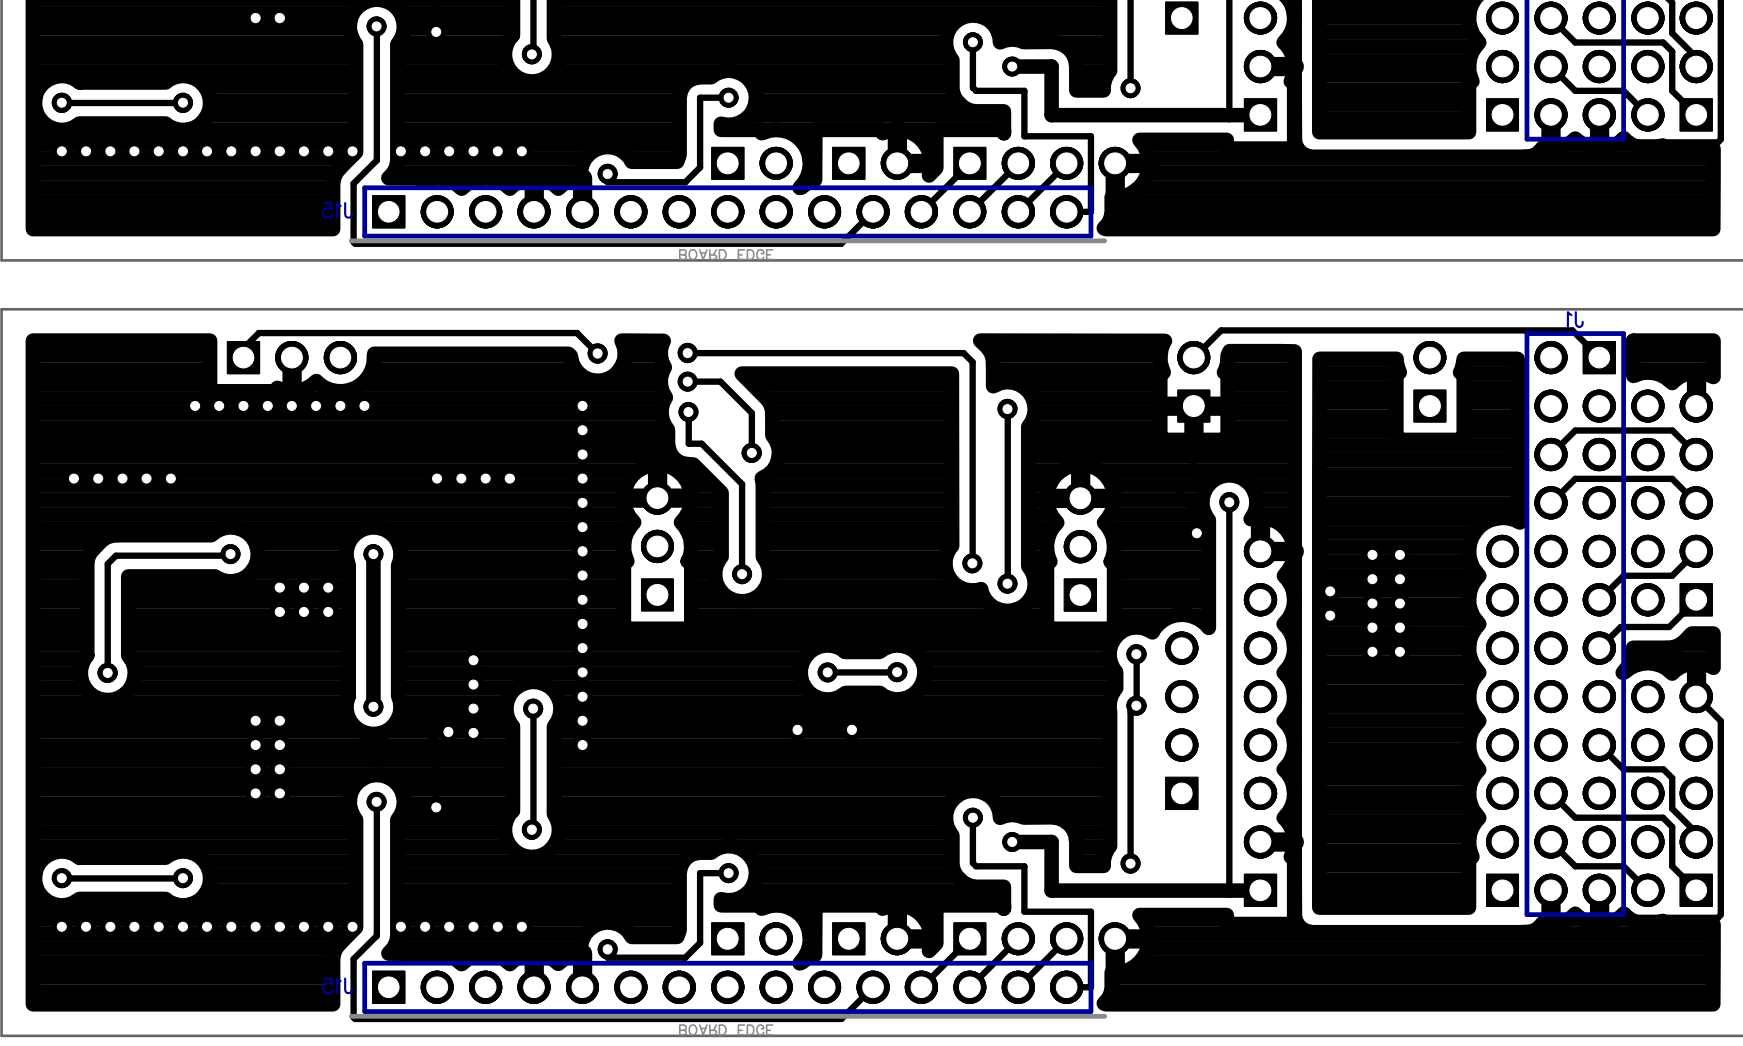
[picture p42: page 1]
