cruiser0002/ResinShield/RS3A/RS3A_sch.pdf

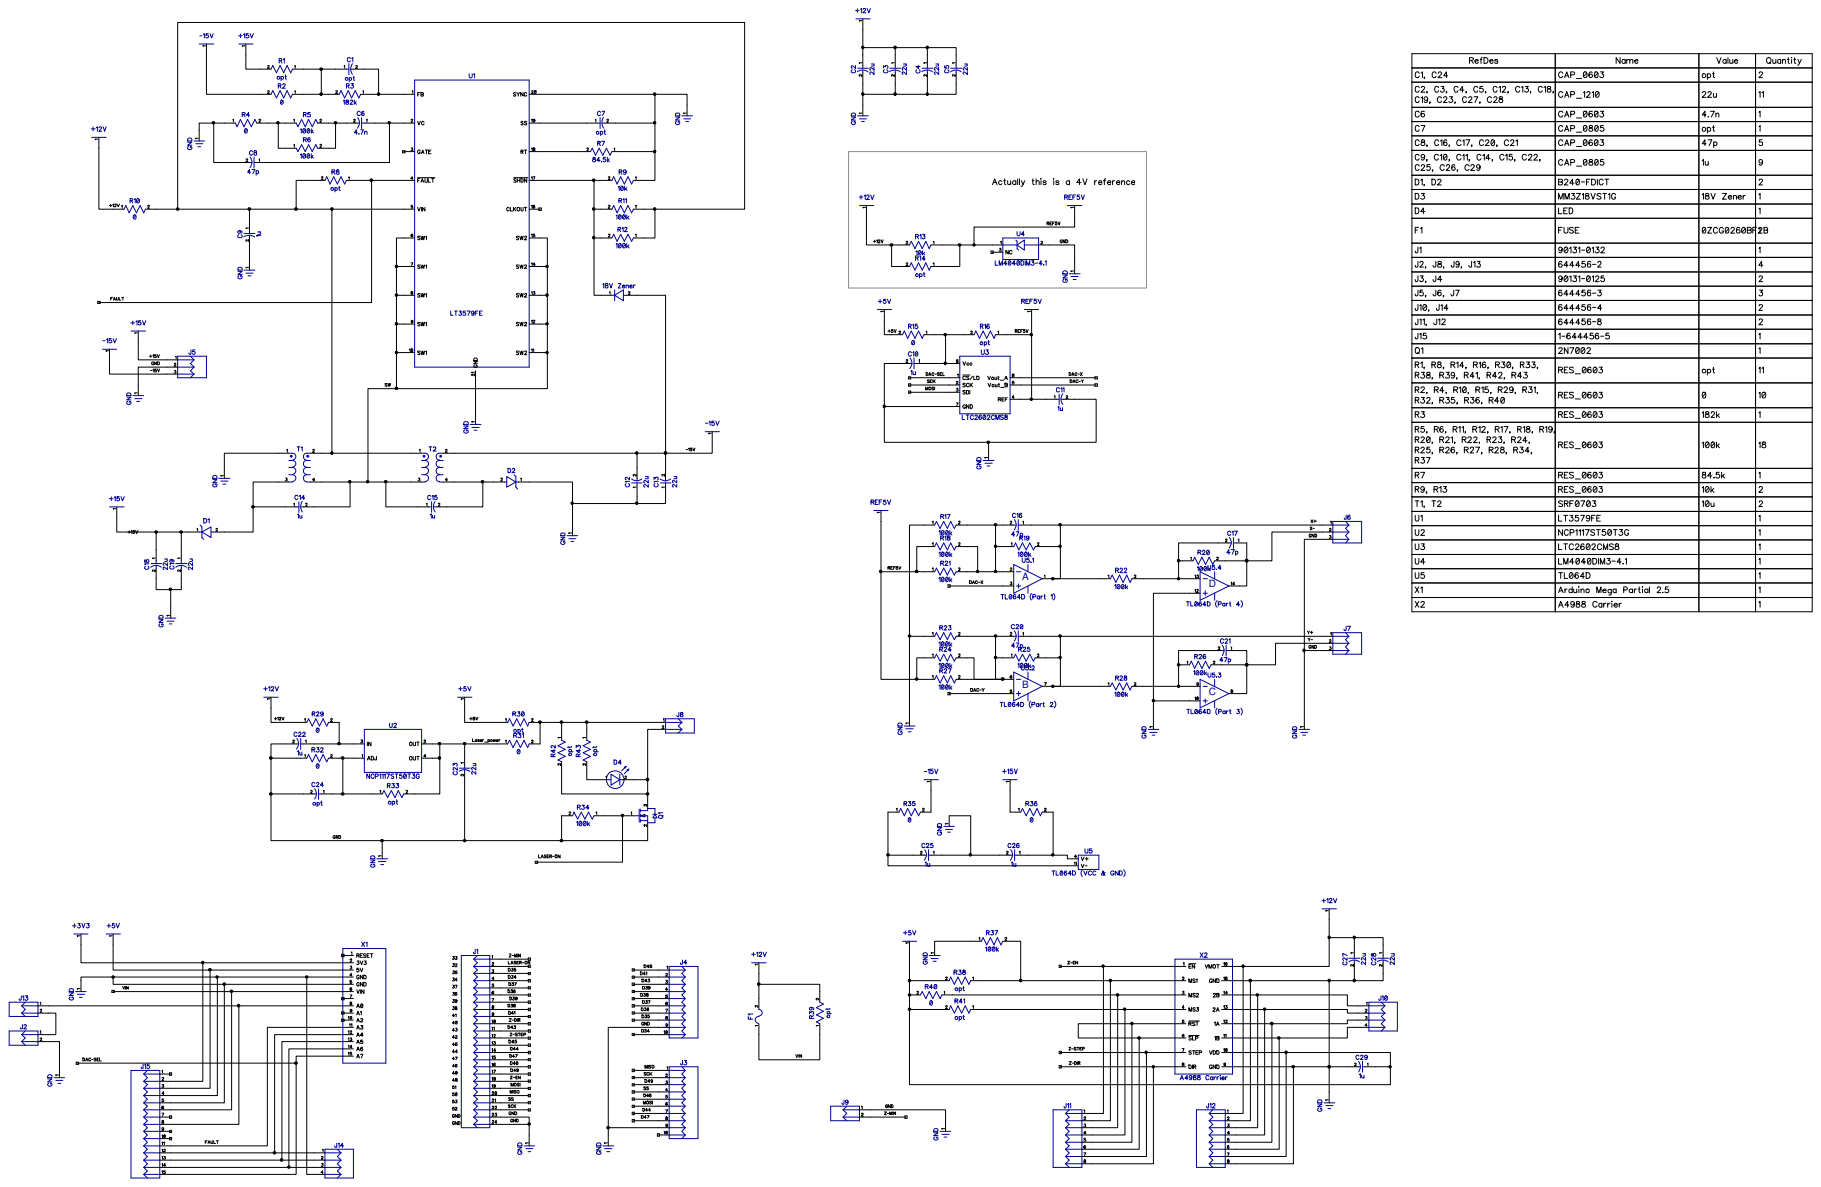
[picture p43: page 1]
