cruiser0002/ResinShield/RS3A/RS3A_top.pdf

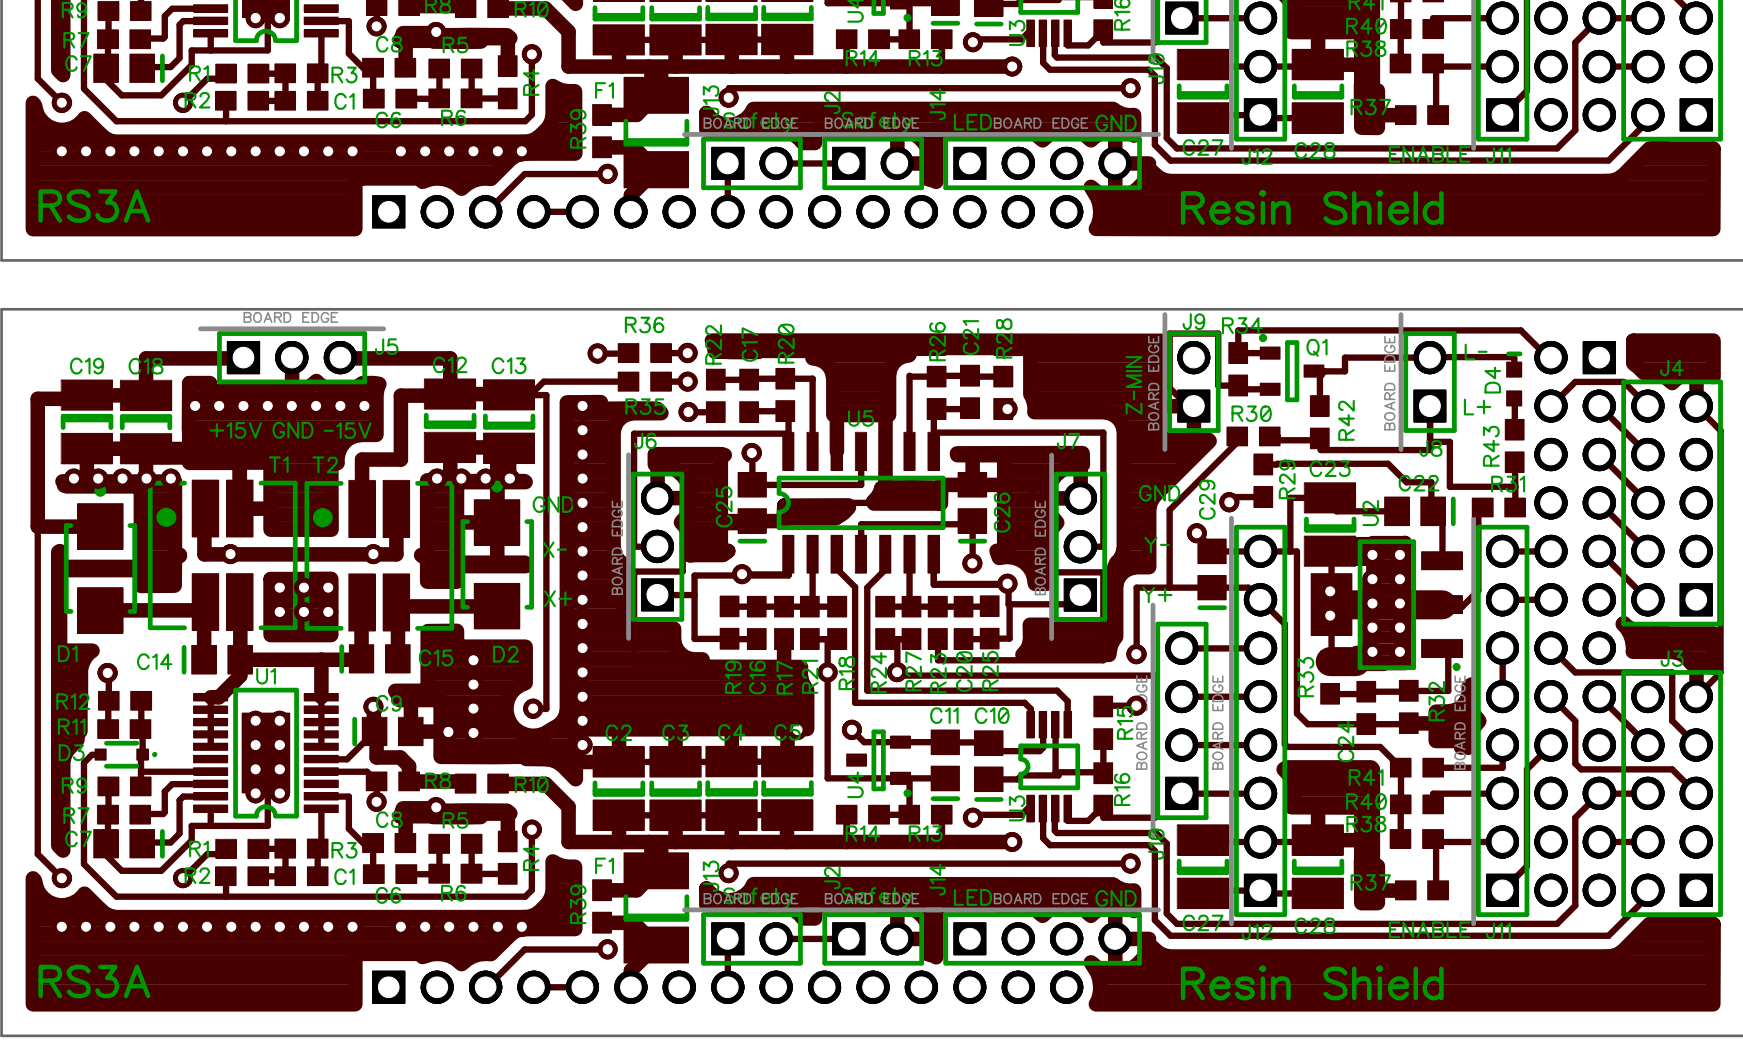
[picture p44: page 1]
