cruiser0002/ResinShield/RS3B/RS3B_bot.pdf

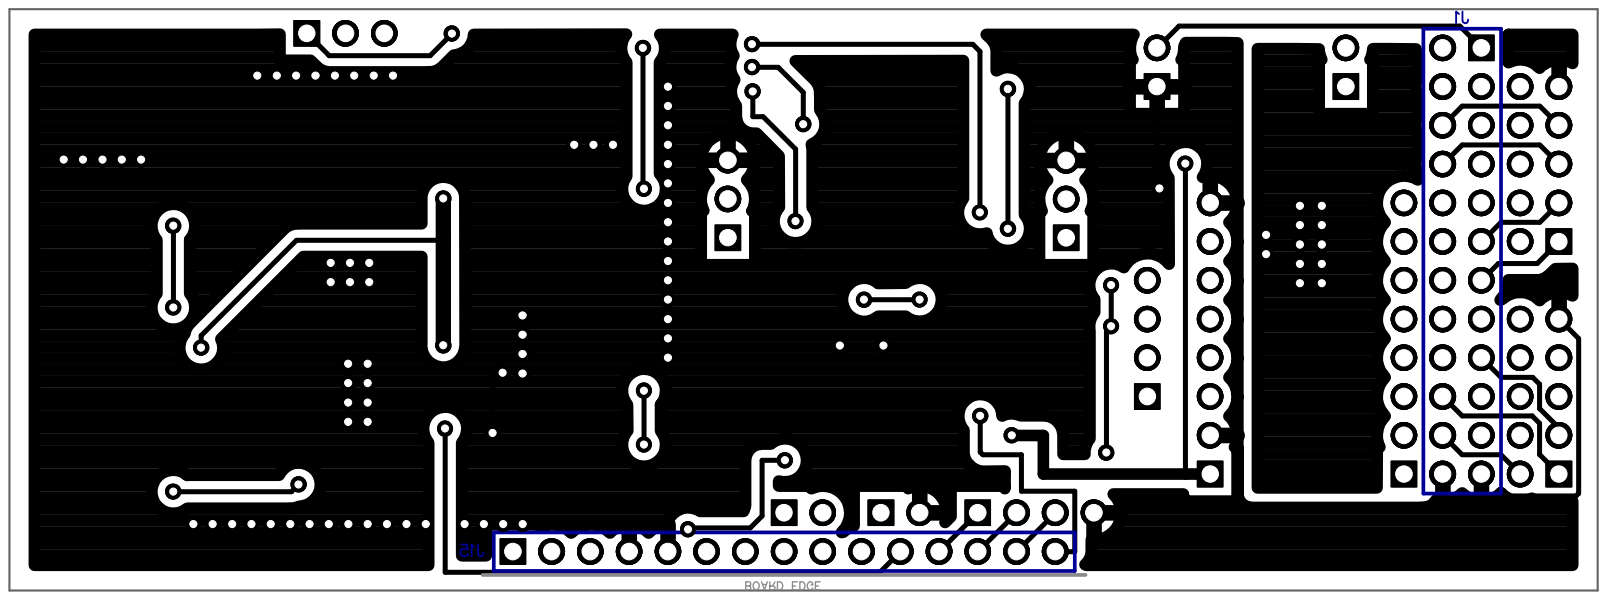
[picture p45: page 1]
