cruiser0002/ResinShield/RS3B/RS3B_top.pdf

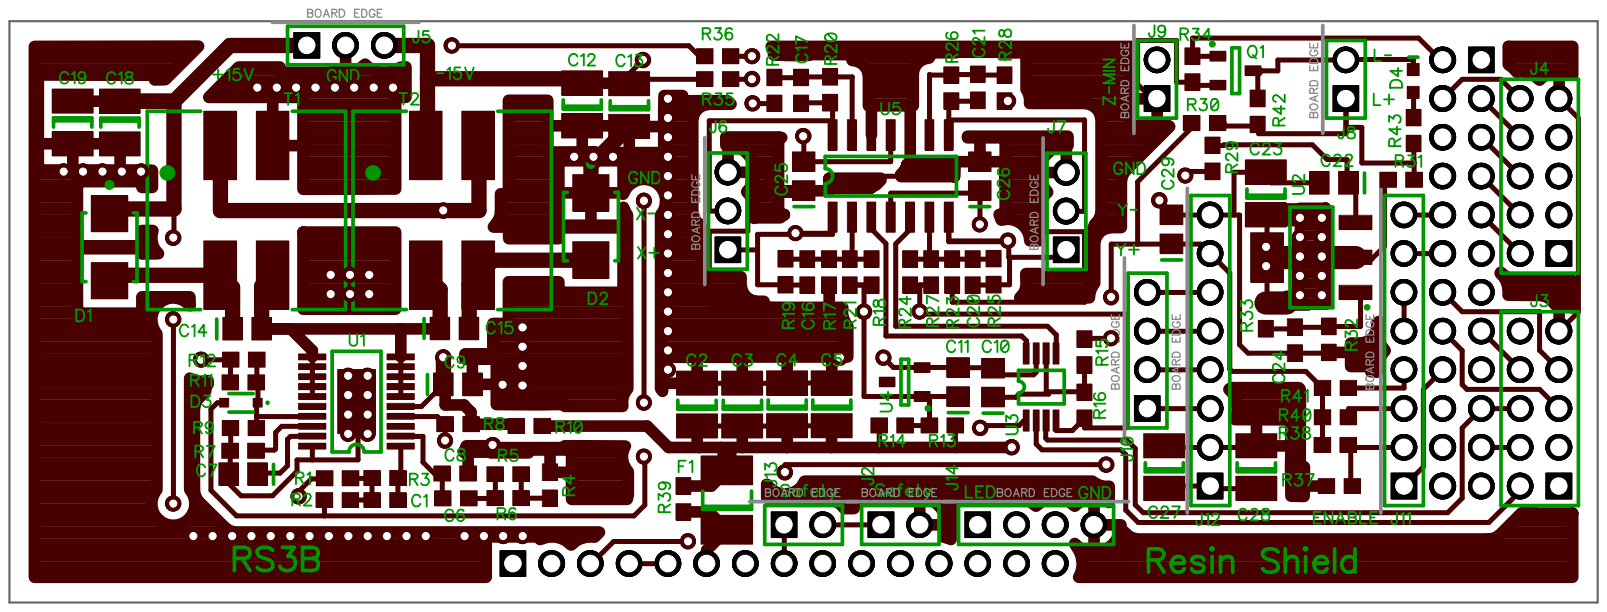
[picture p46: page 1]
