cruiser0002/ResinShield/RevE/DipTrace Schematic - resinshield.pdf

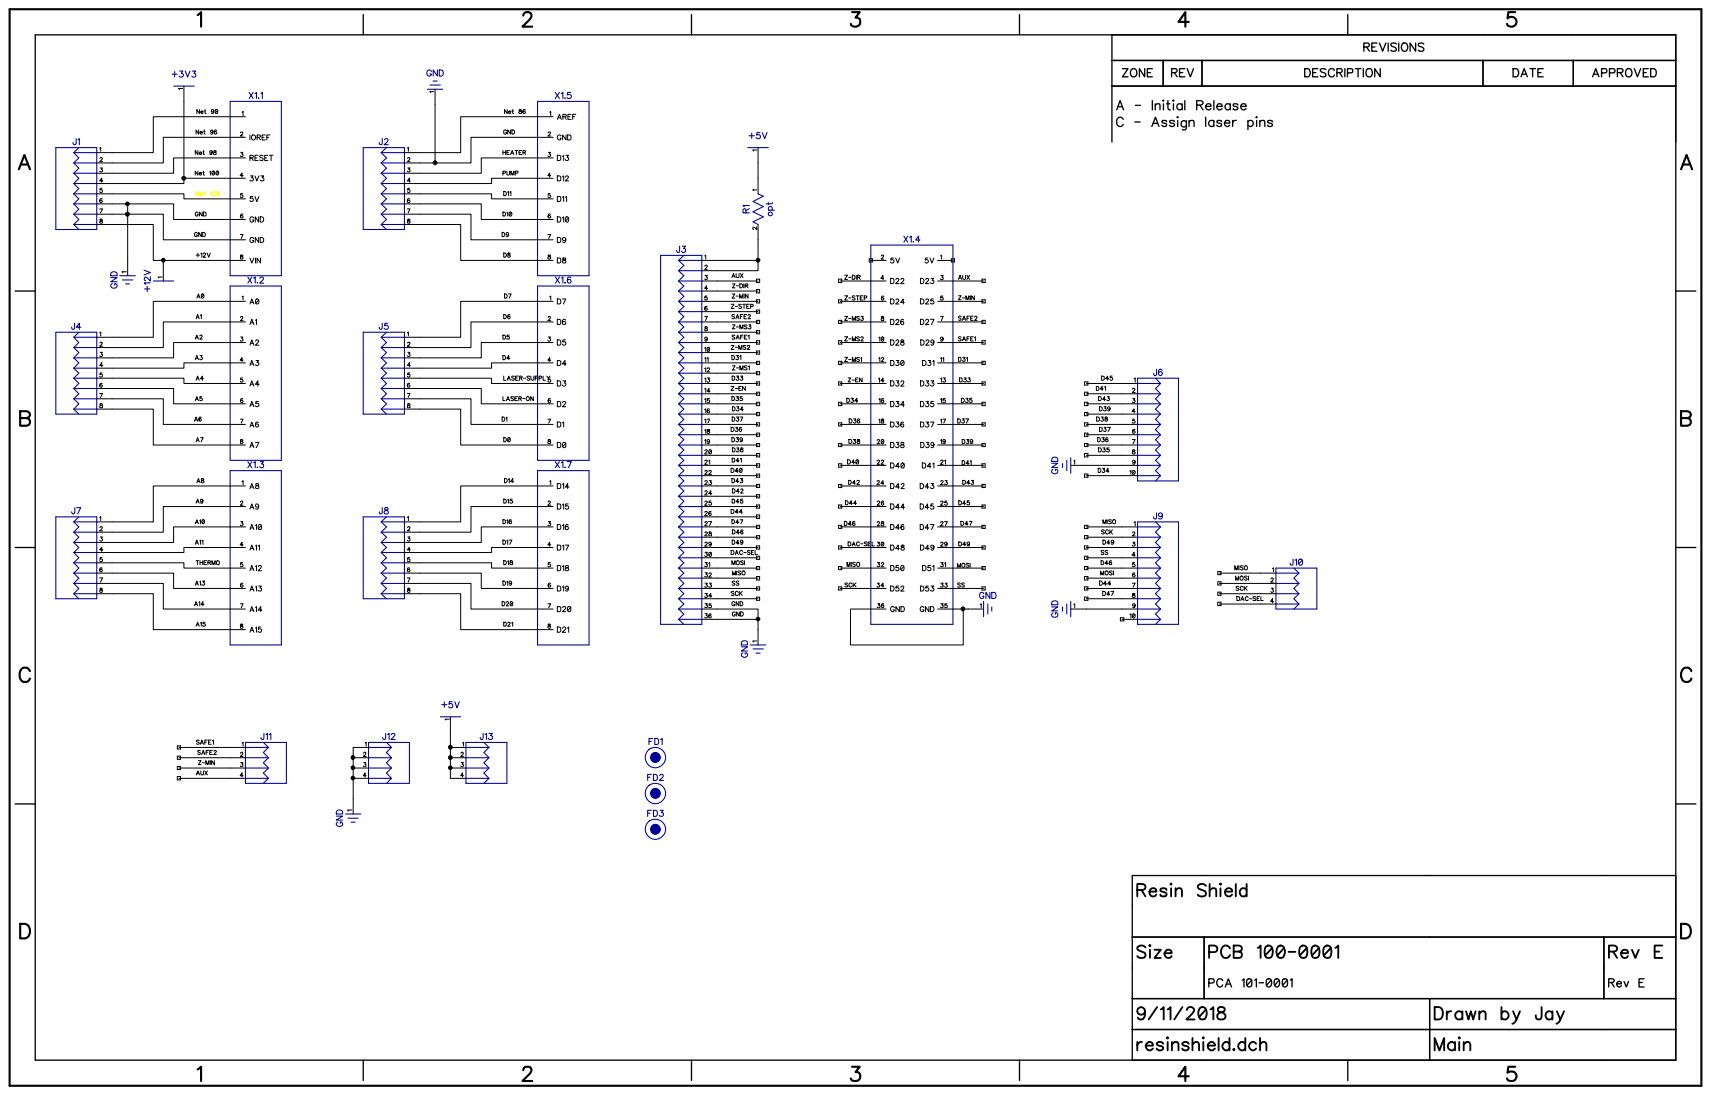
[picture p47: page 1]




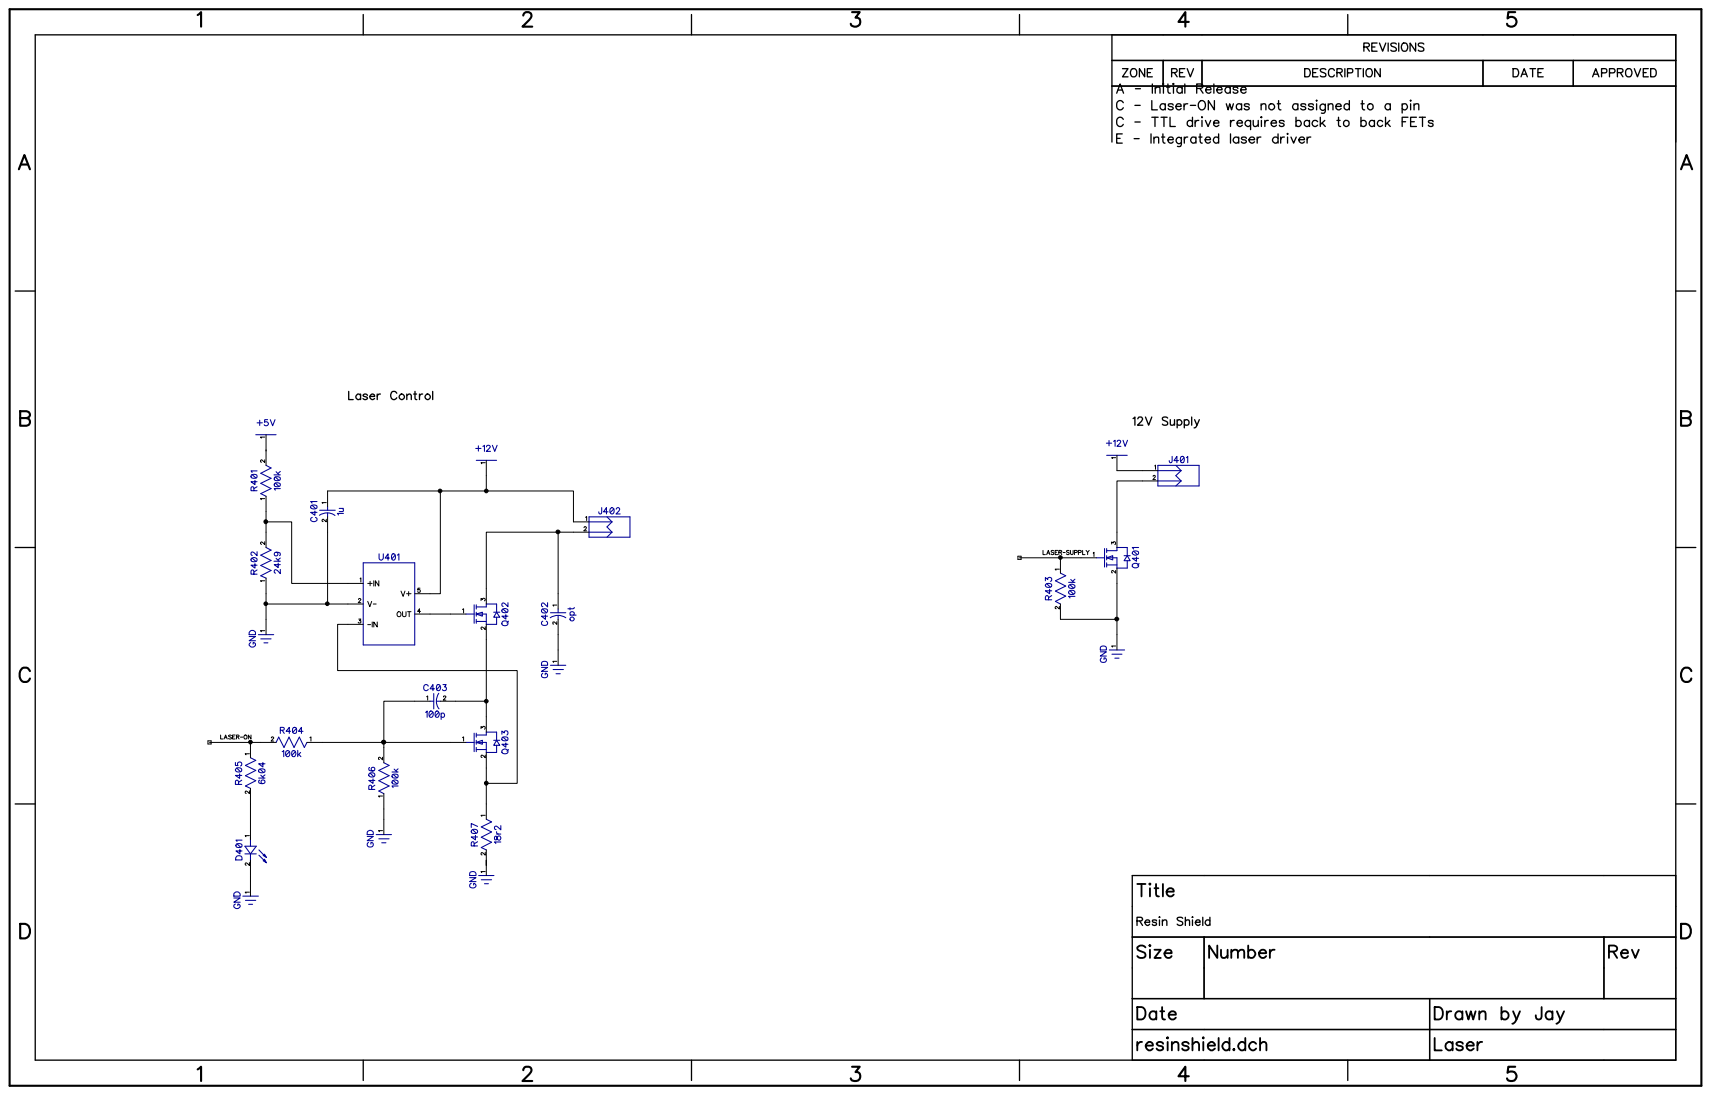
[picture p48: page 5]


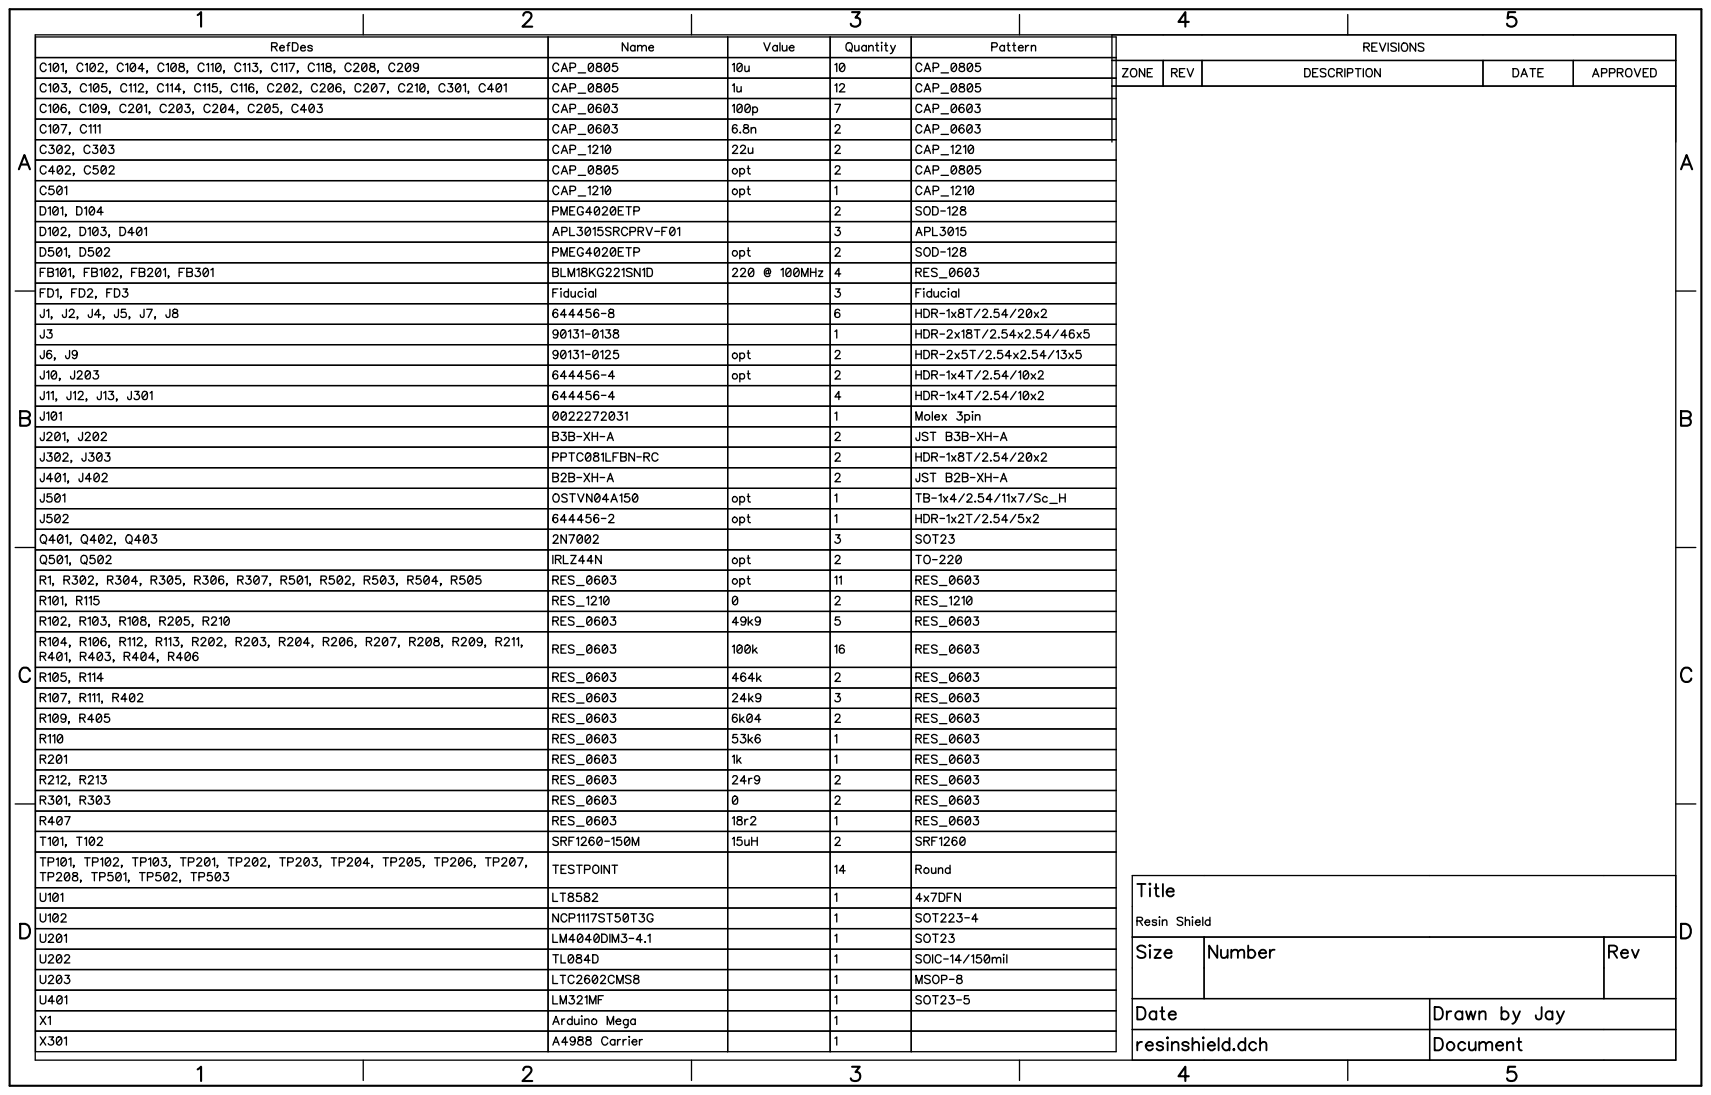
[picture p49: page 7]
