cruiser0002/ResinShield/RevD/DipTrace Schematic - resinshield.pdf

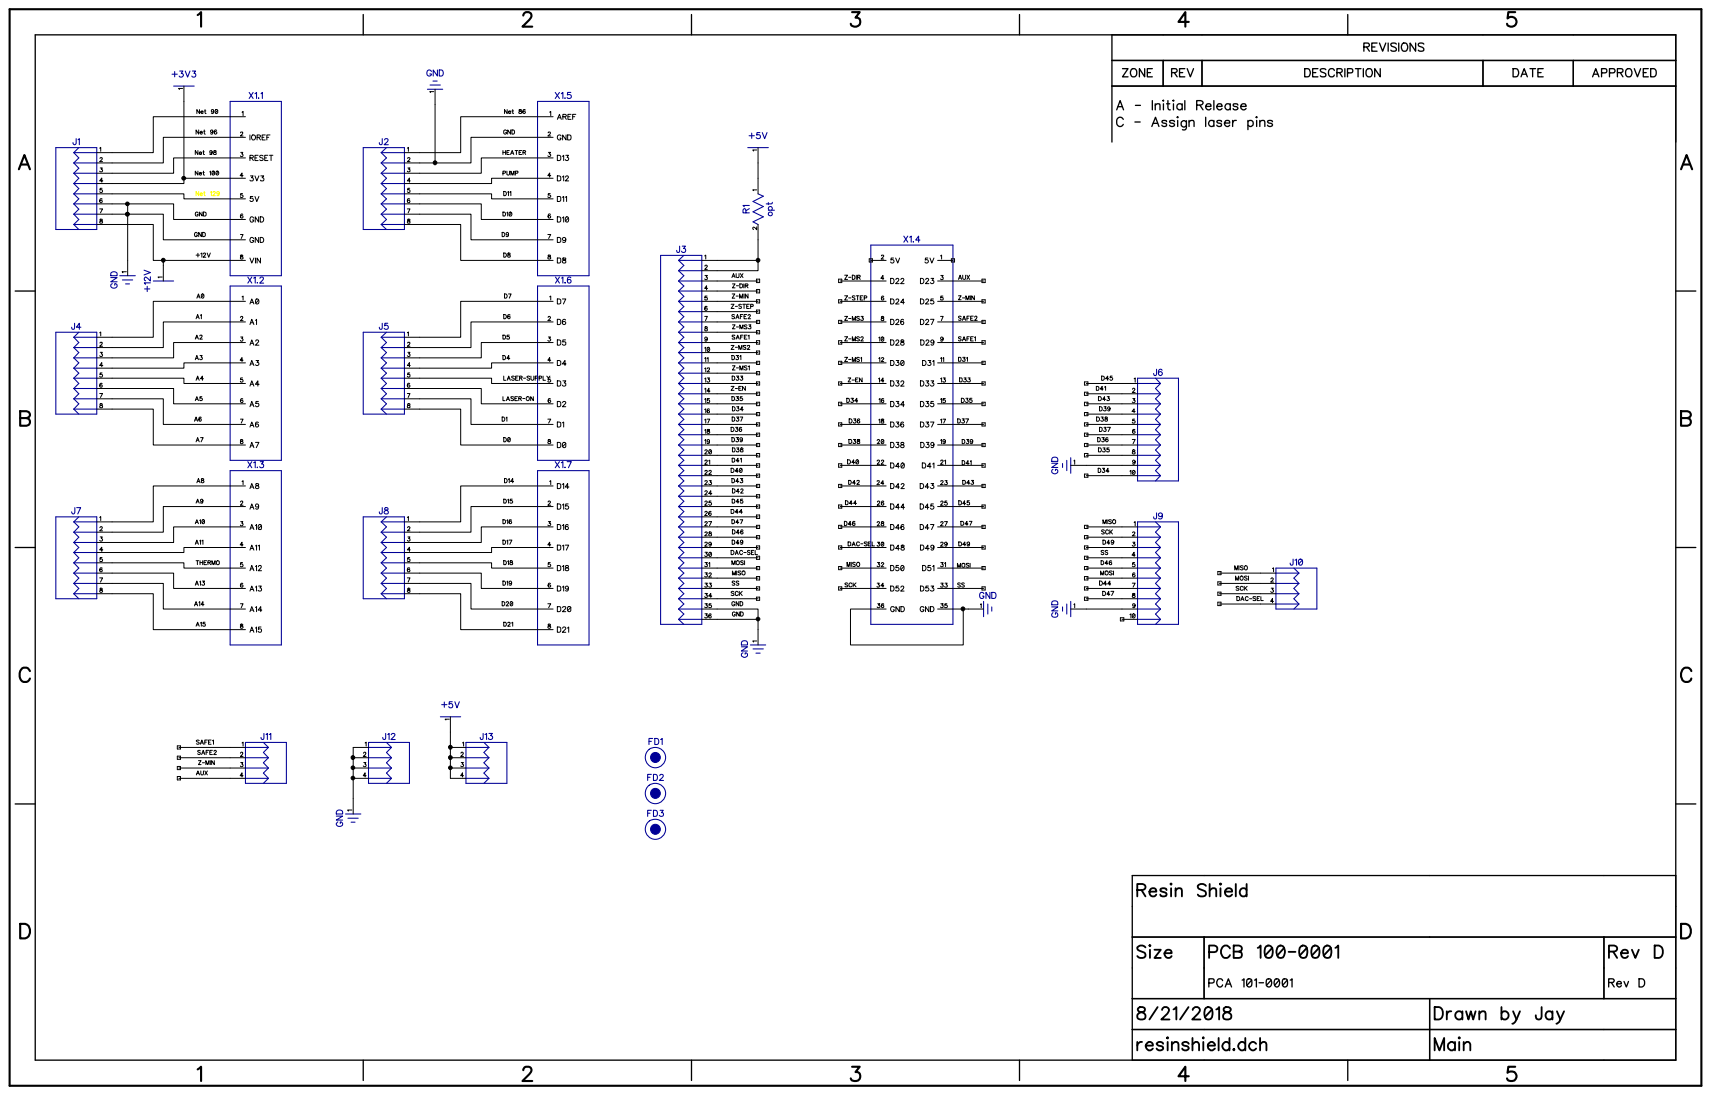
[picture p50: page 1]

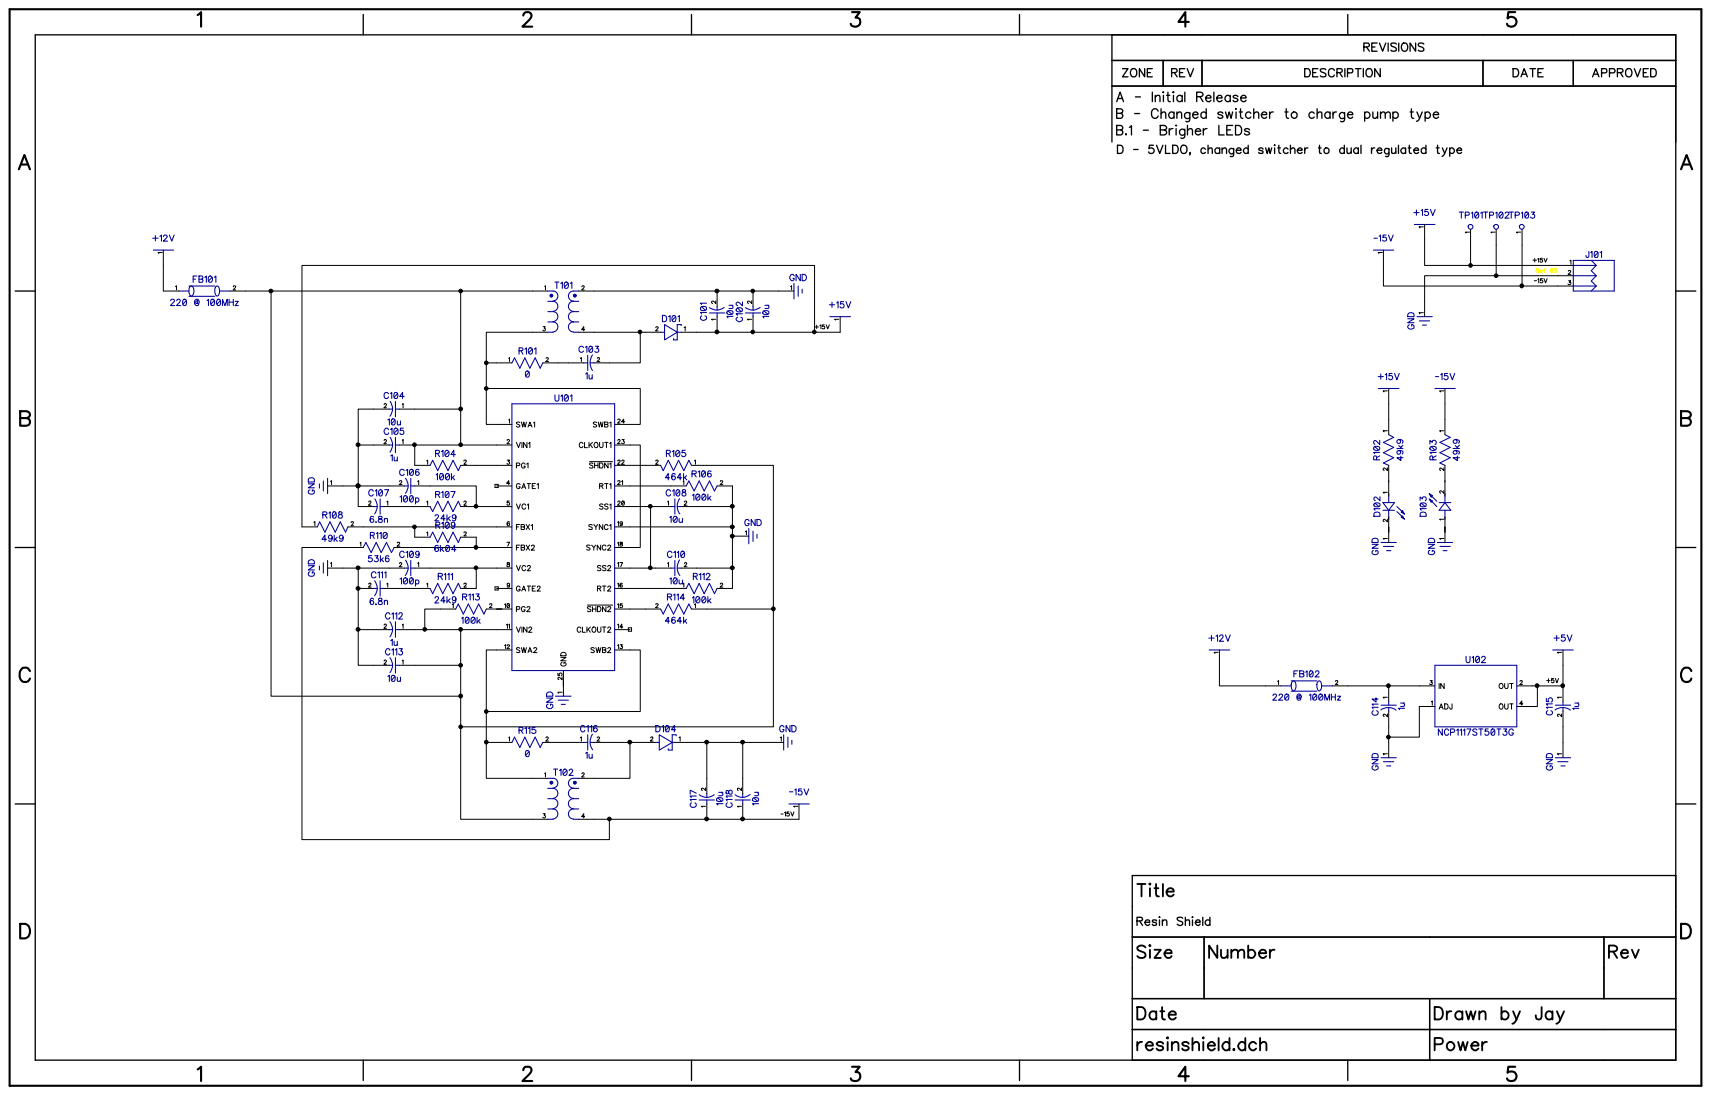
[picture p51: page 2]

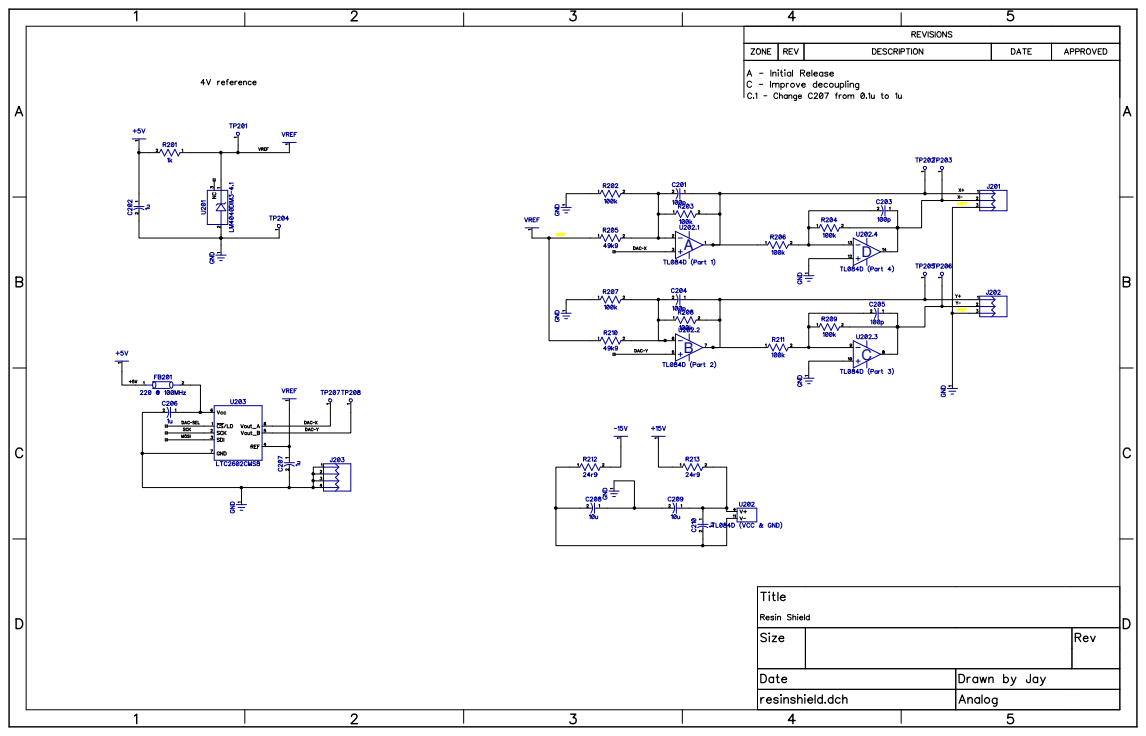
[picture p52: page 3]


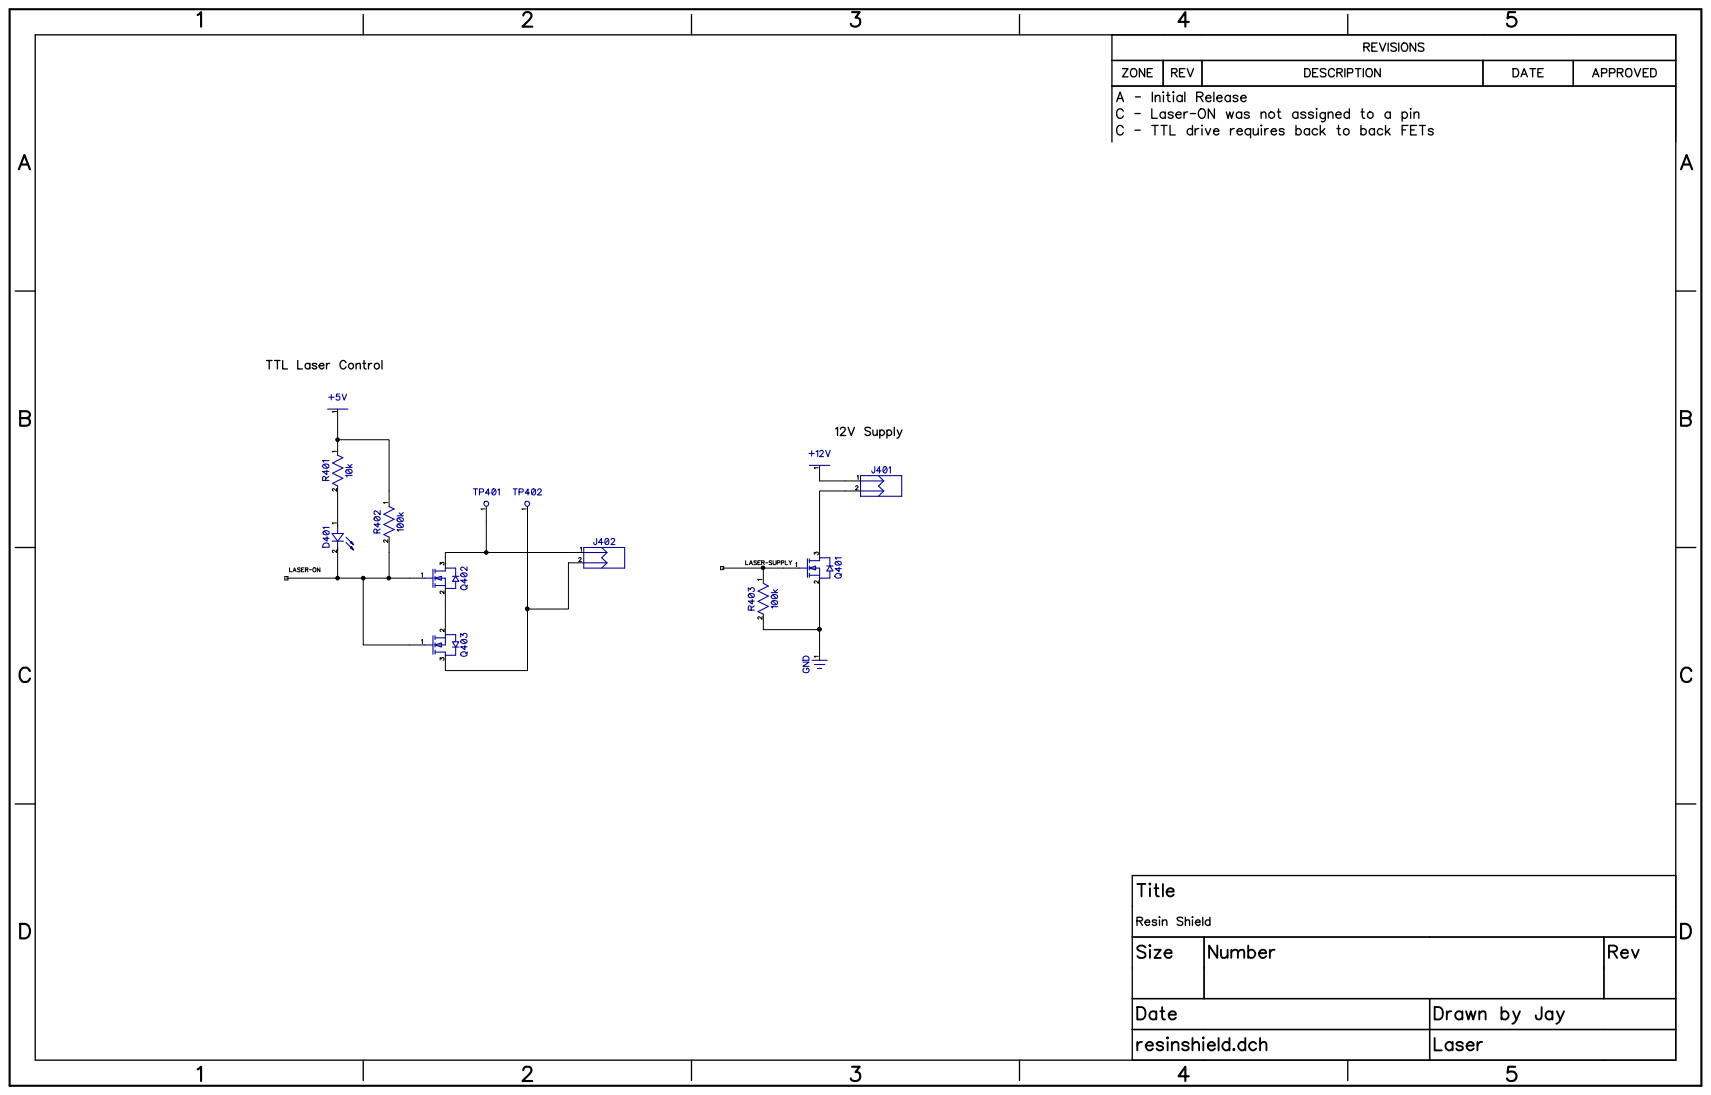
[picture p53: page 5]

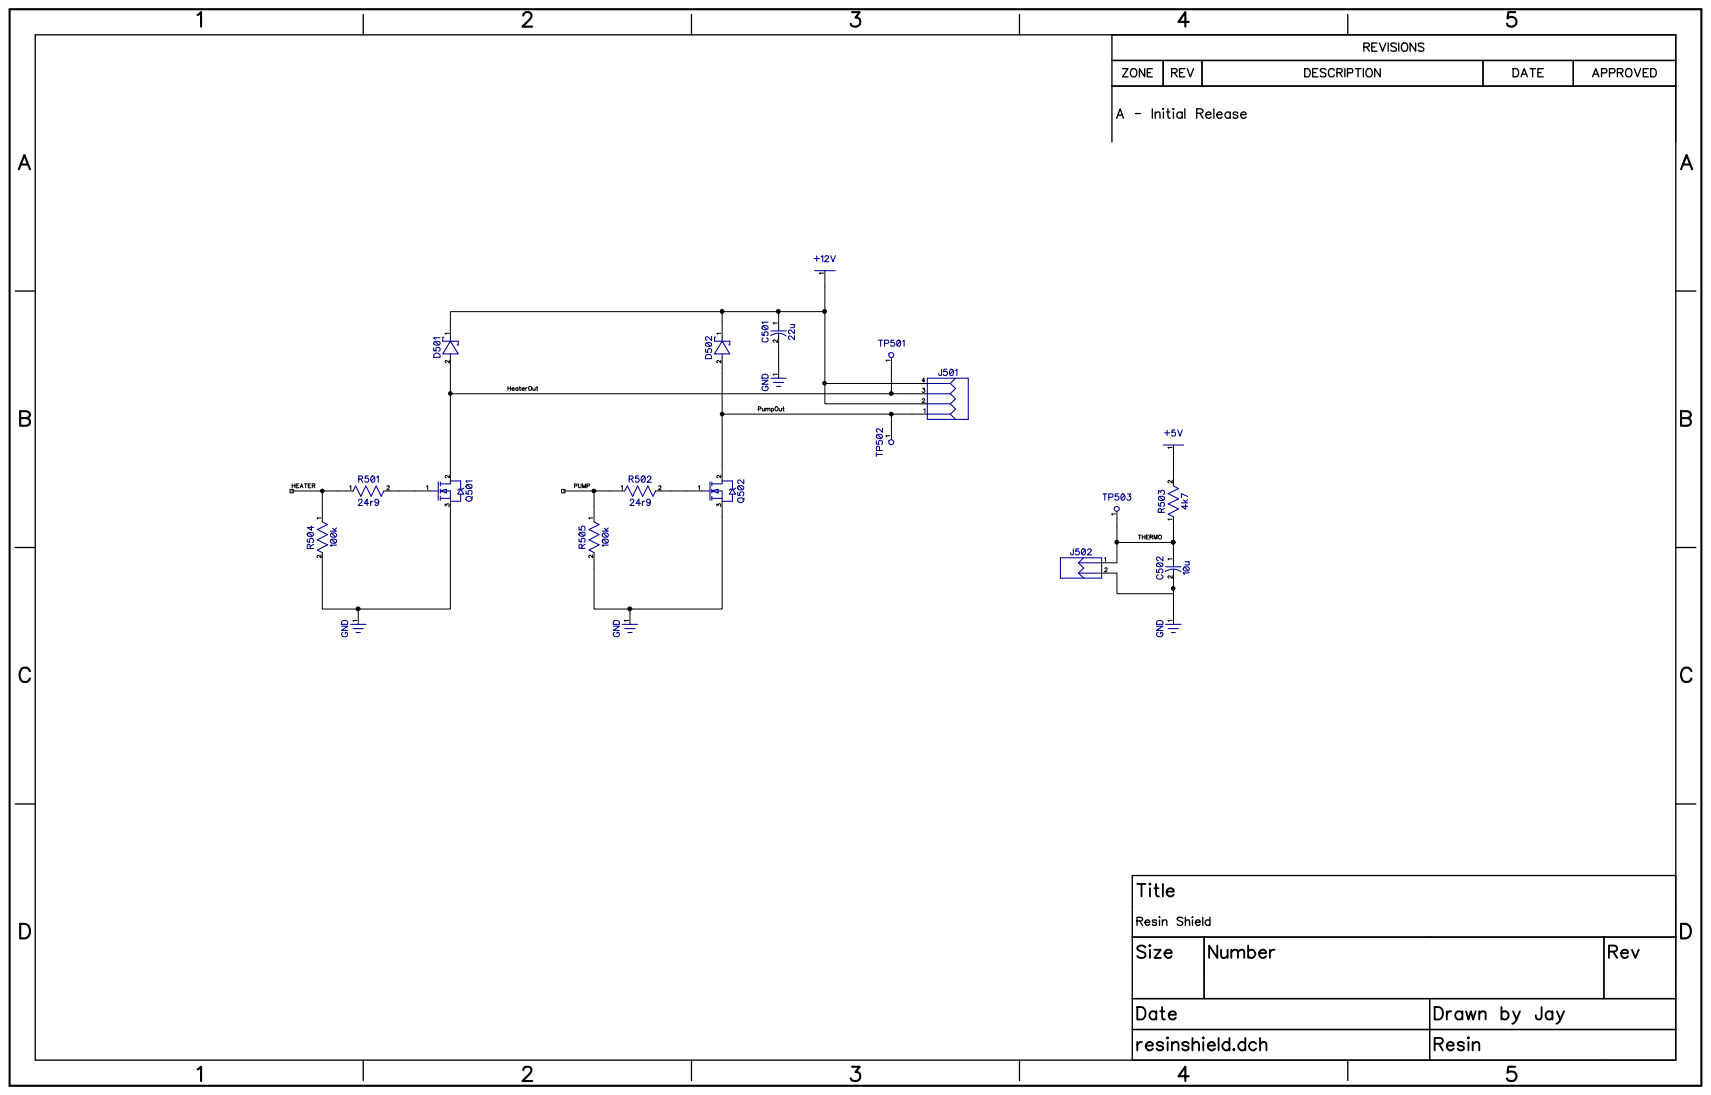
[picture p54: page 6]

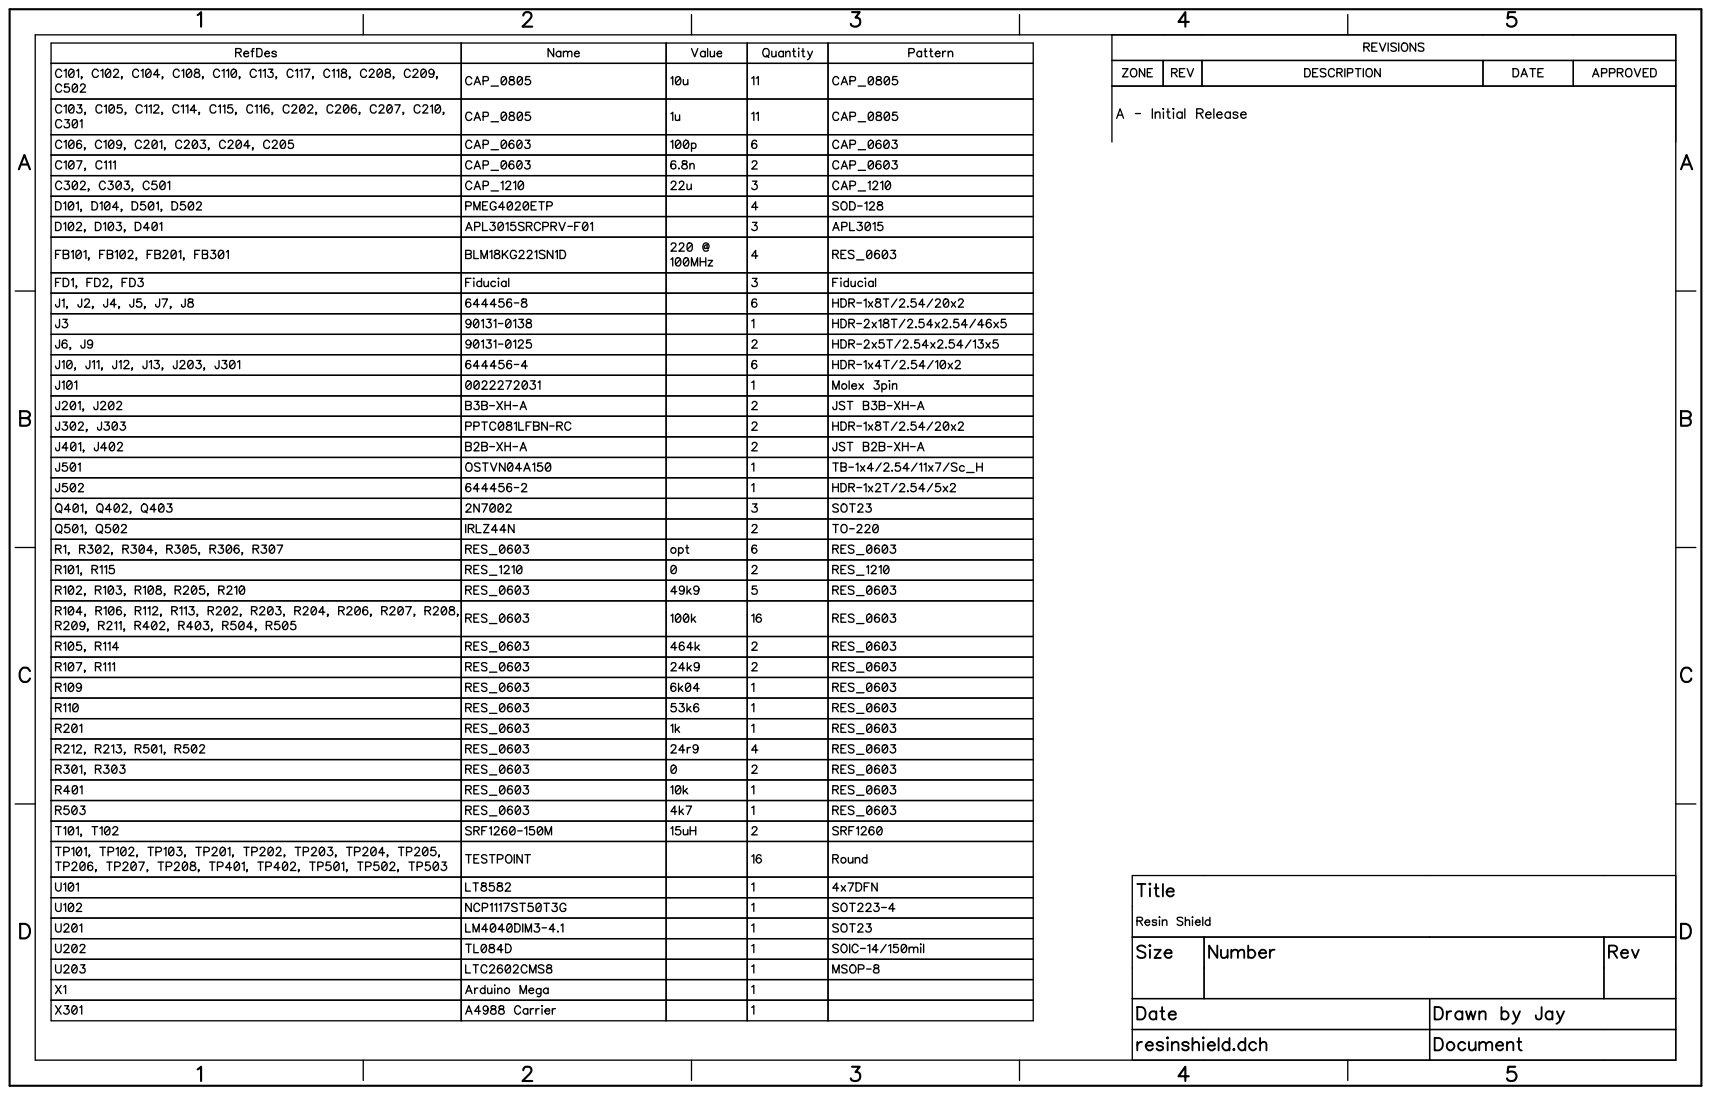
[picture p55: page 7]
