cruiser0002/ResinShield/RevA/DipTrace Schematic - resinshield.pdf

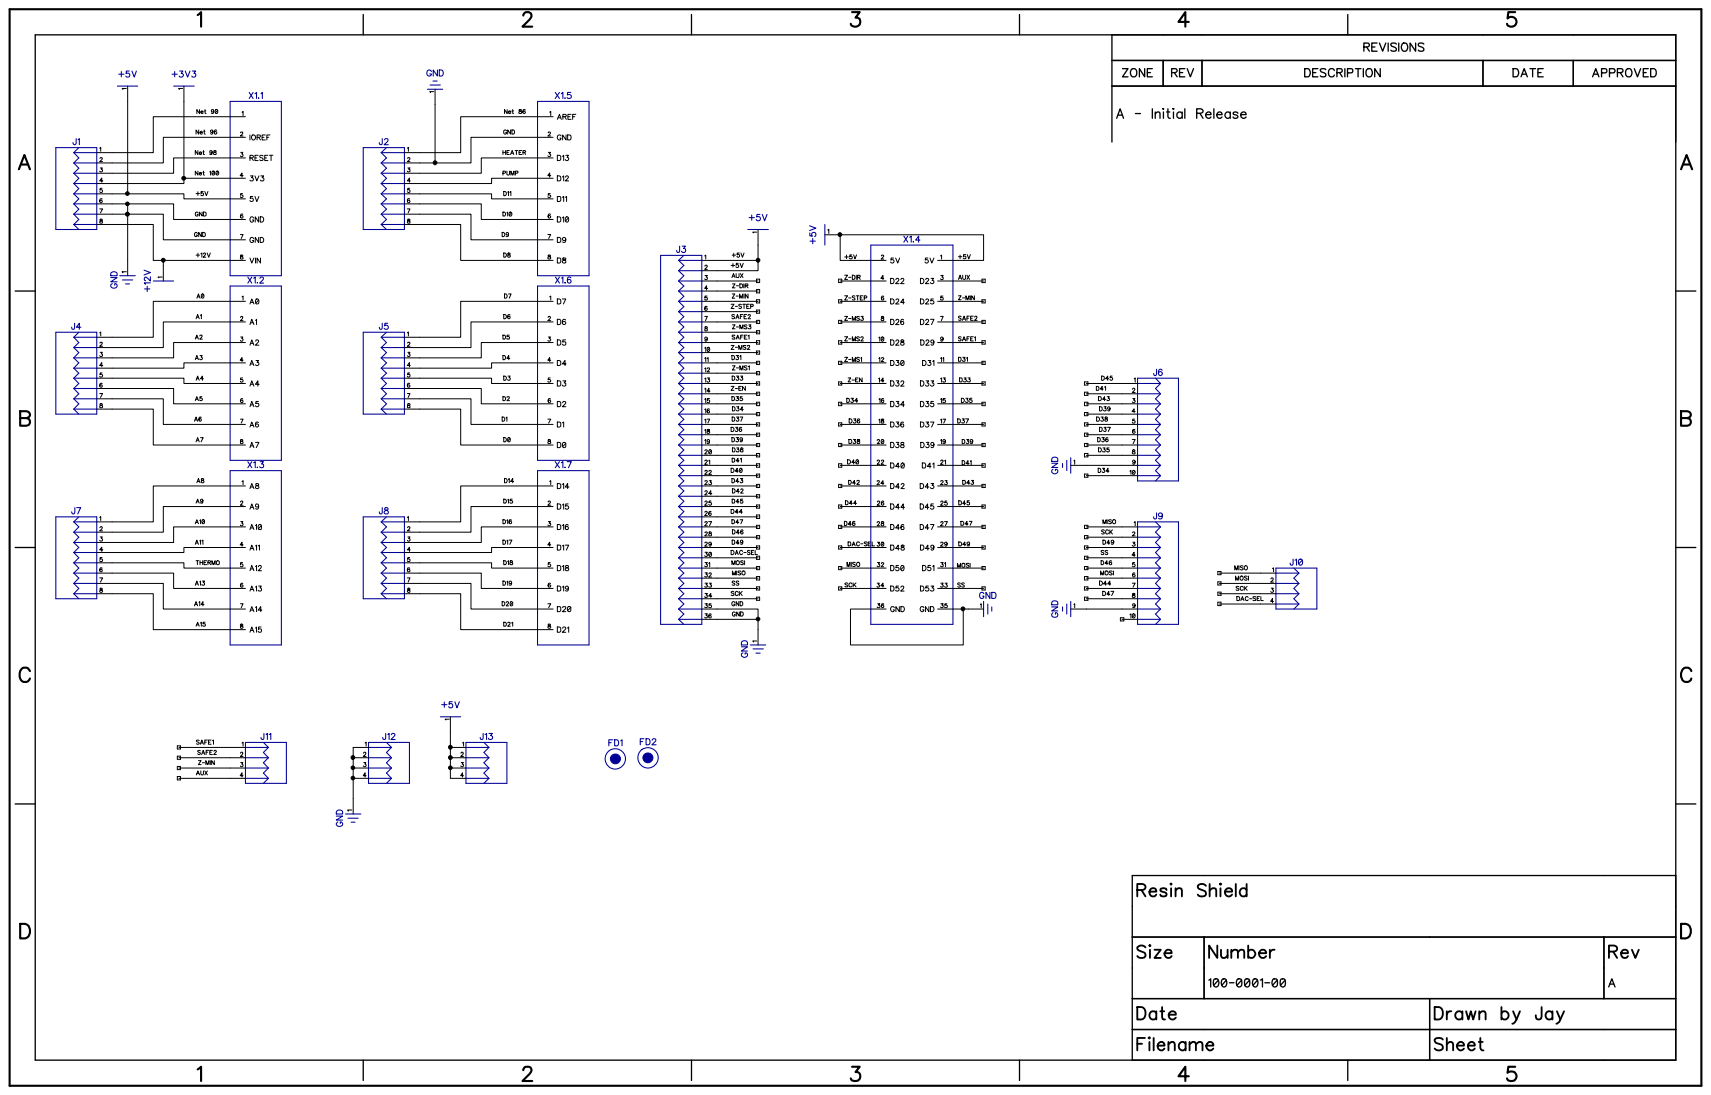
[picture p56: page 1]

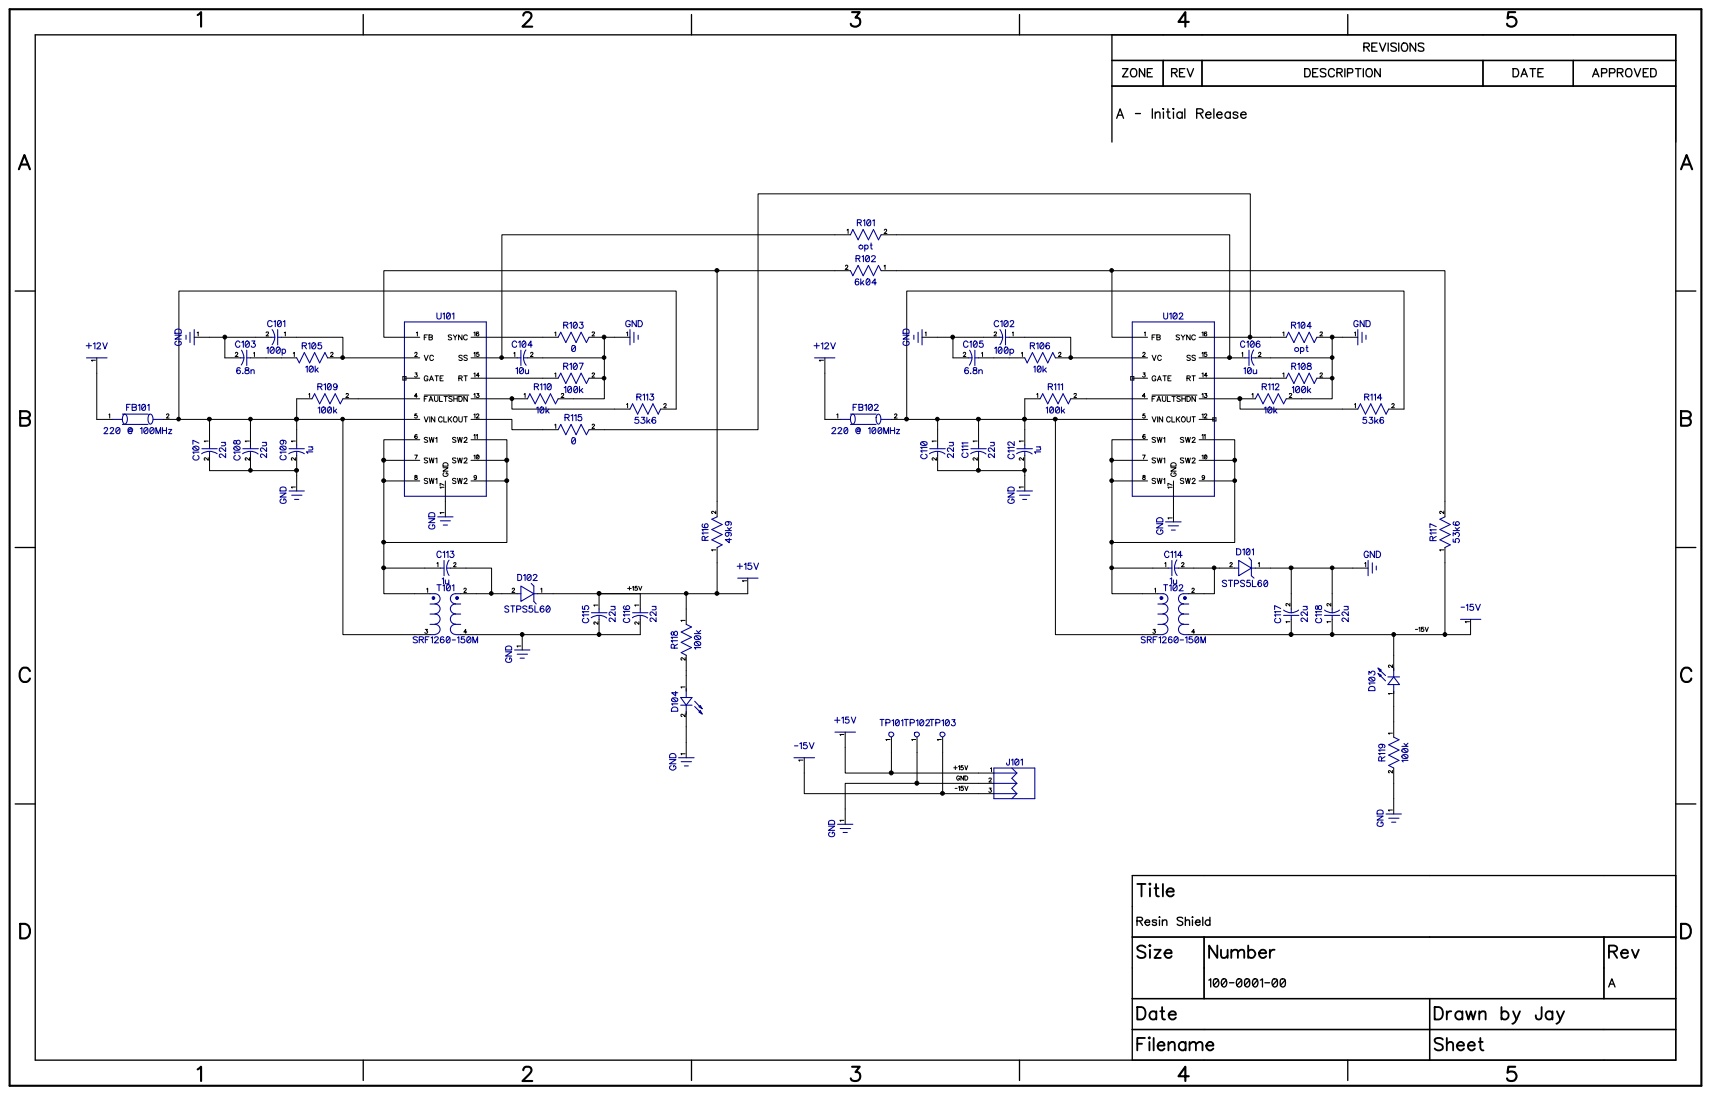
[picture p57: page 2]

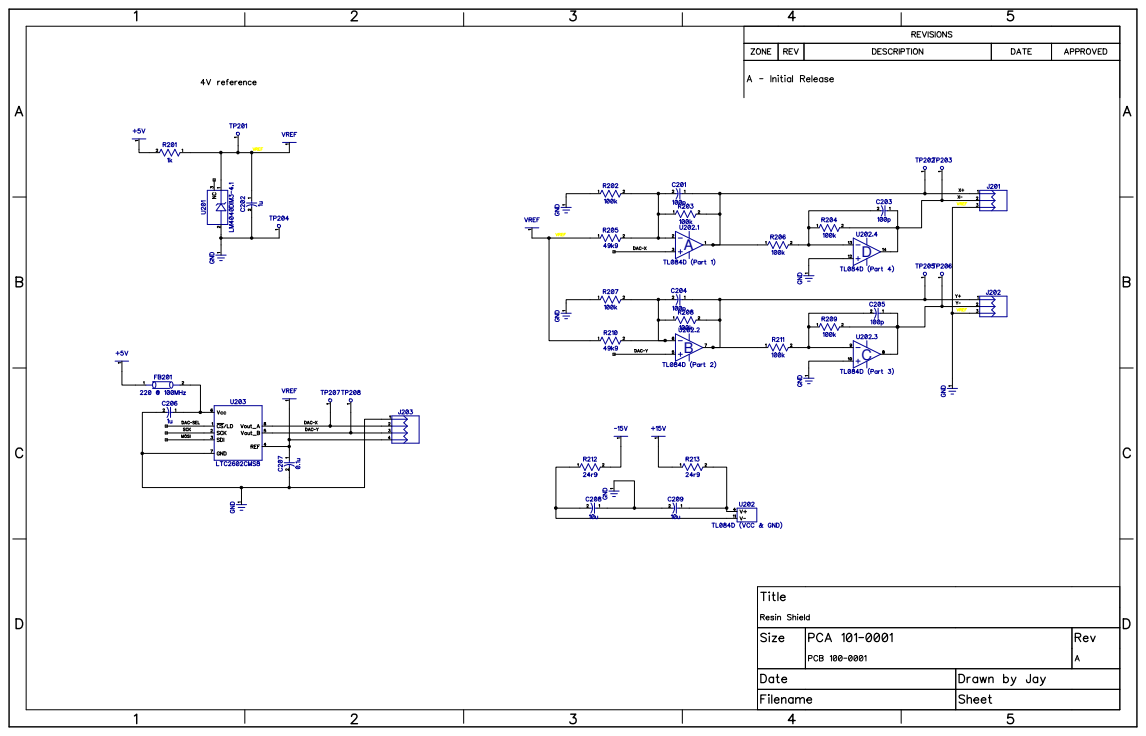
[picture p58: page 3]

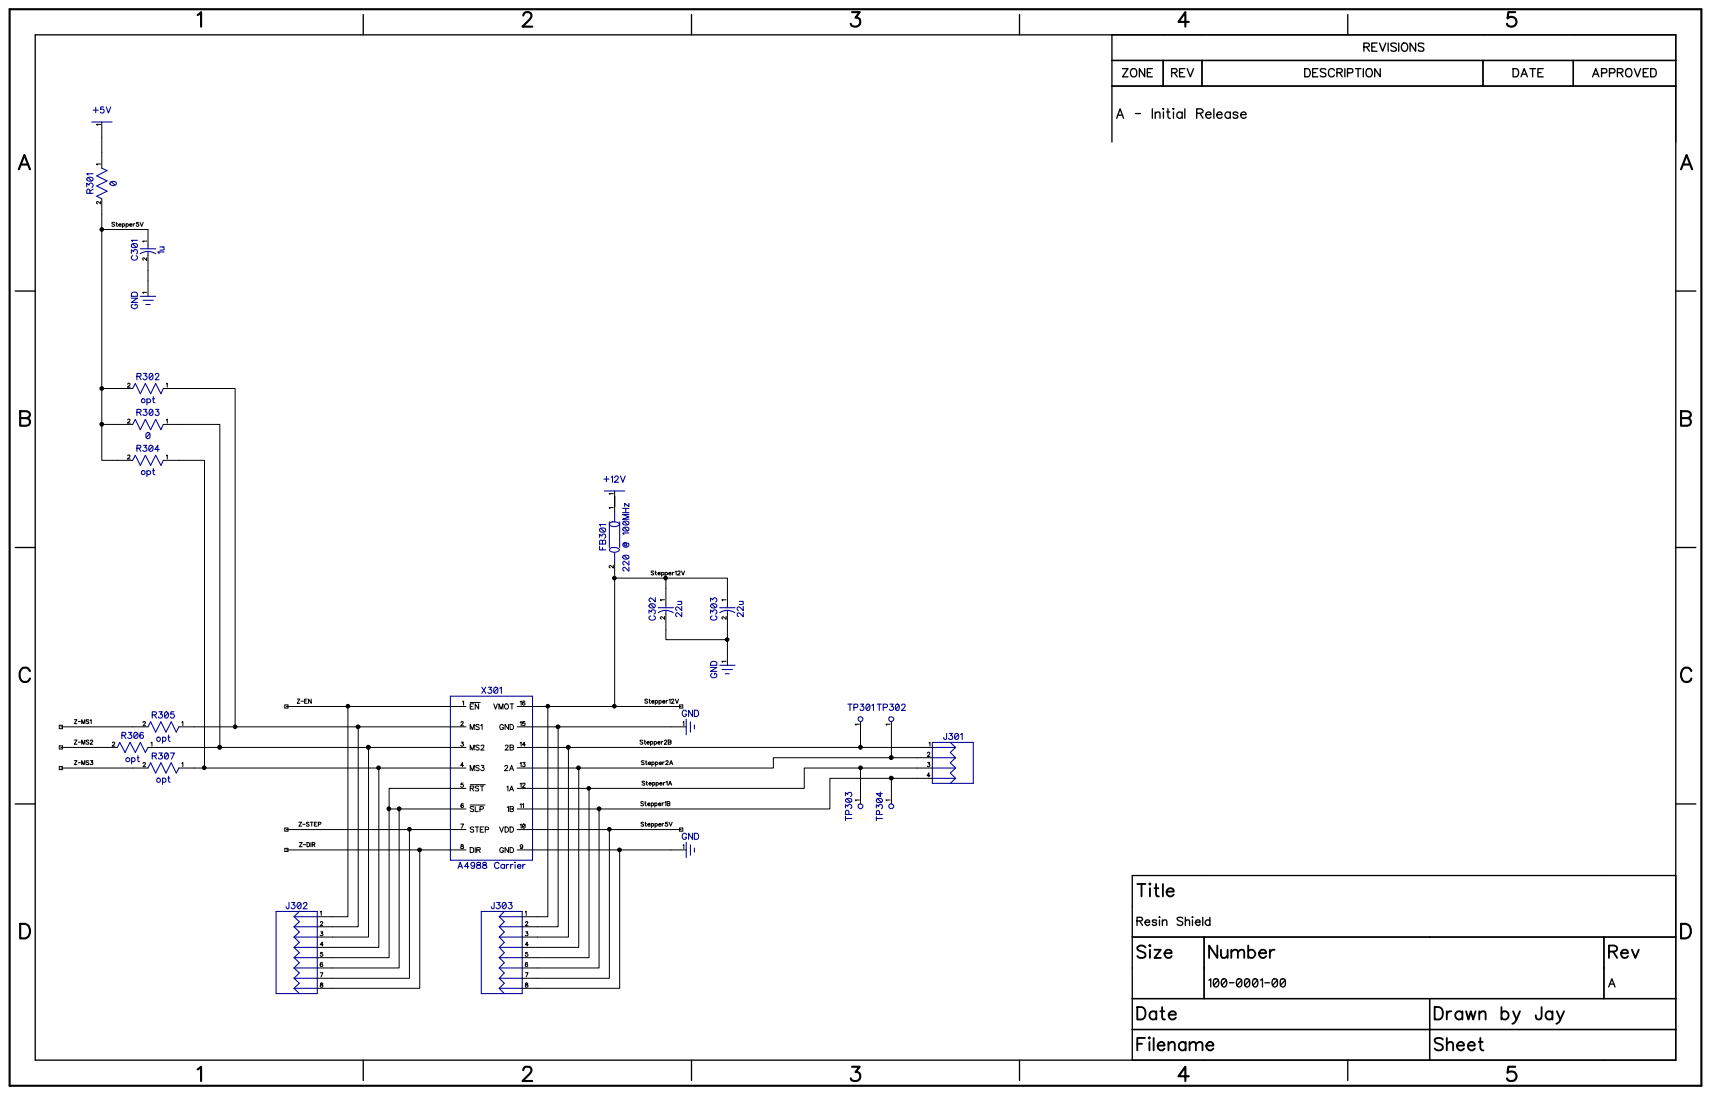
[picture p59: page 4]

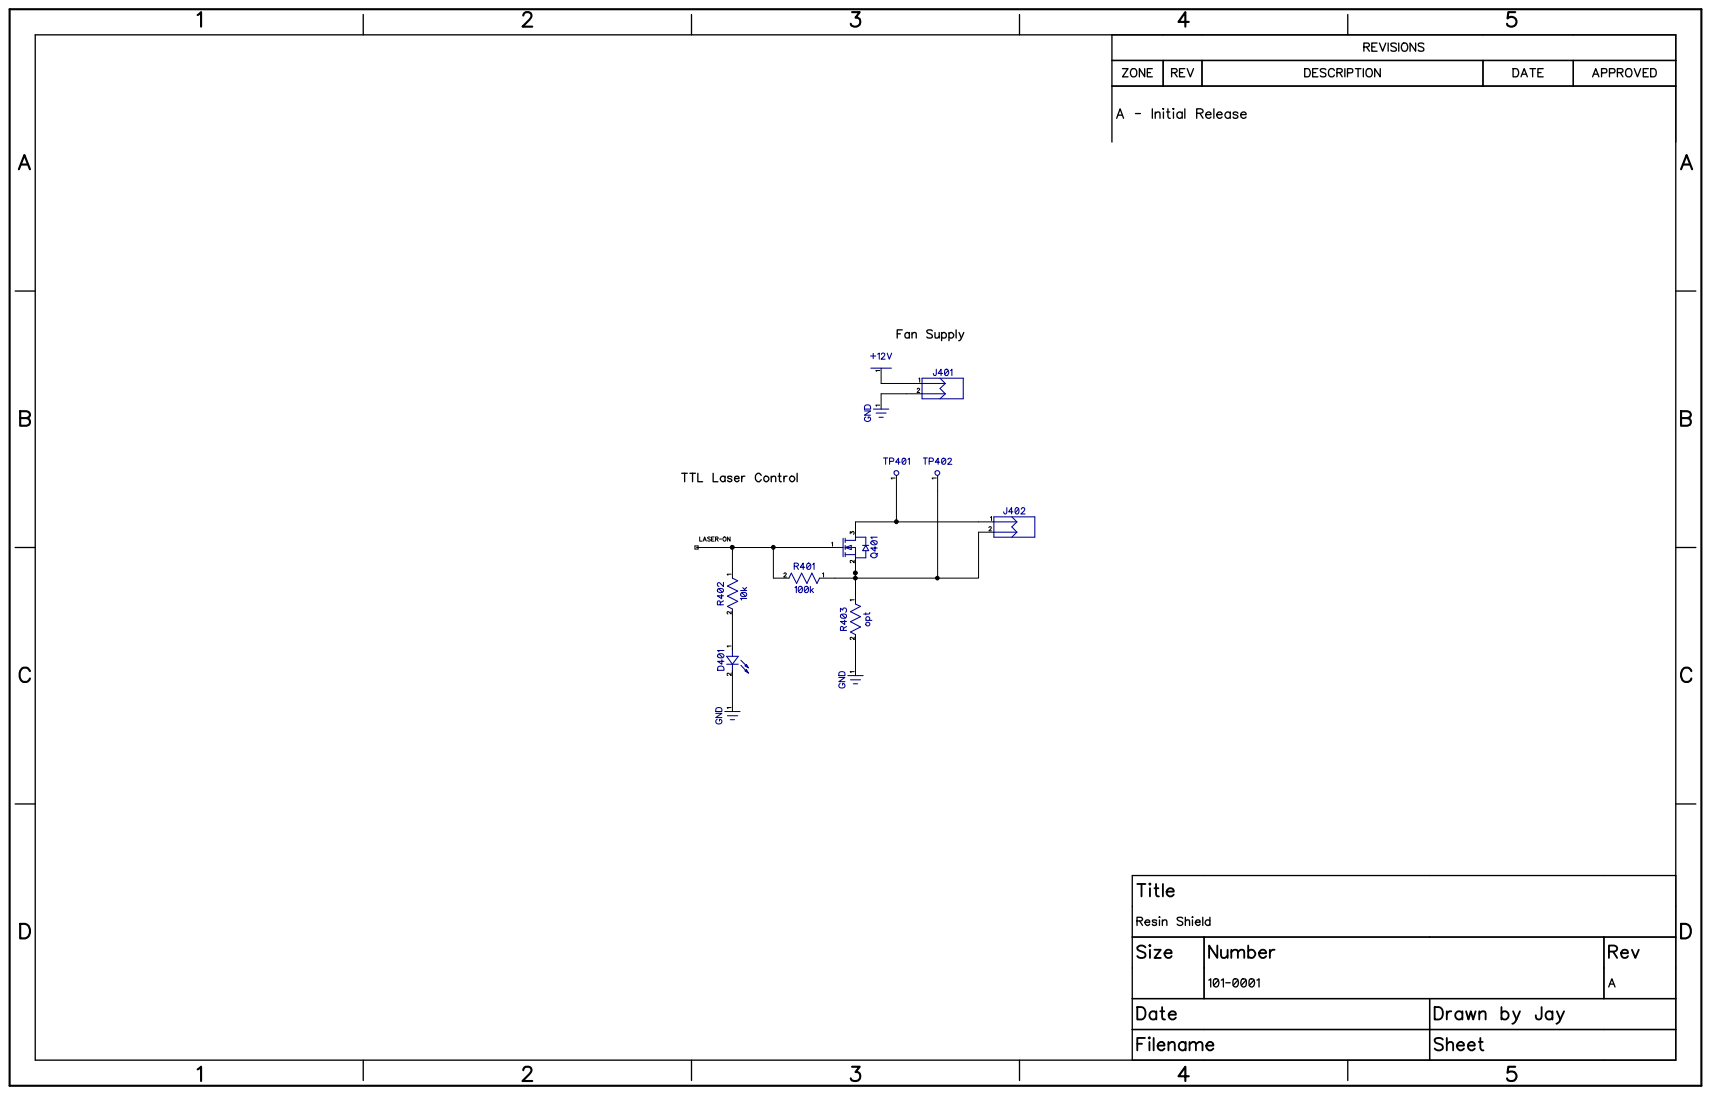
[picture p60: page 5]

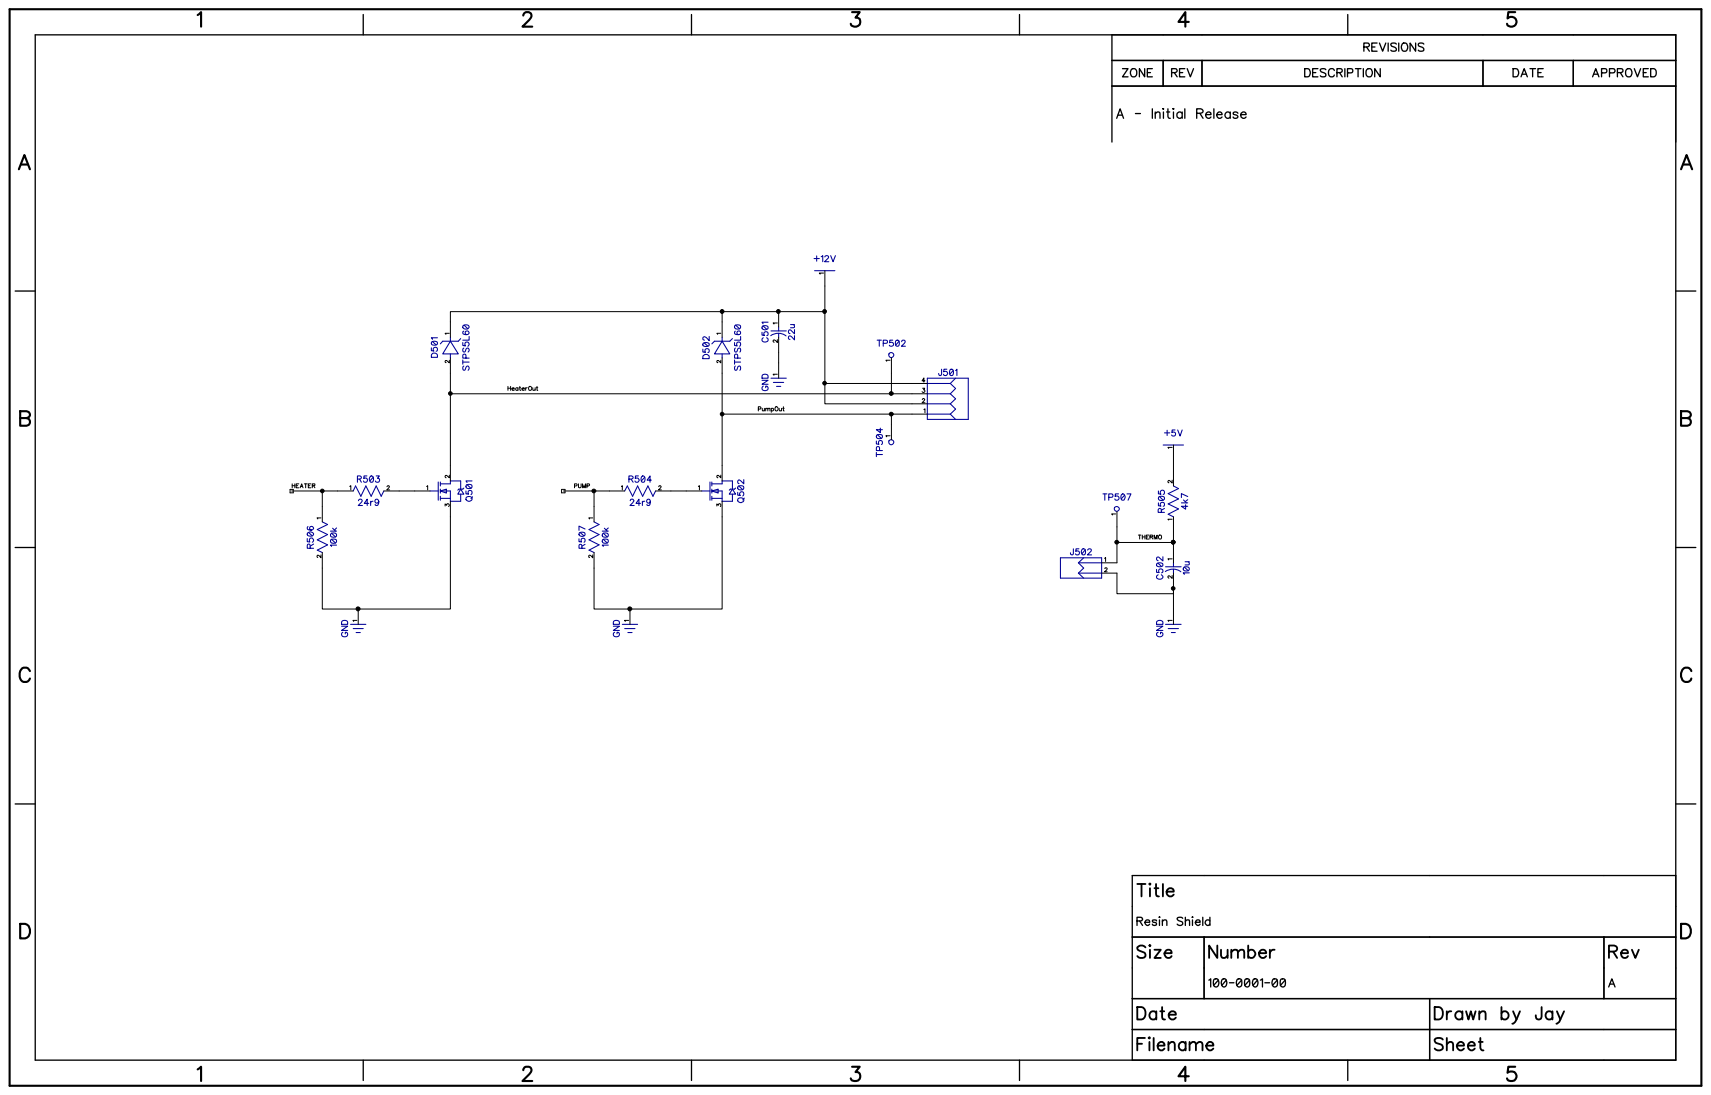
[picture p61: page 6]

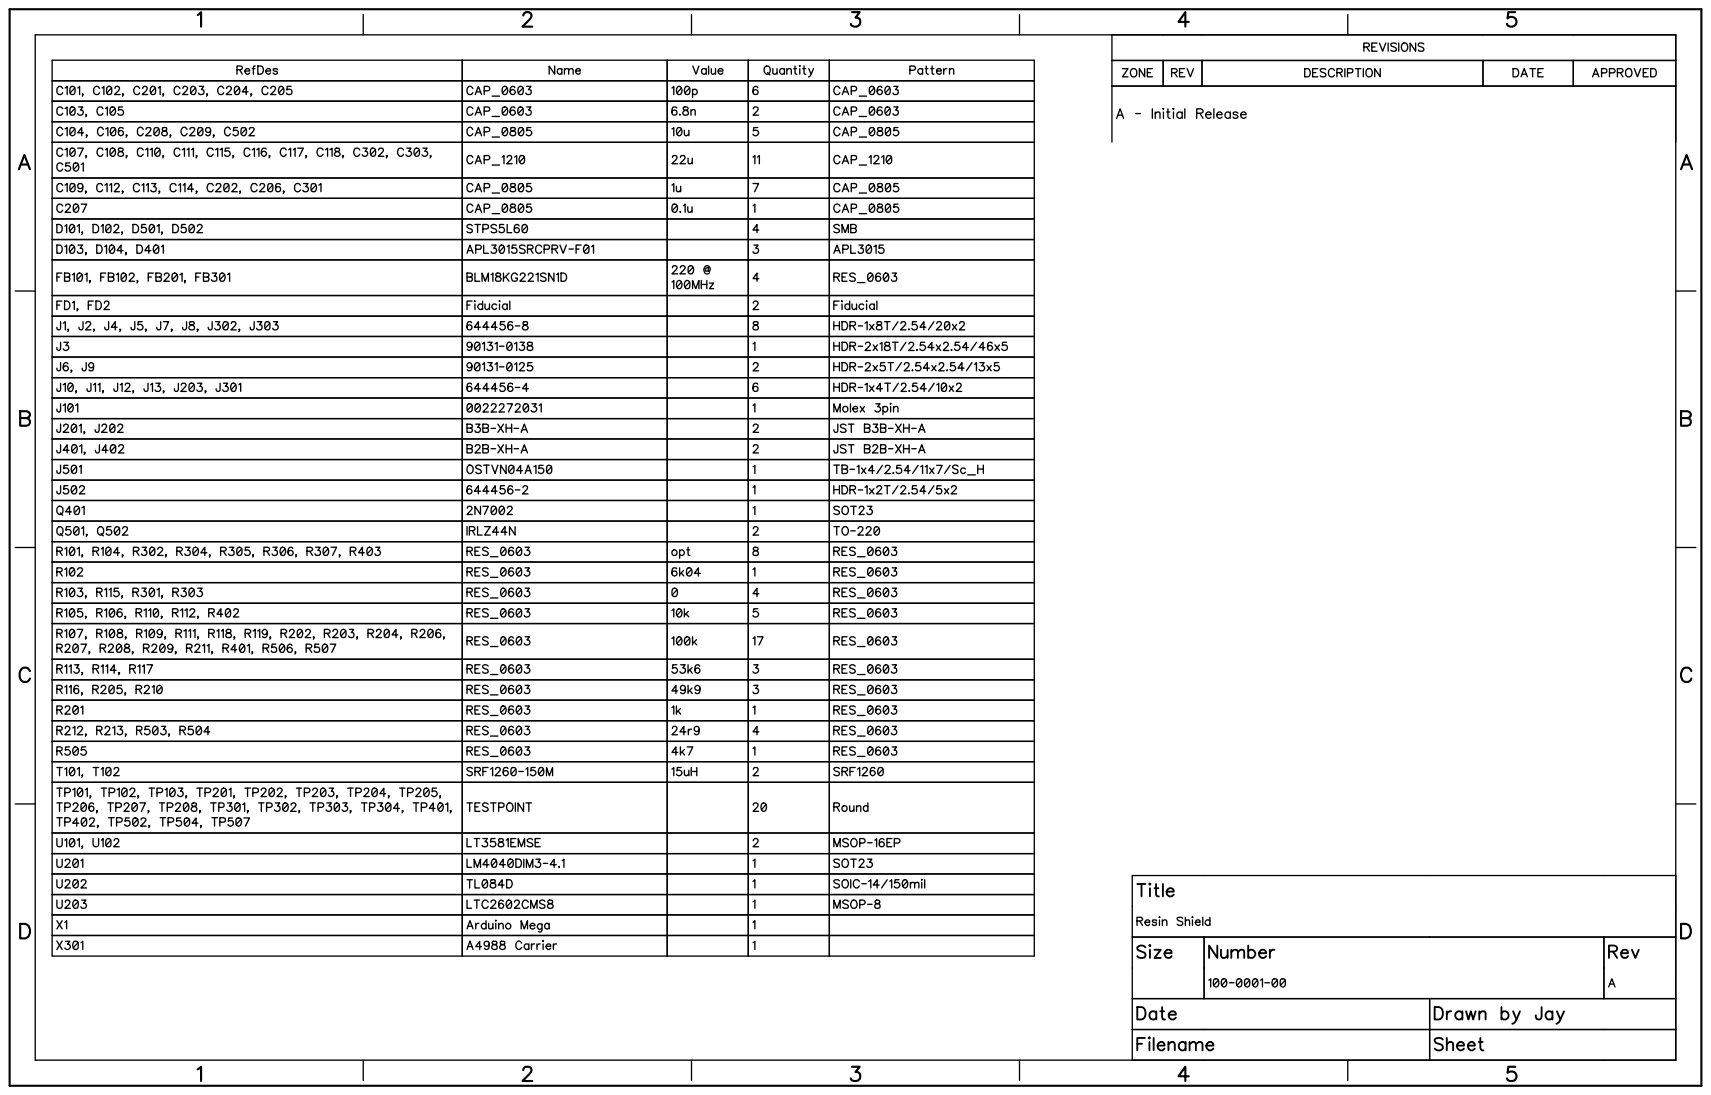
[picture p62: page 7]
