cruiser0002/ResinShield/RevB/DipTrace Schematic - resinshield.pdf

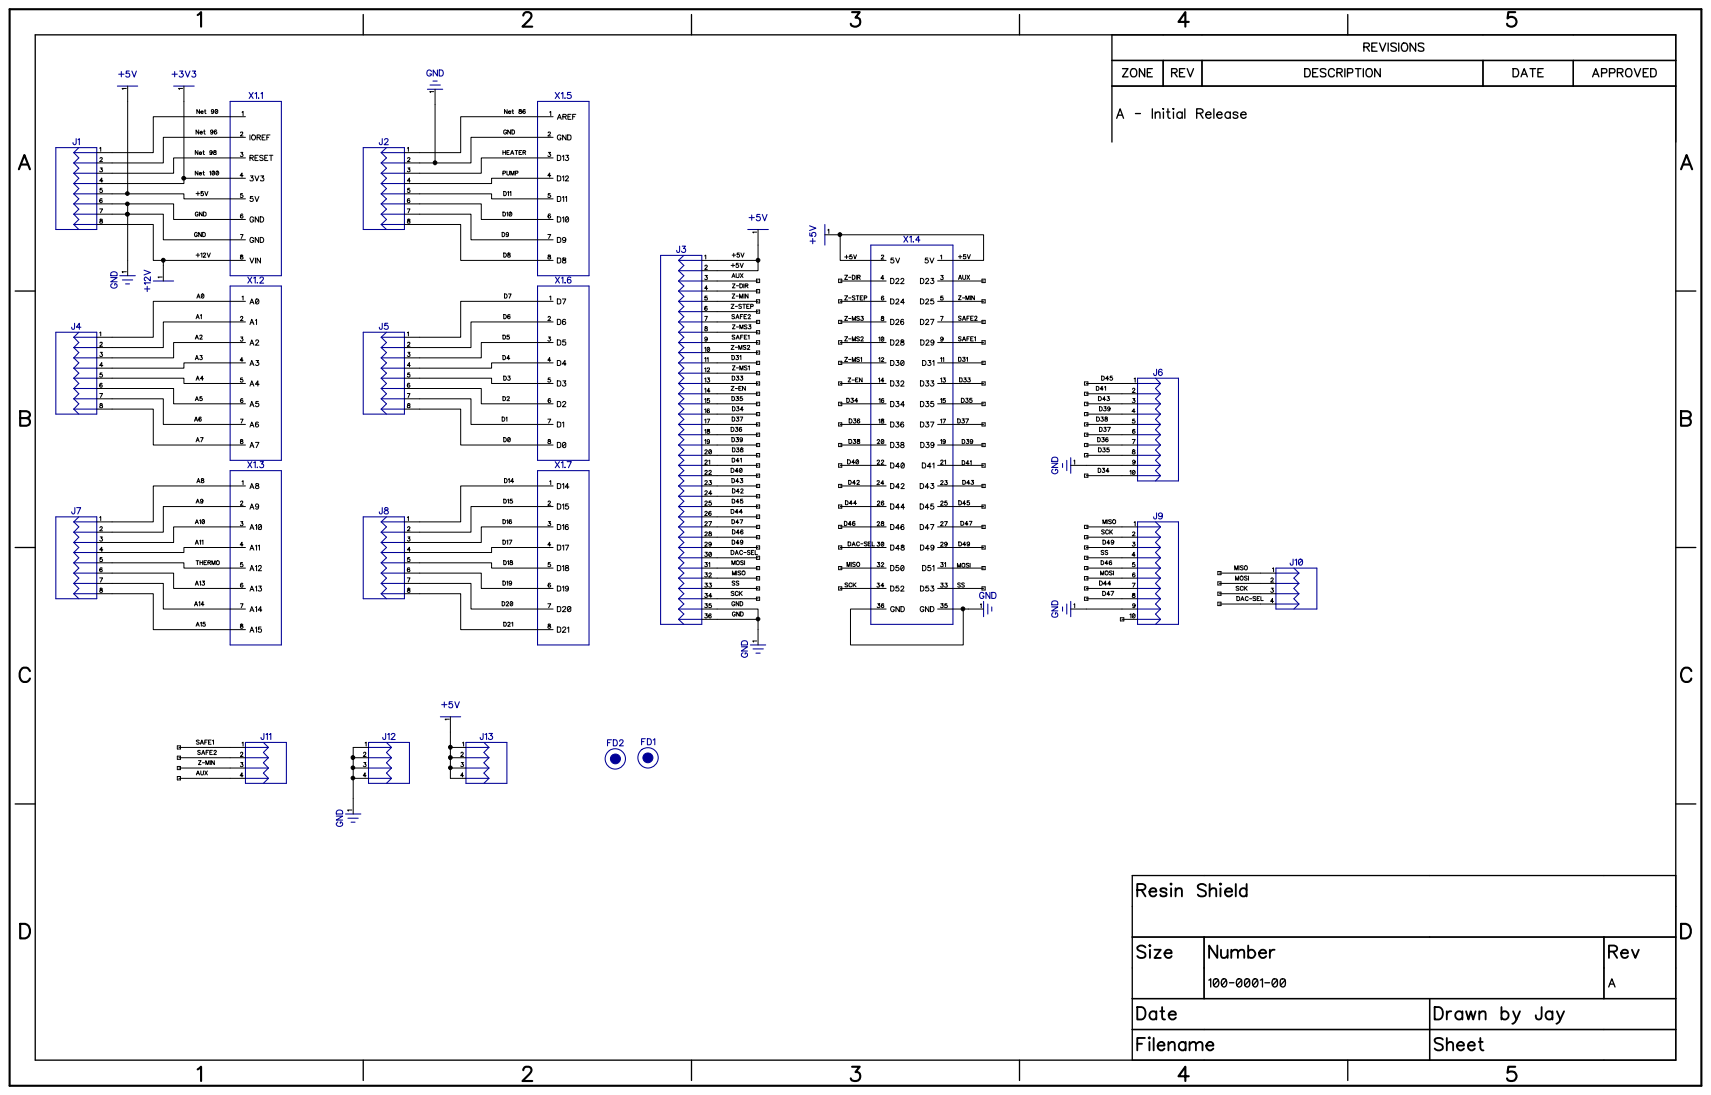
[picture p63: page 1]

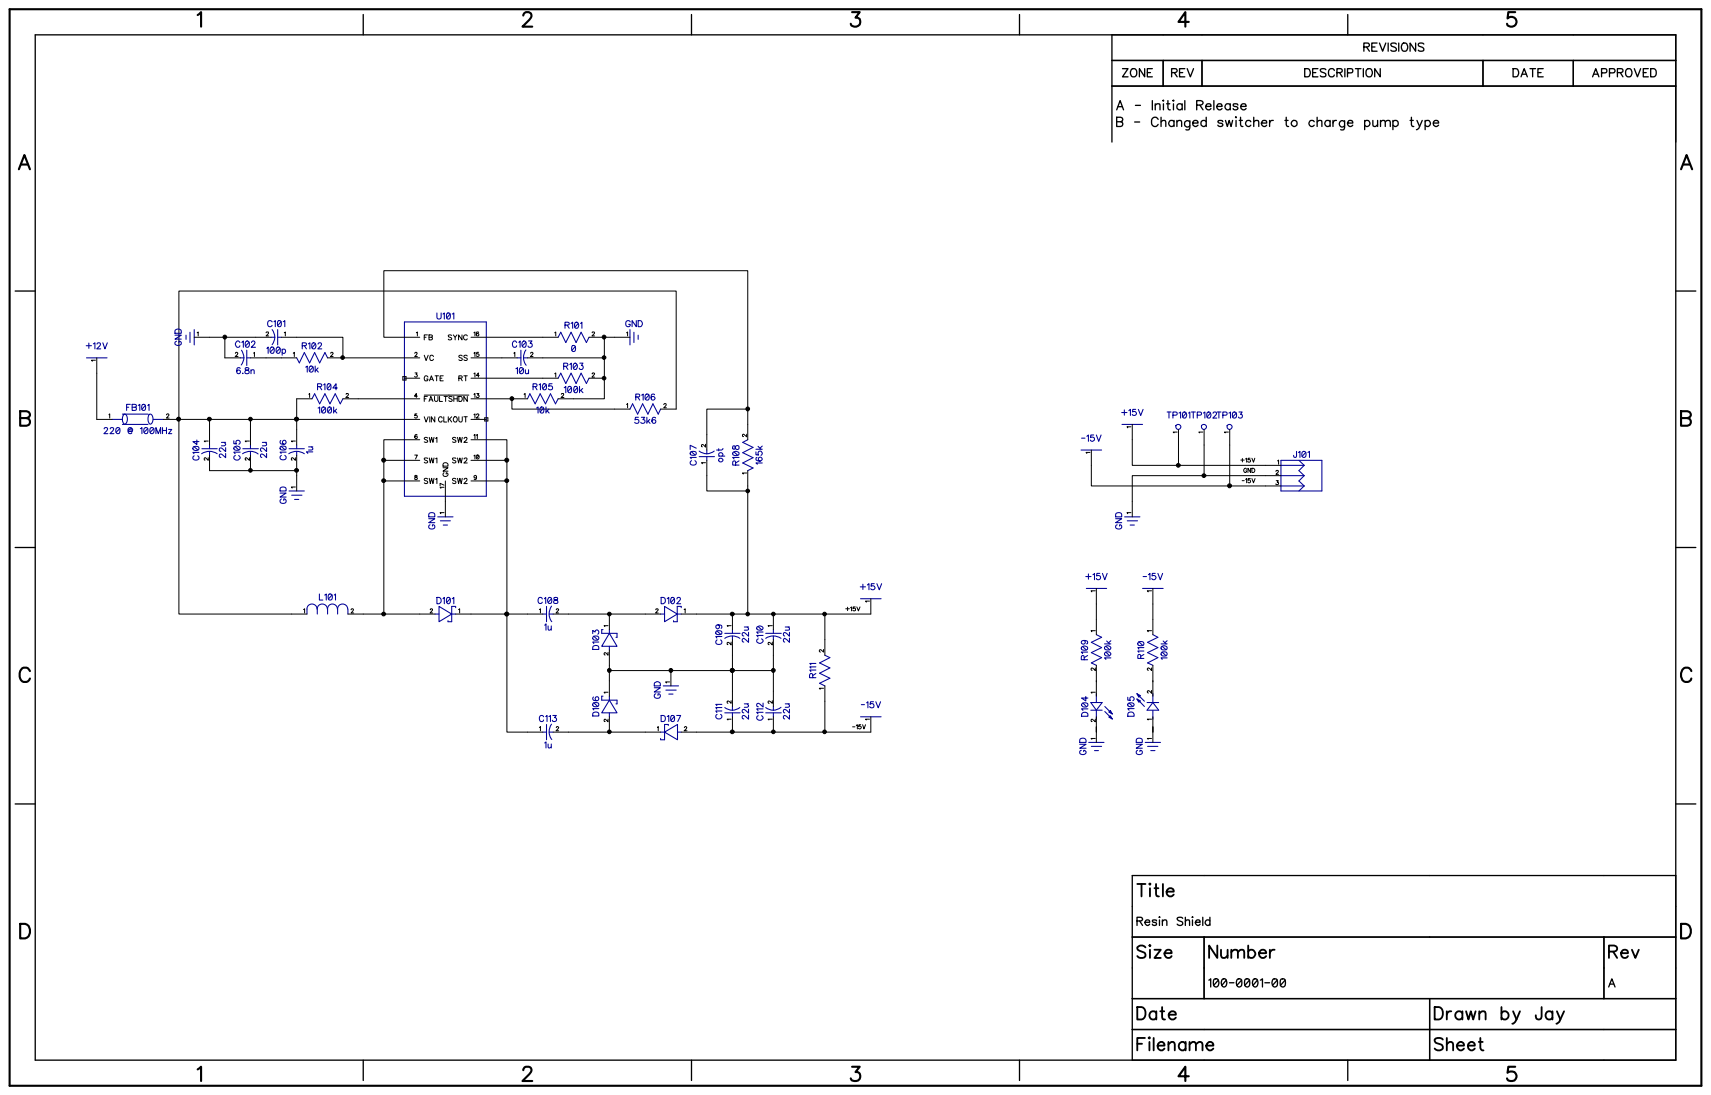
[picture p64: page 2]


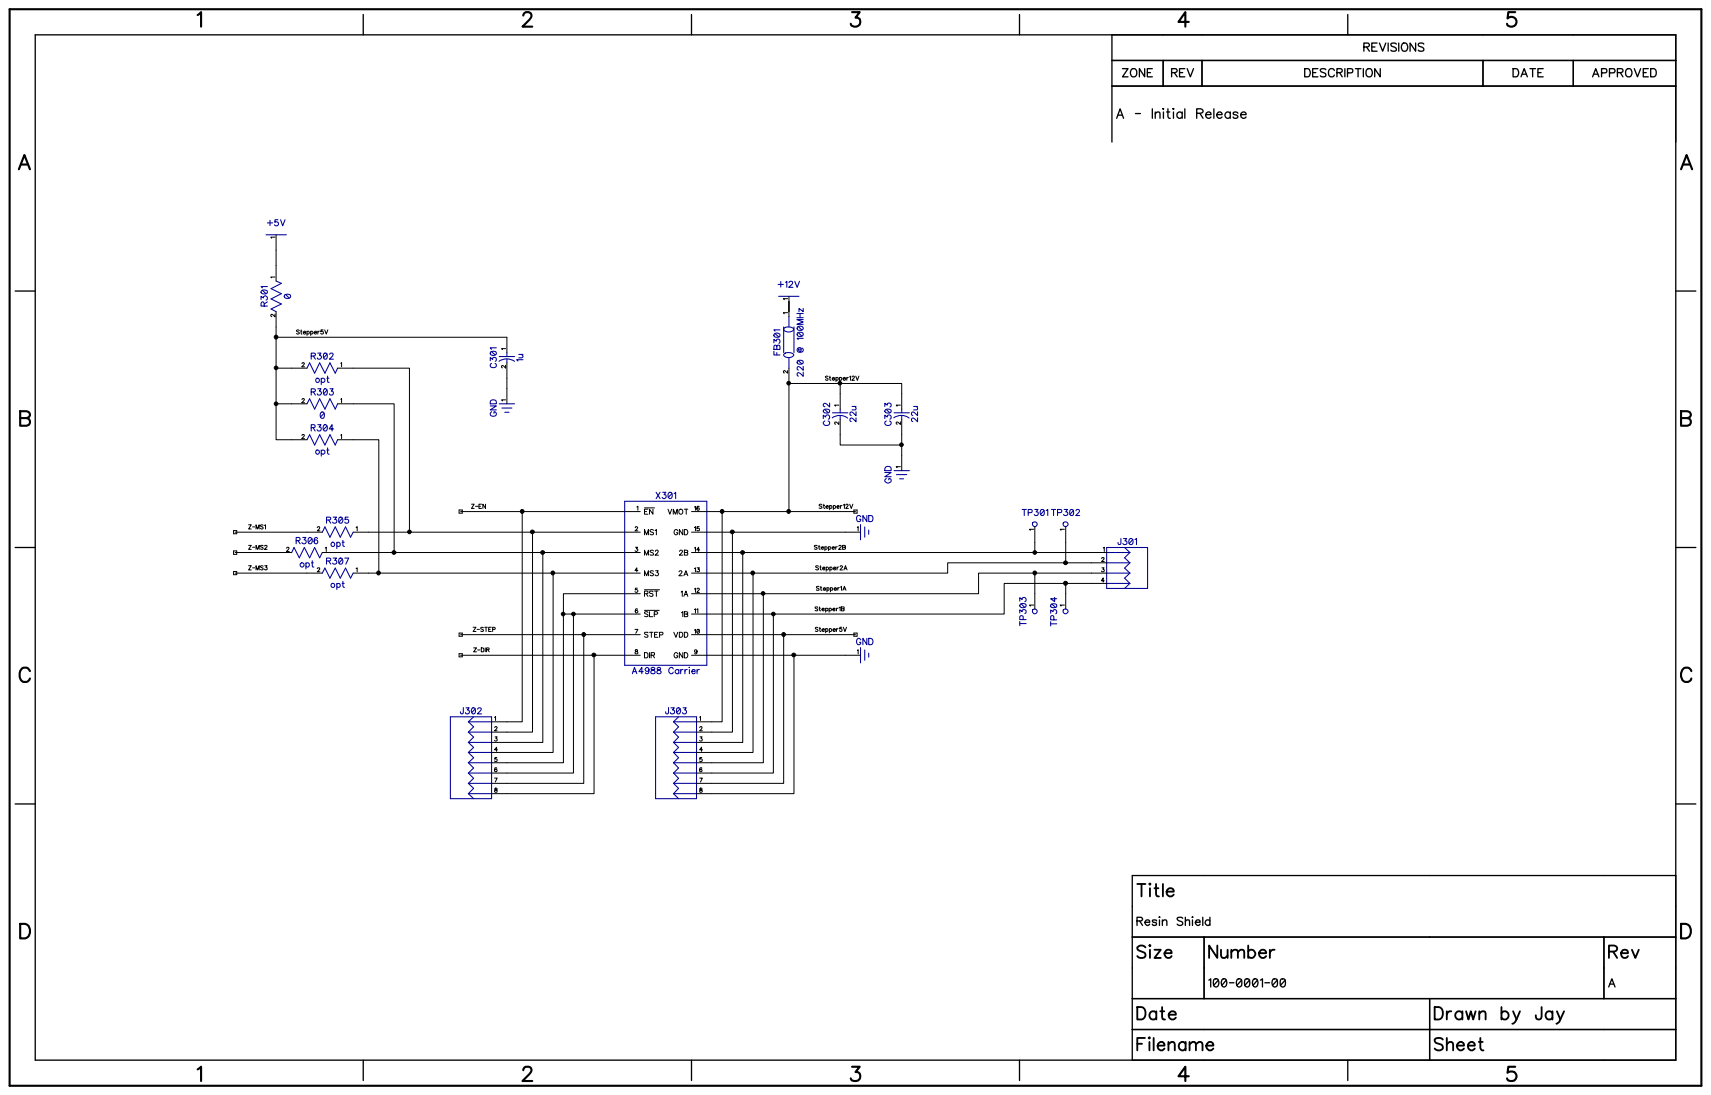
[picture p65: page 4]


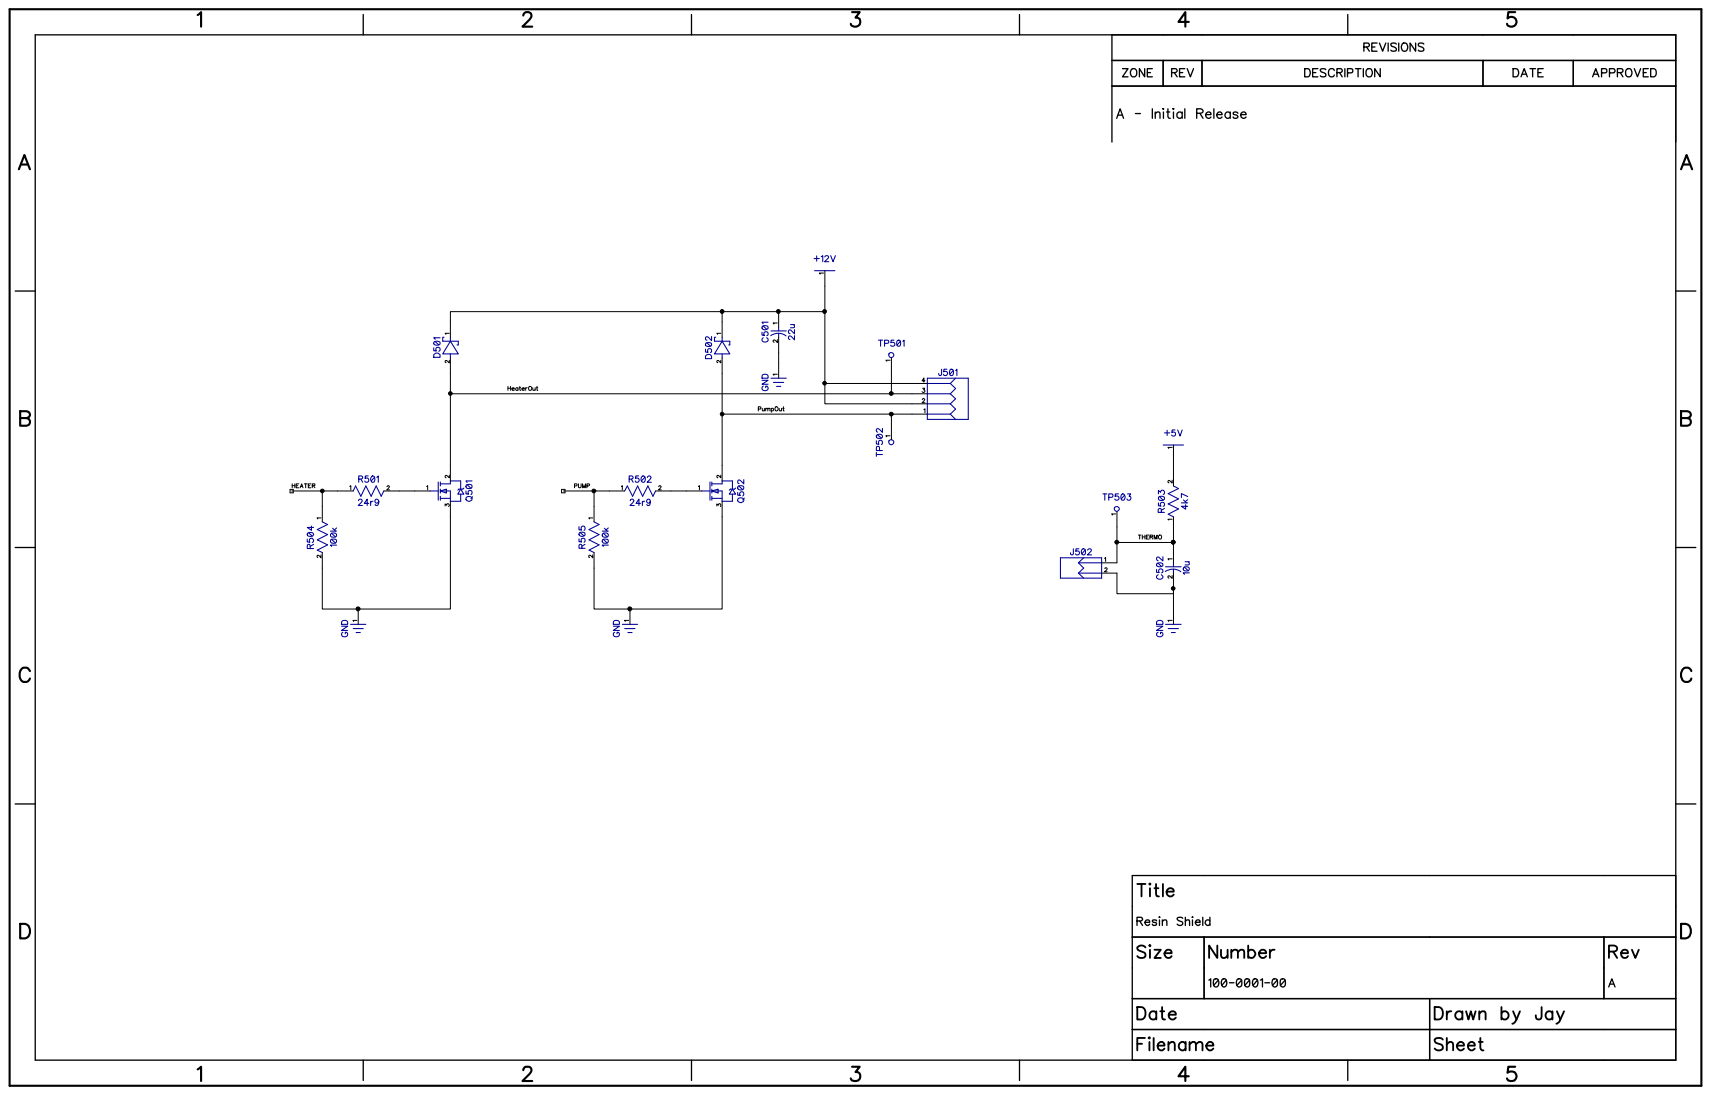
[picture p66: page 6]

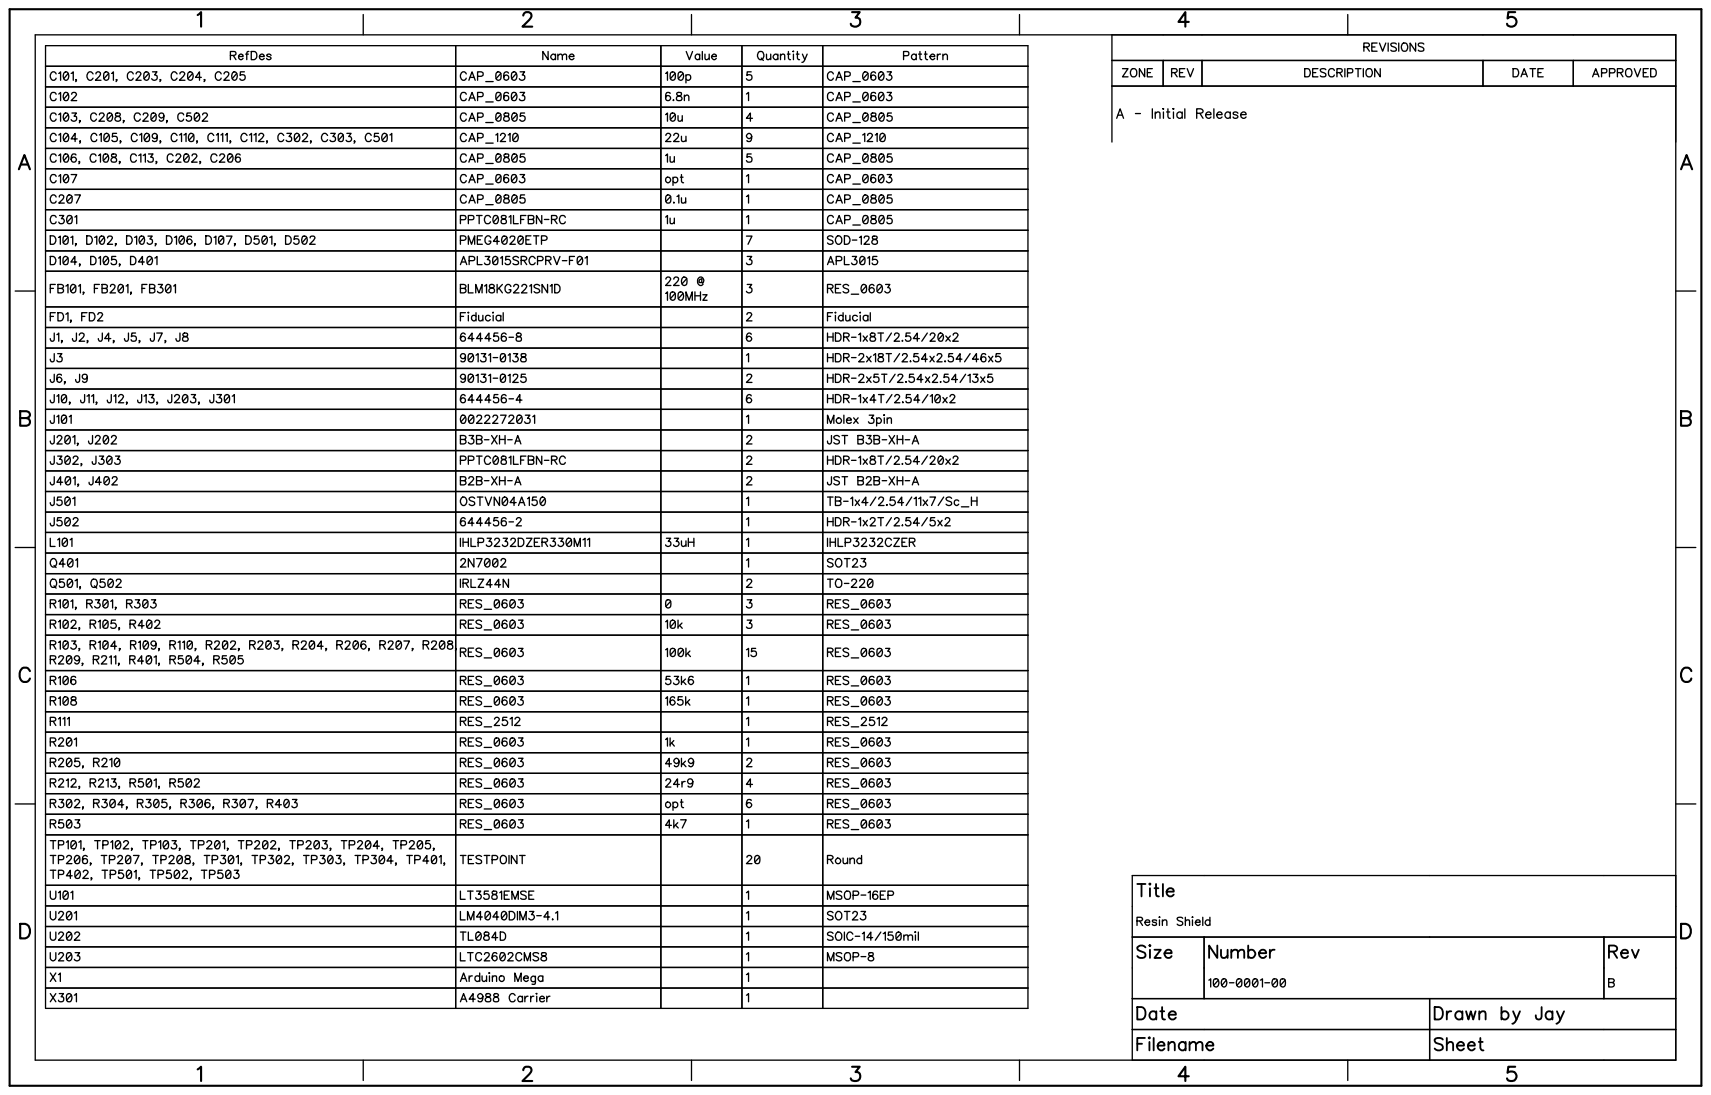
[picture p67: page 7]
