cruiser0002/ResinShield/RevC/DipTrace Schematic - resinshield.pdf

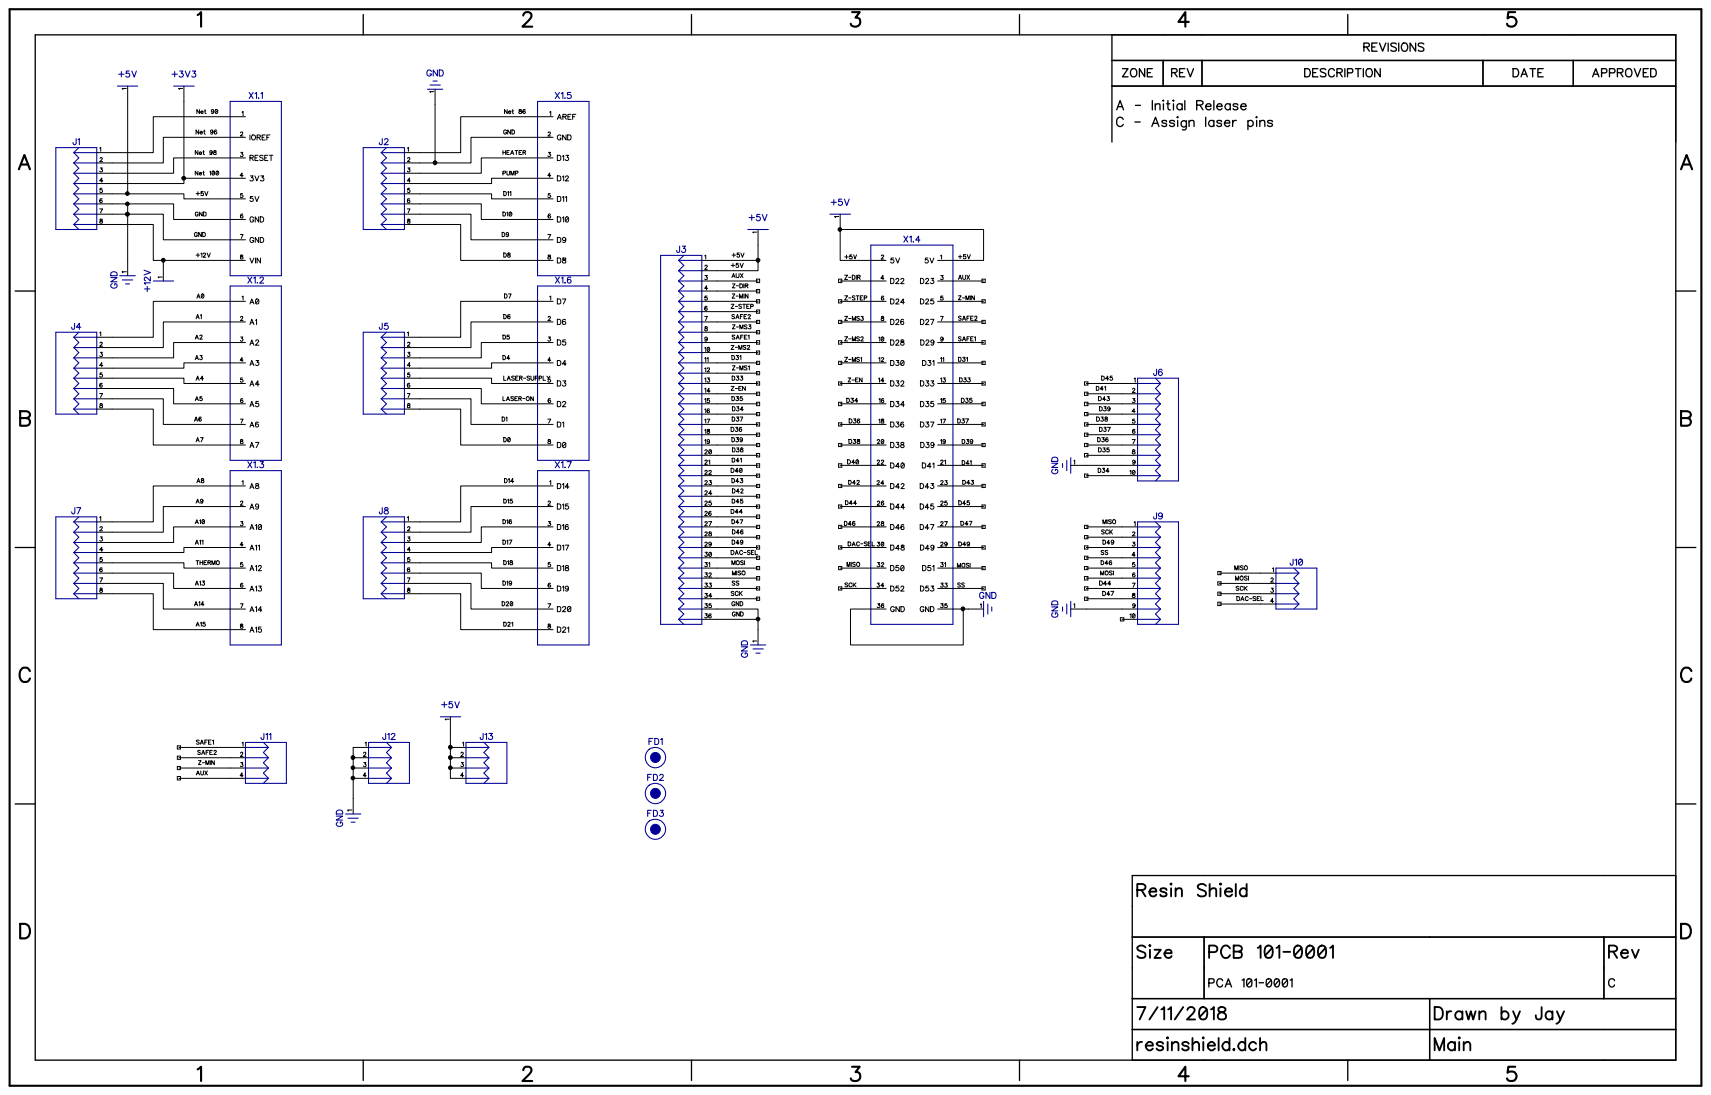
[picture p68: page 1]

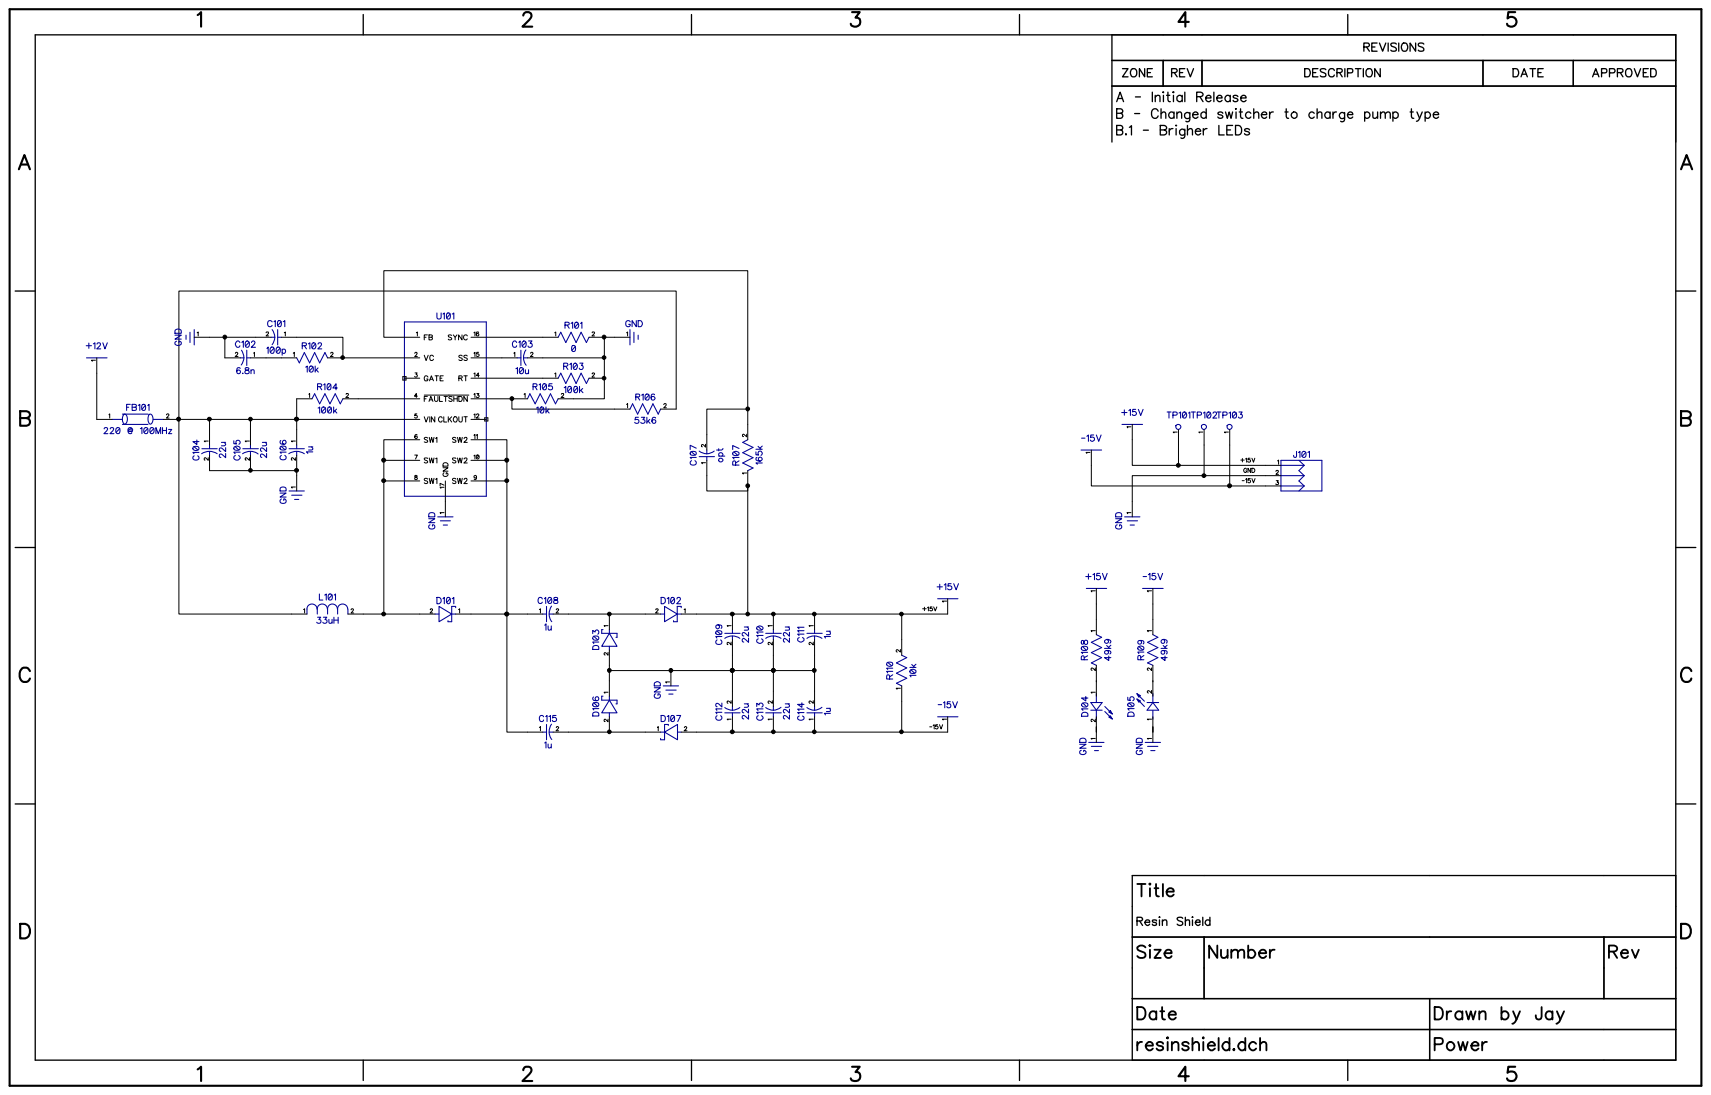
[picture p69: page 2]

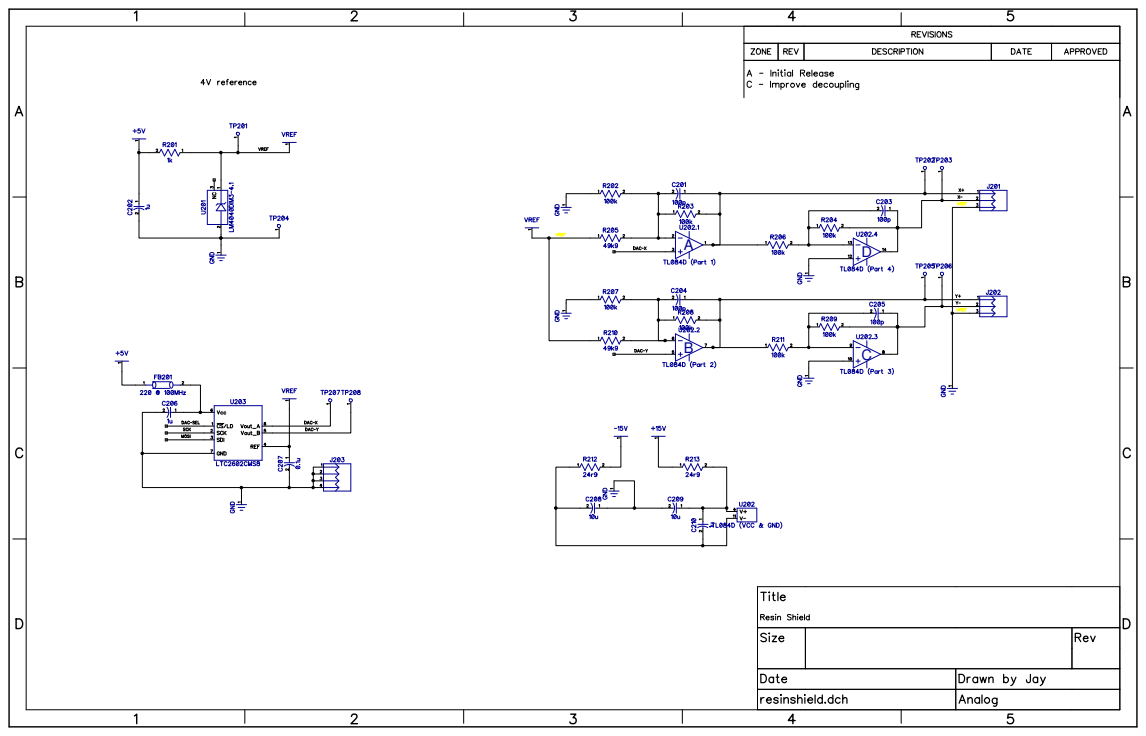
[picture p70: page 3]


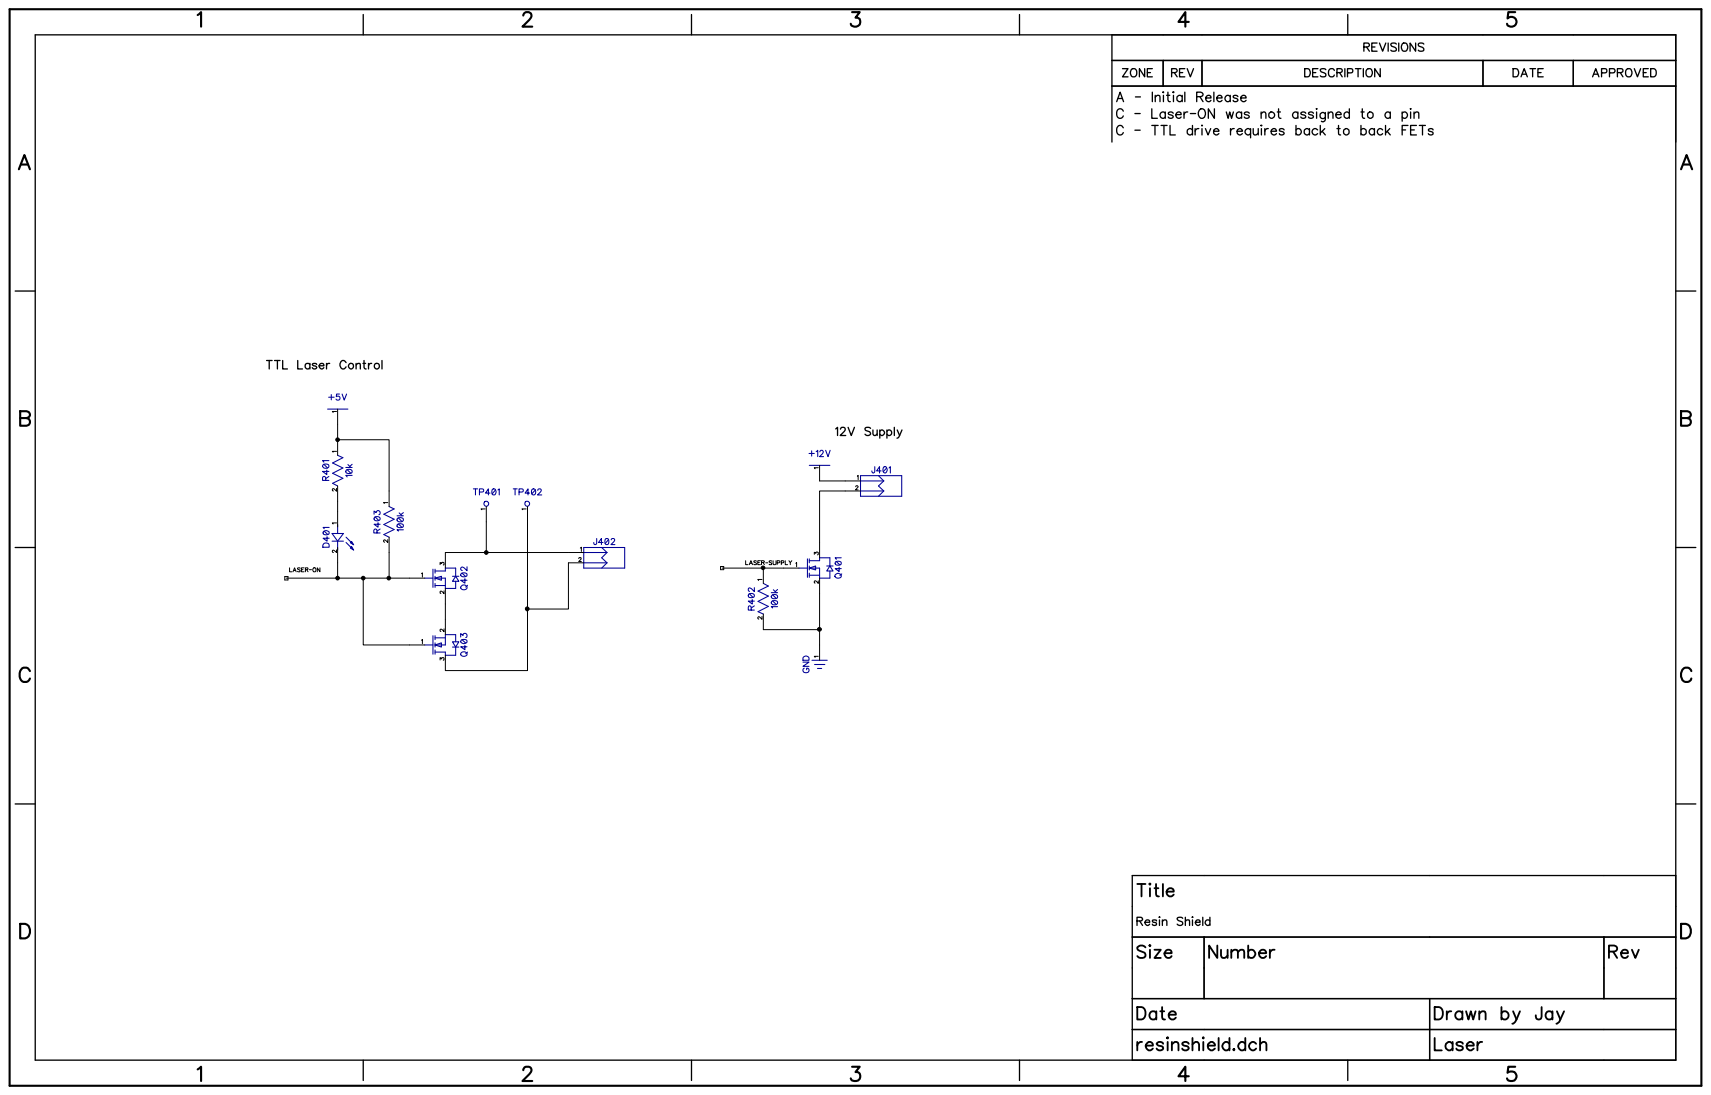
[picture p71: page 5]


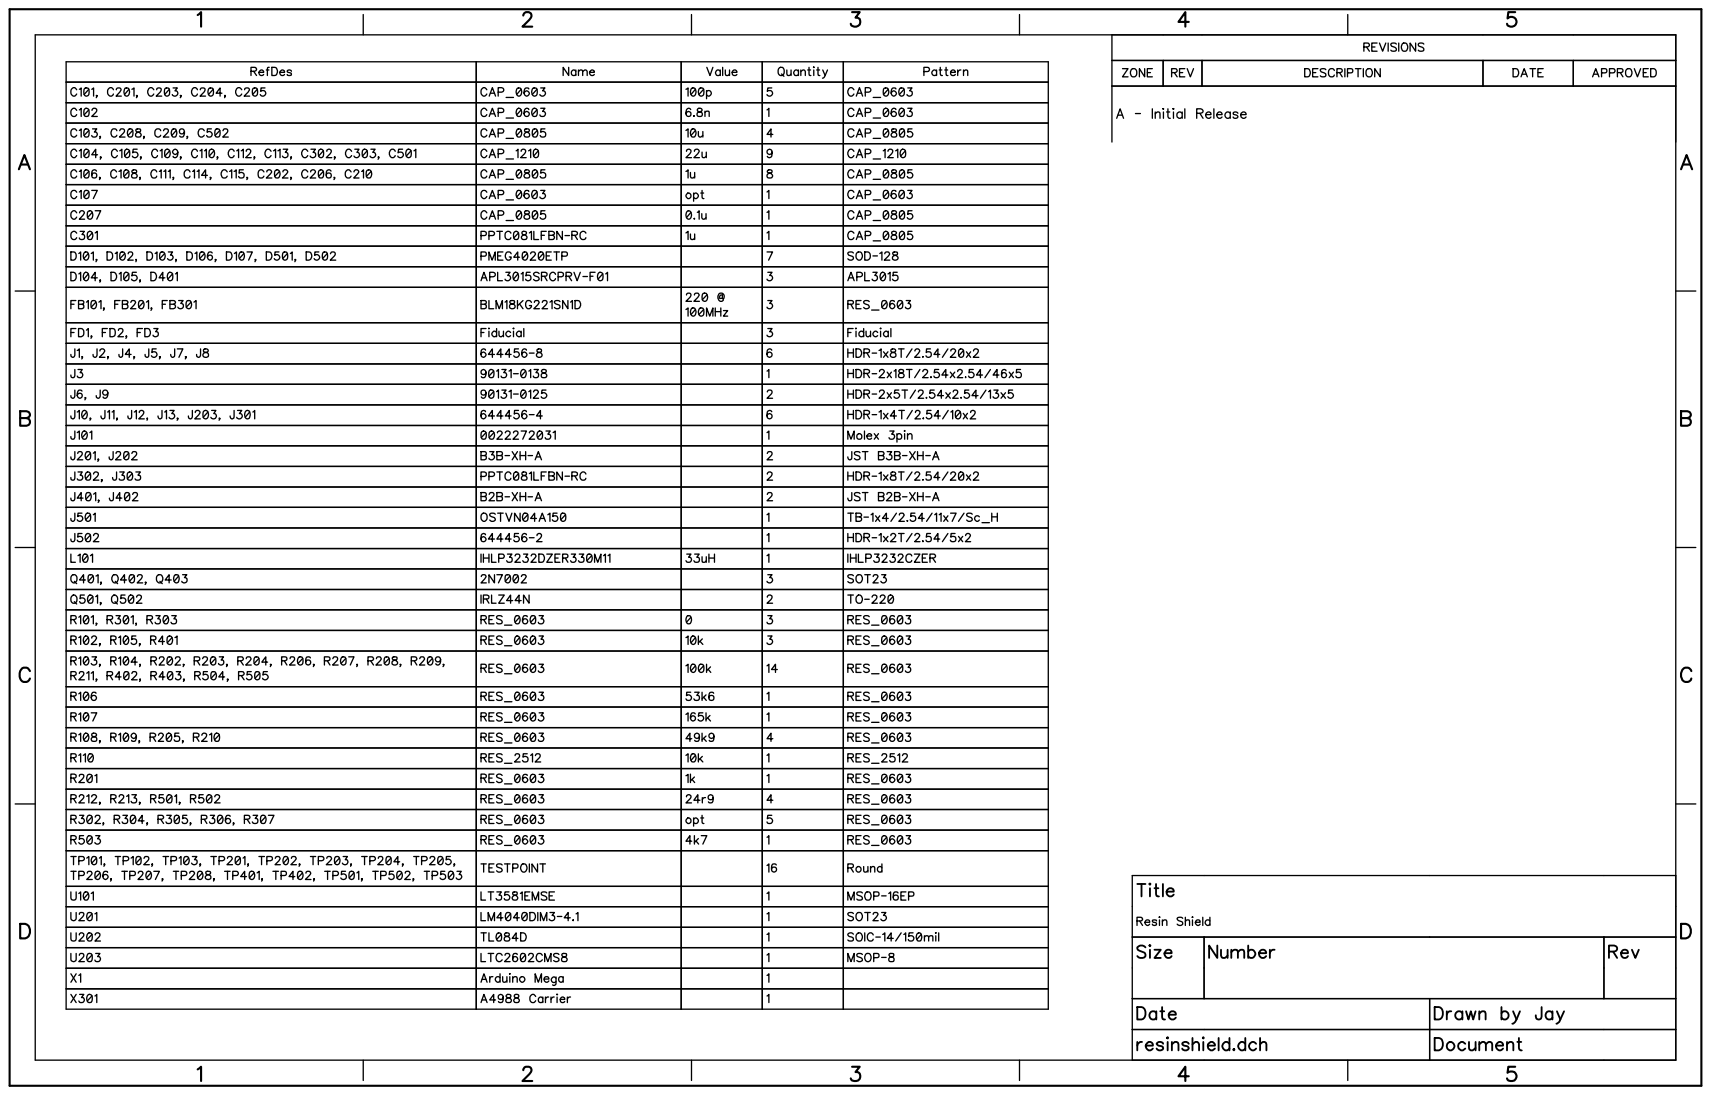
[picture p72: page 7]
