cruiser0002/ResinShield/RevE/DipTrace PCB - resinshield bot.pdf

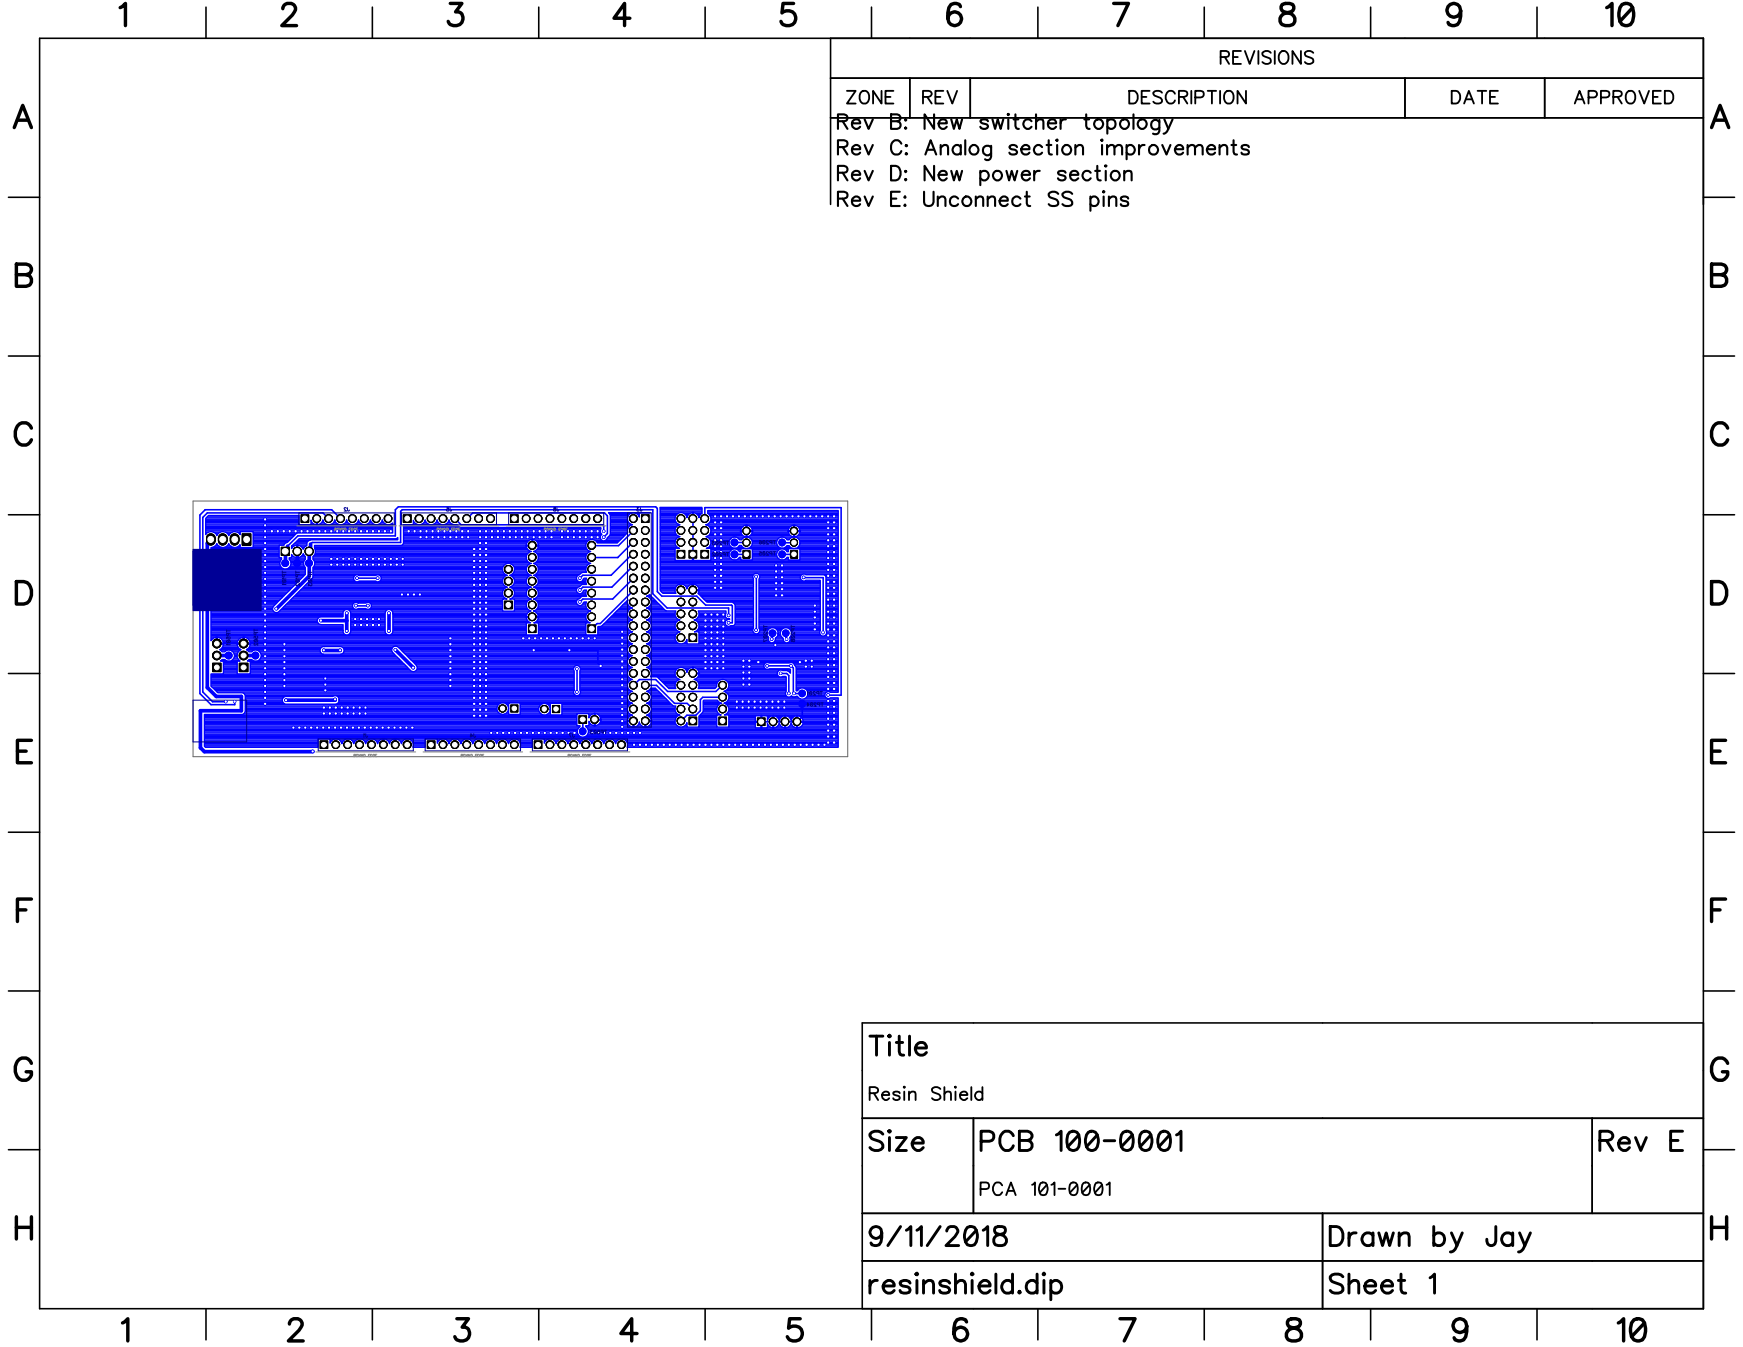
[picture p73: page 1]
