cruiser0002/ResinShield/RevE/DipTrace PCB - resinshield top.pdf

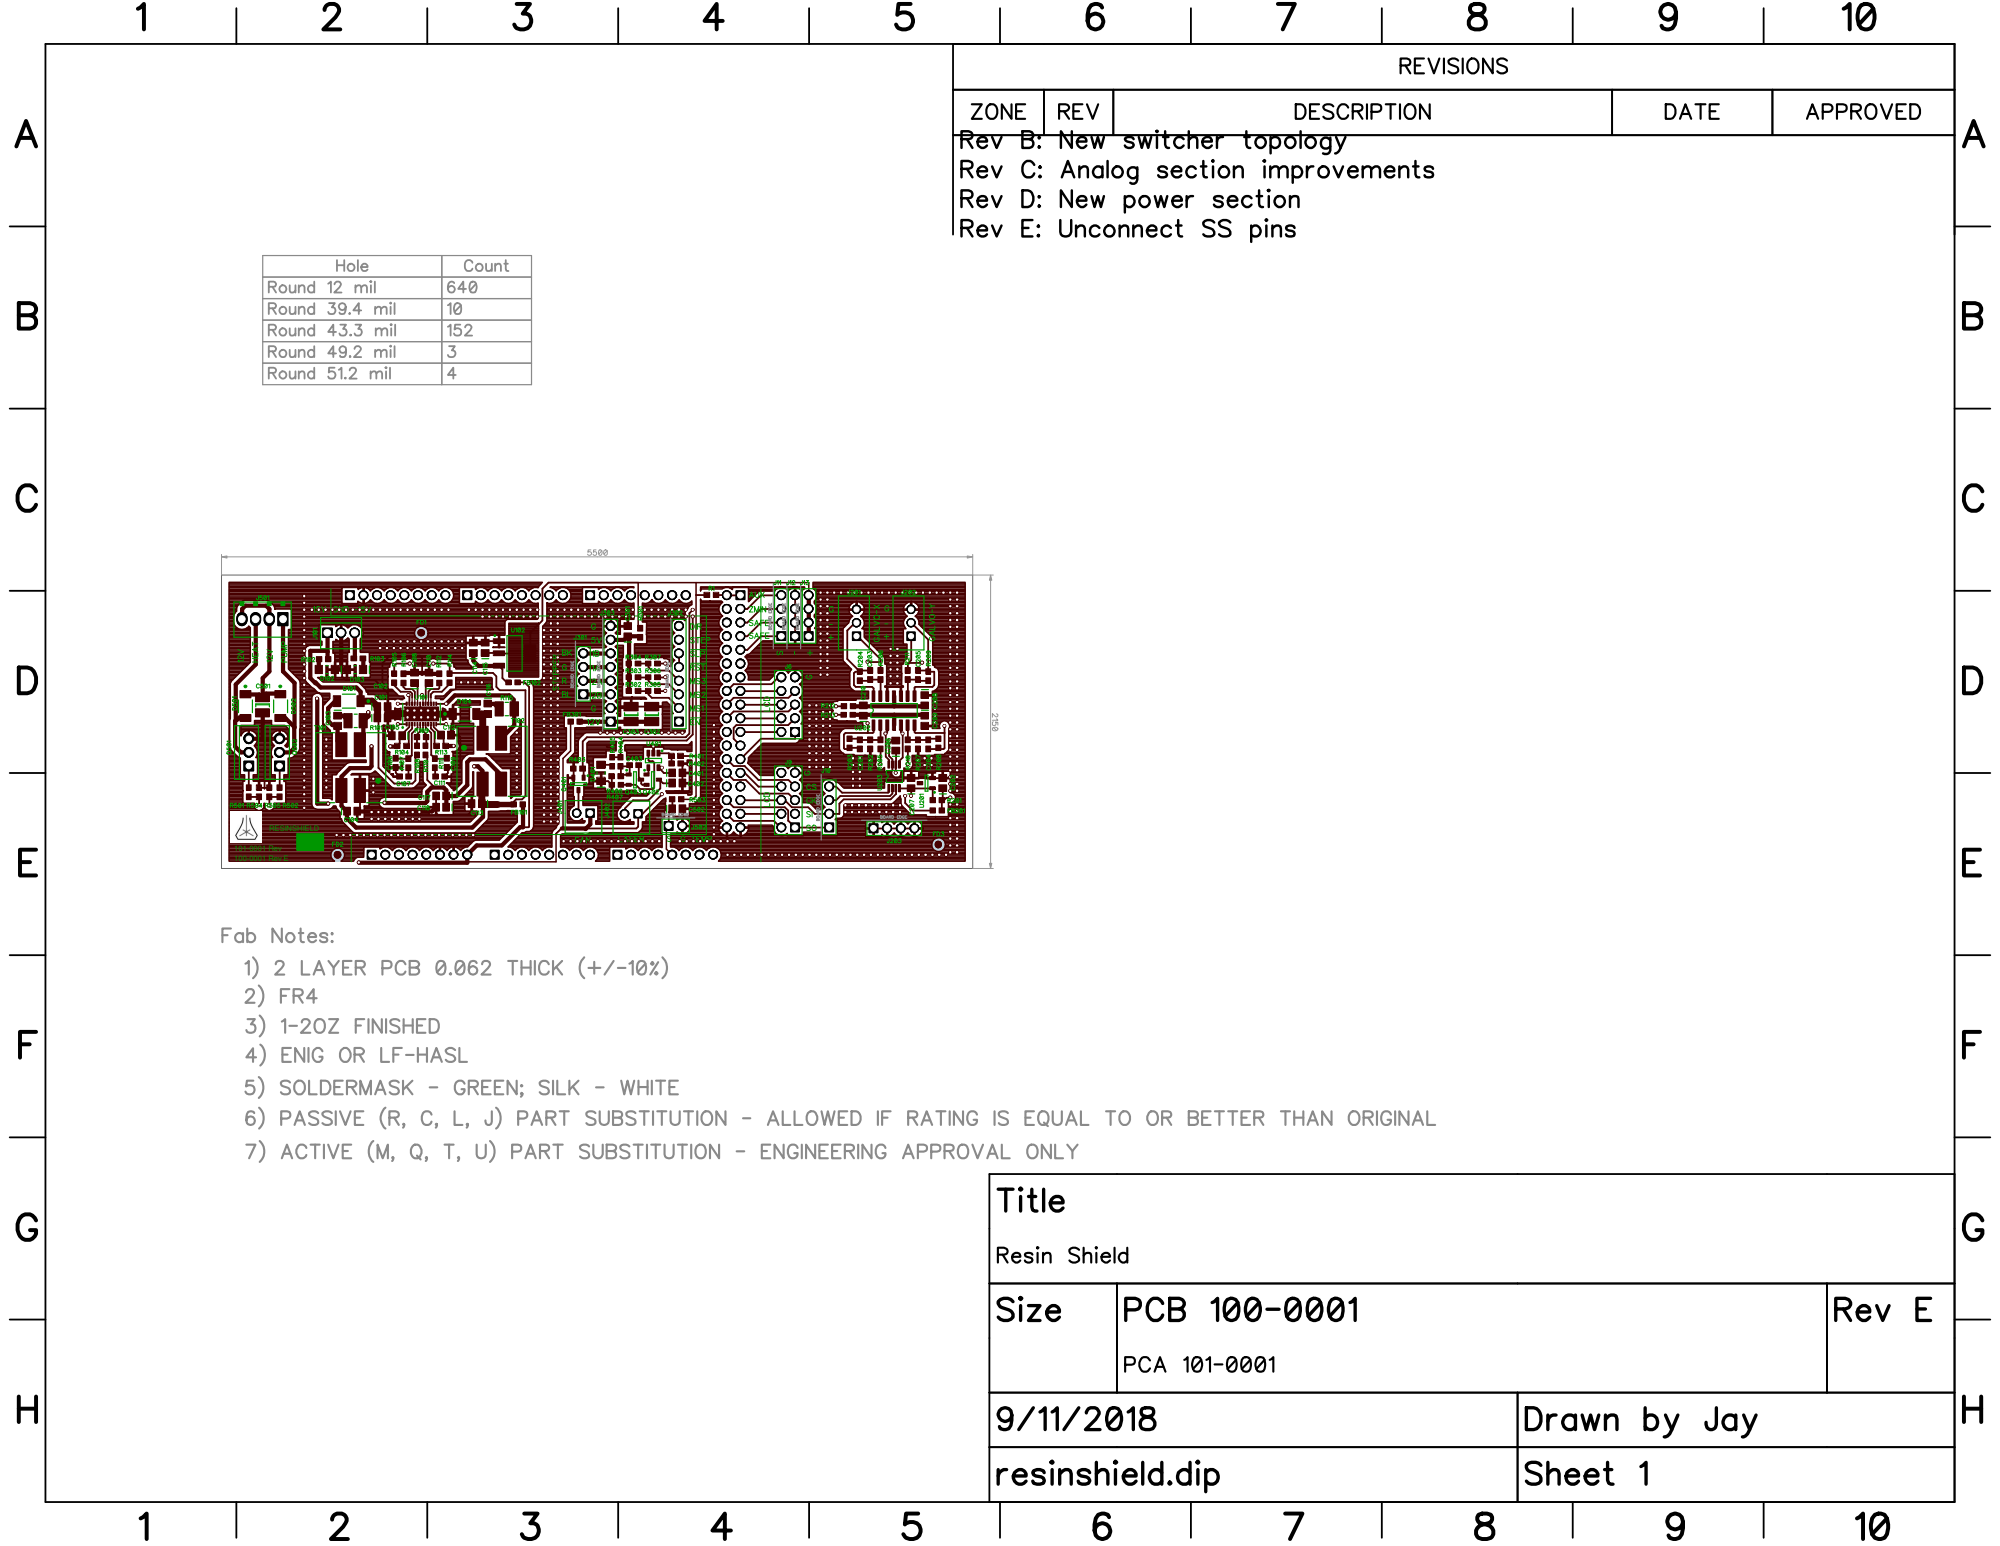
[picture p74: page 1]
100-0001 Rev E; 101-0001 Rev; RESINSHIELD
