cruiser0002/ResinShield/RevD/DipTrace PCB - resinshield bot.pdf

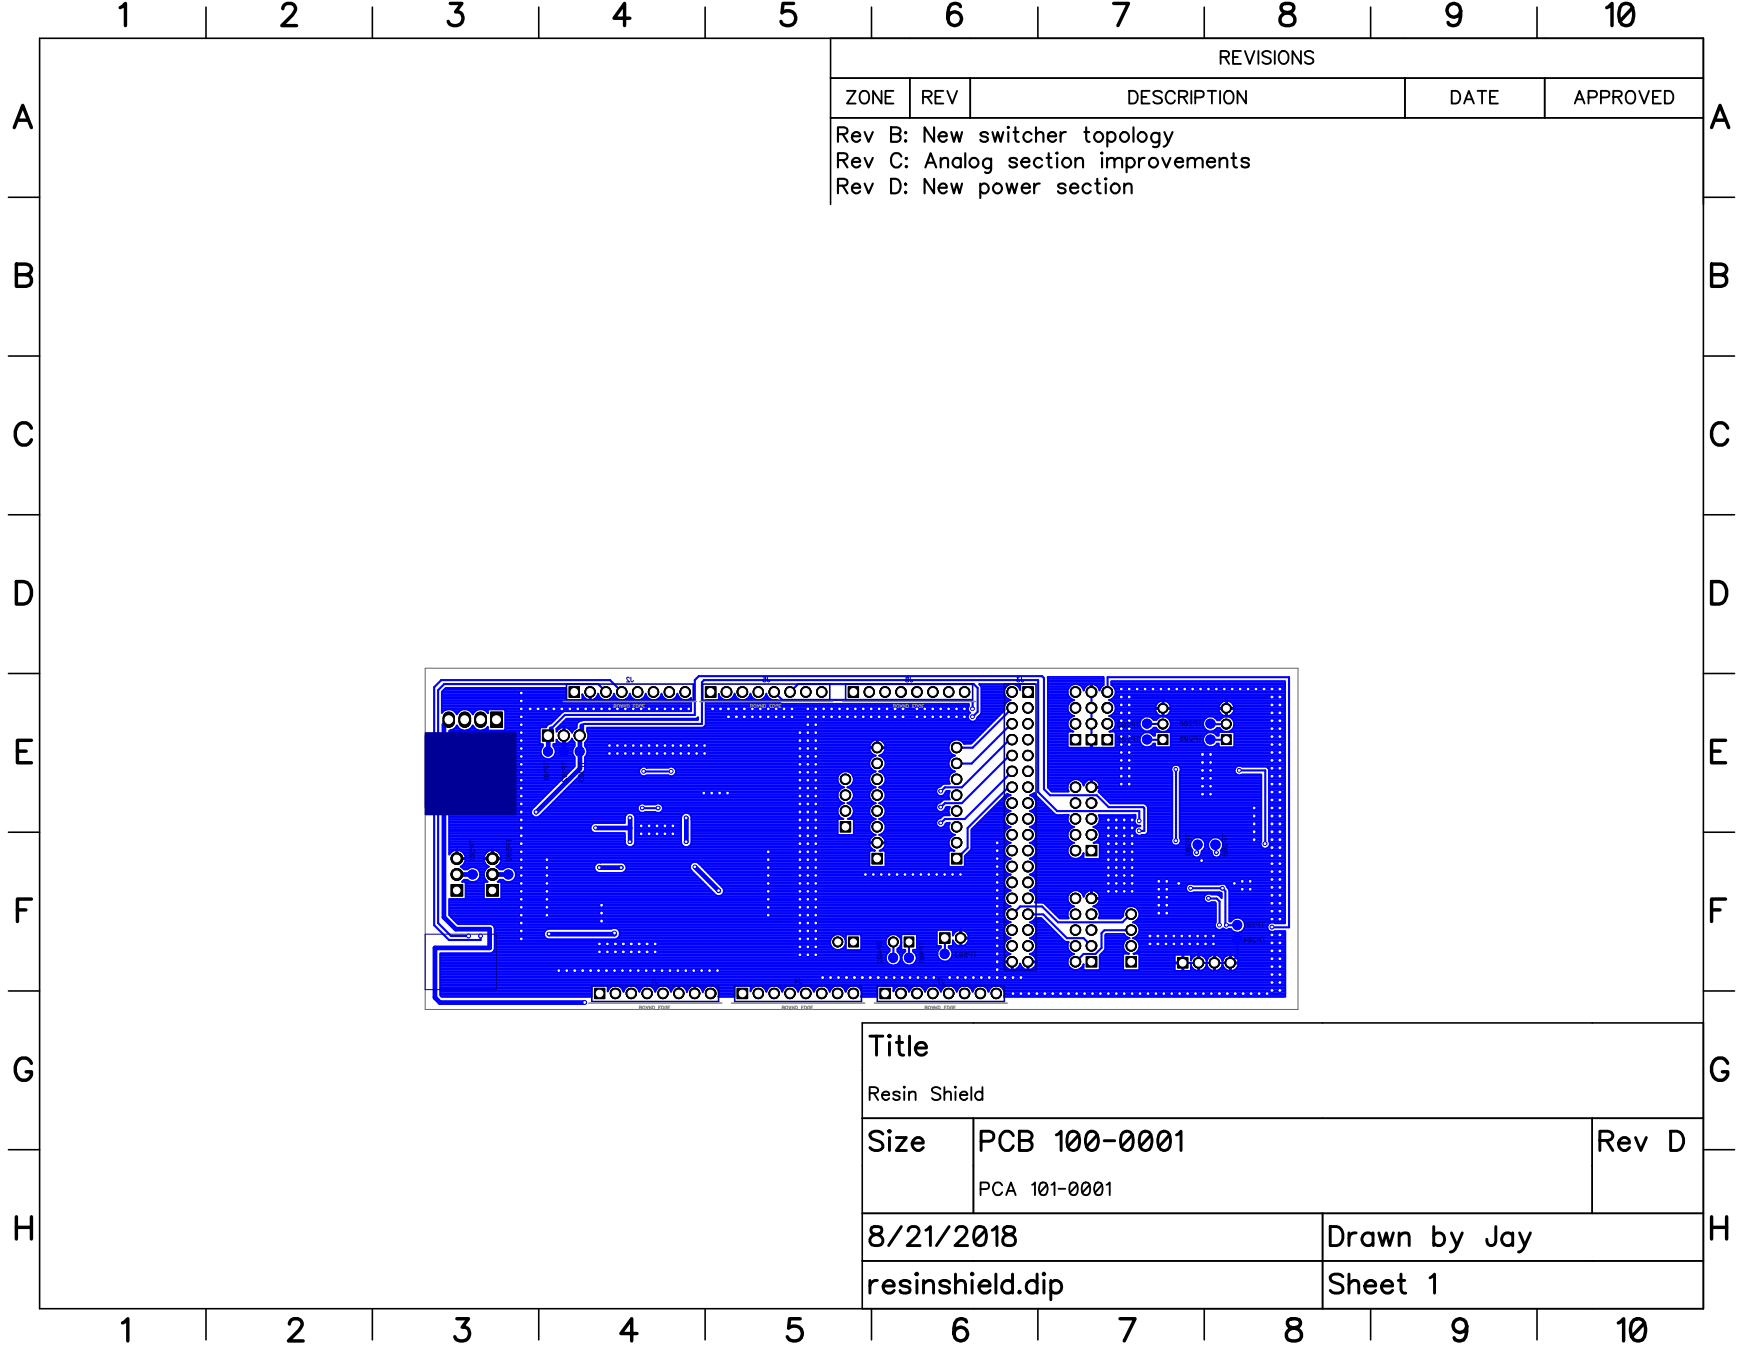
[picture p75: page 1]
