cruiser0002/ResinShield/RevD/DipTrace PCB - resinshield top.pdf

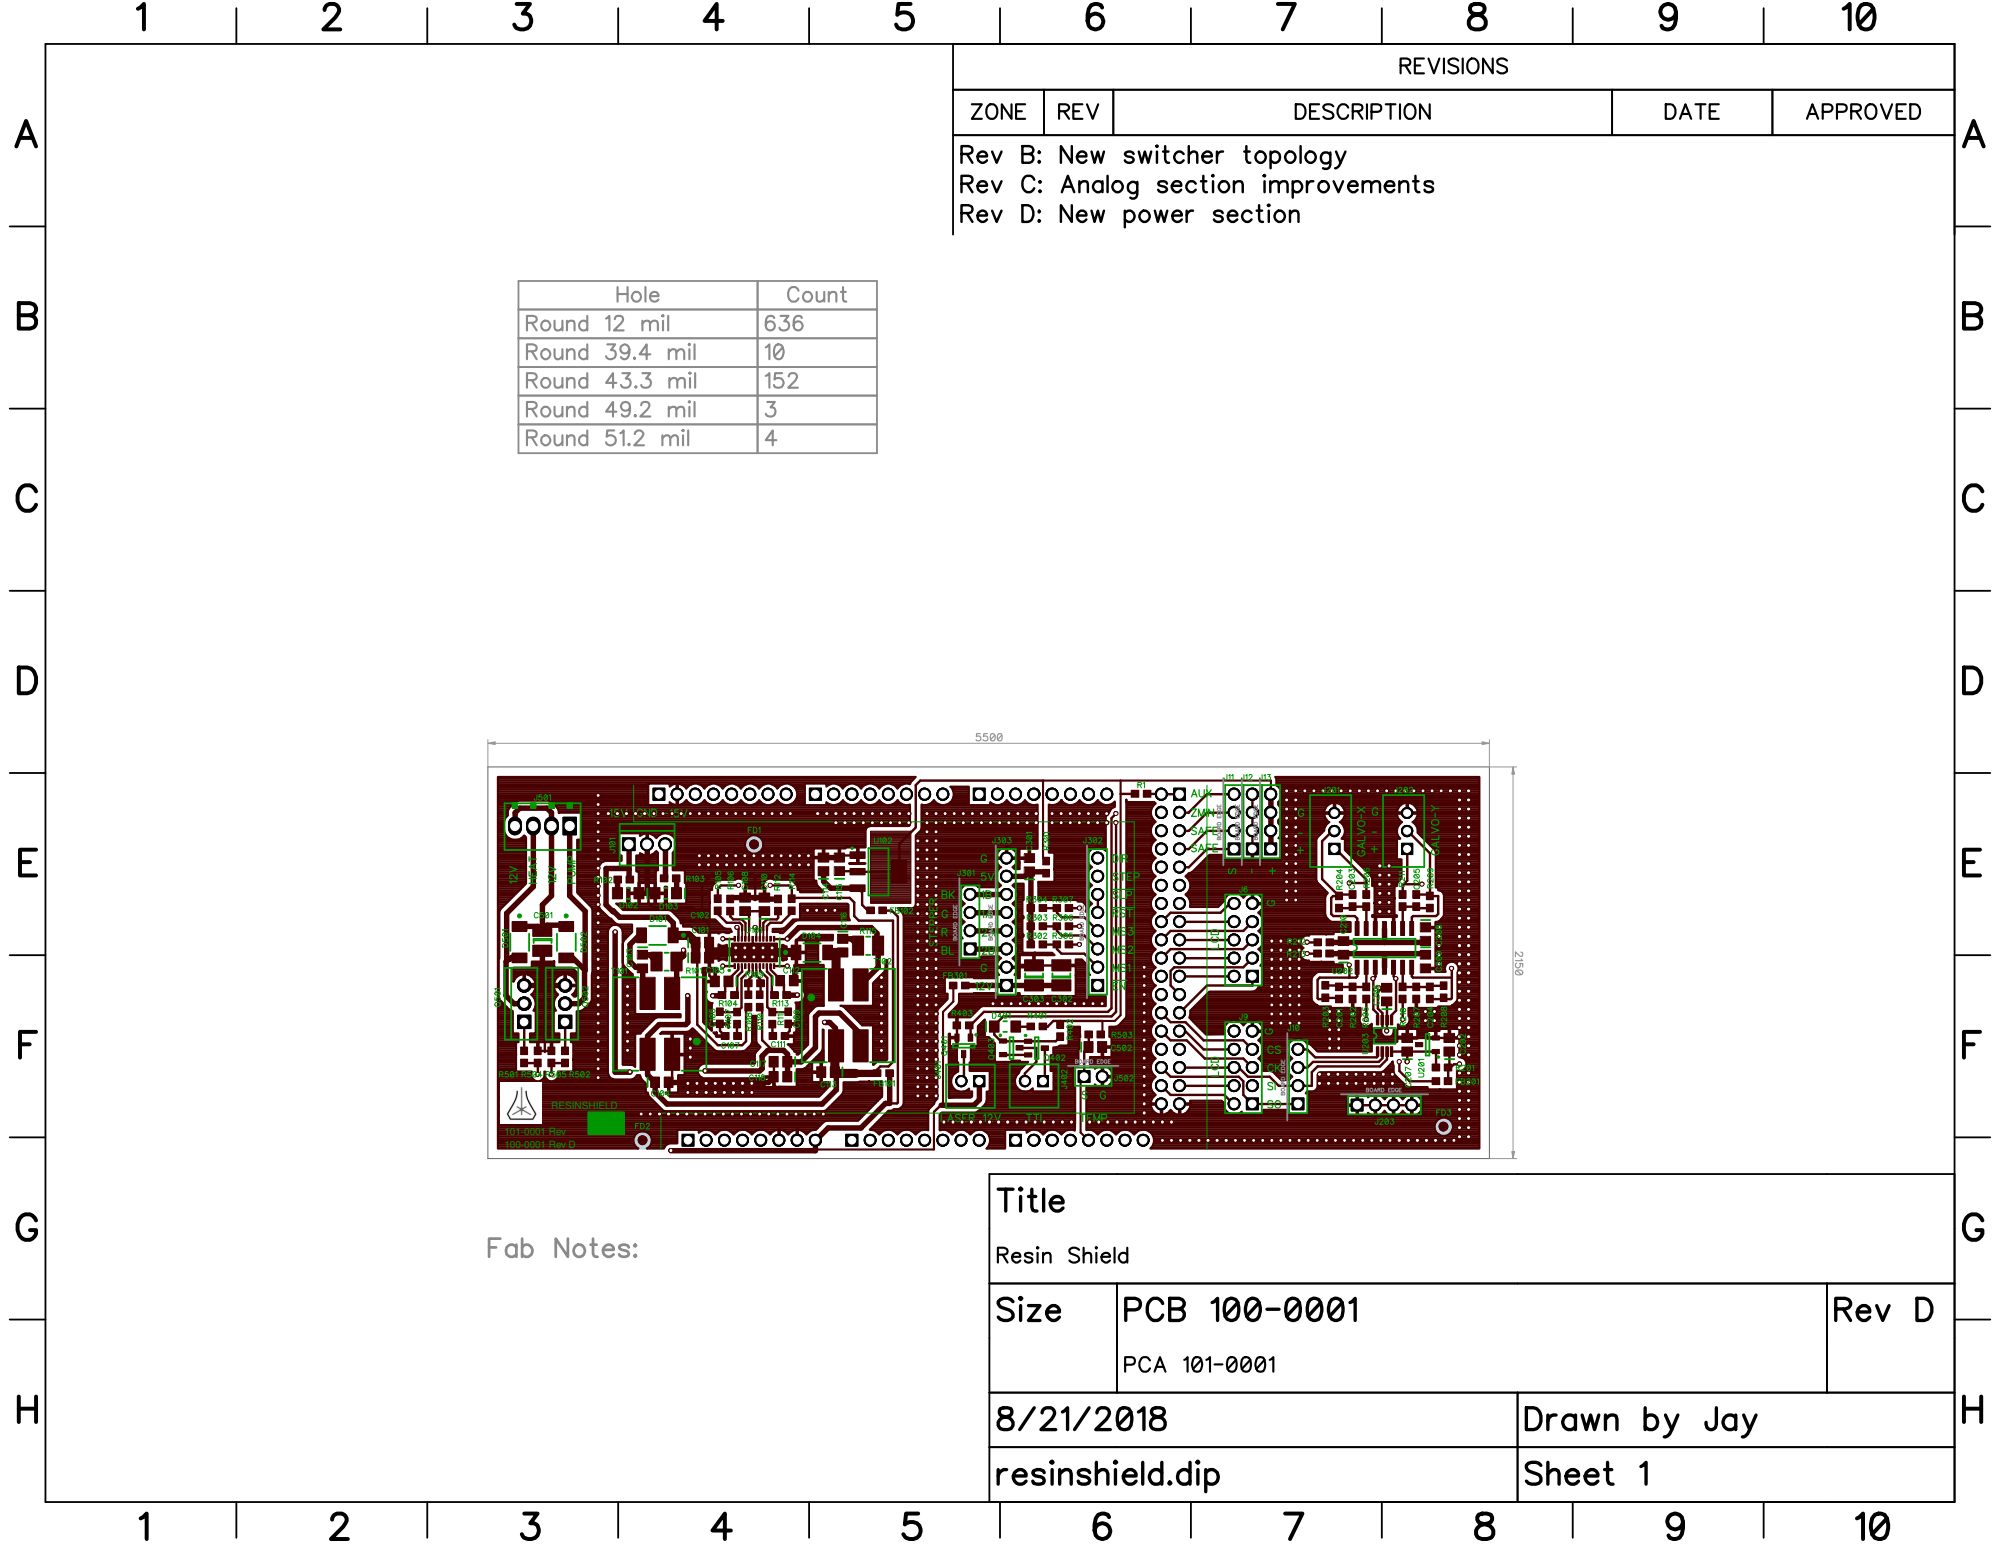
[picture p76: page 1]
100-0001 Rev D; 101-0001 Rev; RESINSHIELD
