cruiser0002/ResinShield/RevC/DipTrace PCB - resinshield back.pdf

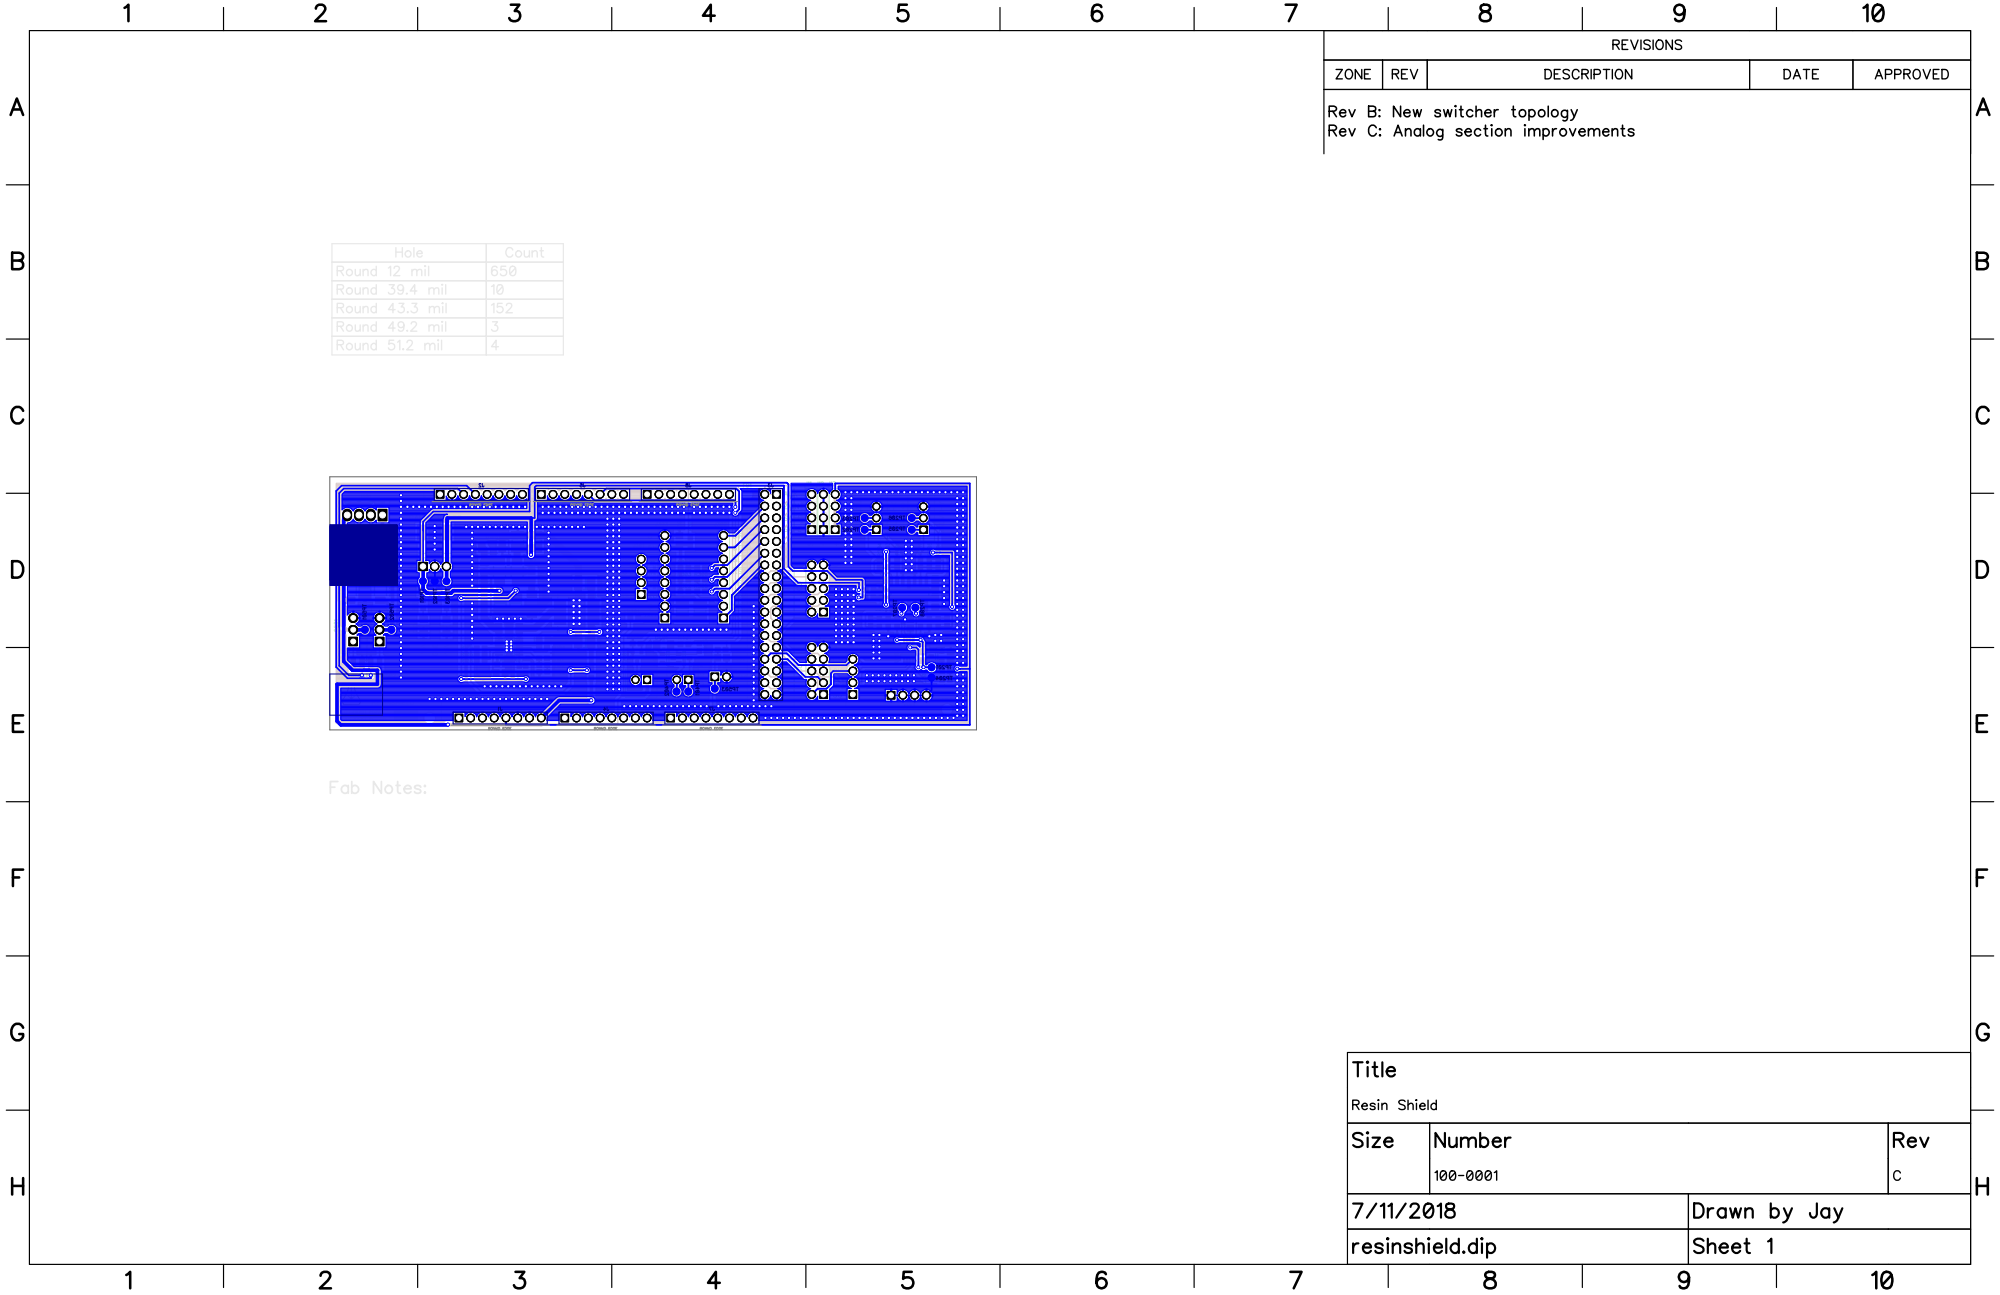
[picture p77: page 1]
100-0001 Rev C; 101-0001 Rev; RESINSHIELD
