cruiser0002/ResinShield/(list of files, drawings)

Other design files:
documentation/Mega Shield.dip
Older/resinshield2.dch
Older/resinshield2.dip
Older/resinshield3 - Copy.dch
Older/resinshield3.dch
Older/resinshield3.dip
Older/resinshield4.dch
Older/RS2A/resinshield2.dch
Older/RS2A/resinshield2.dip
Older/RS2C/resinshield2.dch
Older/RS2C/resinshield2.dip
Older/RS2D/resinshield2.dch
Older/RS2D/resinshield2.dip
Older/RS2E/resinshield2.dch
Older/RS2E/resinshield2.dip
Older/RS3A/resinshield3.dch
Older/RS3A/resinshield3.dip
Older/RS3B/resinshield3.dch
Older/RS3B/resinshield3.dip
Older/RS3C/resinshield3.dch
Older/RS3C/resinshield3.dip
Older/RS3D/resinshield3.dch
Older/RS3D/resinshield3.dip
Older/RS3E/resinshield3.dch
Older/RS3E/resinshield3.dip
resinshield2.dch
resinshield2.dip
resinshield3 - Copy.dch
resinshield3.dch
resinshield4.dch
resinshield - Copy.dip
resinshield.dch
resinshield.dip
RevA/resinshield.dch
RevA/resinshield.dip
RevB/resinshield.dch
RevB/resinshield.dip
RevC/resinshield.dch
RevC/resinshield.dip
RevD/resinshield.dch
RevD/resinshield.dip
RevE/resinshield.dch
RevE/resinshield.dip
RS2A/resinshield2.dch
RS2A/resinshield2.dip
RS2C/resinshield2.dch
RS2C/resinshield2.dip
RS2D/resinshield2.dch
RS2D/resinshield2.dip
RS2E/resinshield2.dch
RS2E/resinshield2.dip
RS3A/resinshield3.dch
RS3A/resinshield3.dip
RS3B/resinshield3.dch
RS3B/resinshield3.dip
RS3C/resinshield3.dch
RS3C/resinshield3.dip
RS3D/resinshield3.dch
RS3D/resinshield3.dip
RS3E/resinshield3.dch
RS3E/resinshield3.dip
