cruiser0002/ResinShield/(commit log)

2016-03-31 Corrected BOM for past mistakes
    [resinshield3.dch, resinshield3.dip]
2016-03-31 merged headers
    [resinshield3.dch, resinshield3.dip]
2016-04-28 latest revision with correct parts
    [resinshield3.dch, resinshield3.dip]
2016-04-28 RS3C update with BOM
    [BOM.xlsx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]
2016-05-01 latest bug fixes
    changed how fault works to be compatible with arduino
    [BOM.xlsx, resinshield3.dch, resinshield3.dip]
2016-05-02 fixed EN below gnd
    [resinshield3.dch, resinshield3.dip]
2016-10-16 updated resinshield3
    [ANSI A Landscape.dxf, ANSI A Portrait.dxf, ANSI B Landscape.dxf, ANSI C Landscape.dxf, ANSI D Landscape.dxf, ANSI E Landscape.dxf, Projection symbols.dxf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]
2016-11-17 RS3E release
    [Board.gbr, BoardOutline.gbr, Bottom.gbr, BottomAssy.gbr, BottomDimension.gbr, BottomMask.gbr, BottomPaste.gbr, BottomSilk.gbr]
2016-12-29 updated EN/UVLO network
    [resinshield3.dch, resinshield3.dip]
2016-12-30 fixed blow up issue
    [resinshield3.dch, resinshield3.dip]
2016-12-30 added fault LED
    [resinshield3.dch, resinshield3.dip]
2018-07-12 Complete Redo
    [BOM.csv, BOM.xlsx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]
2018-07-15 updated bom
    [BOM.csv, resinshield.dch]
2018-09-12 Rev E
    [BOM.csv, BOM.xlsx, BOMquote.xlsx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]
2018-09-14 added laser driver
    [BOM.csv, PickPlace.csv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]
2018-09-14 bom update
    [BOM.csv, BOM.xlsx, BOMquote.xlsx, resinshield.dch]
2018-09-14 updated backup
    [resinshield.dch, resinshield.dip]
2018-09-27 Rev F
    [BOM.csv, BOM.xlsx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]
